NickelsLab/open-source-rover/electrical/pcb/README.md

# Control Board Assembly, v2.0.3

The overall Control Board consists of a Motor Board with a Brain Board mounted on top. These are the instructions to assemble these two separate pcbs and mount them together as the unified control board.

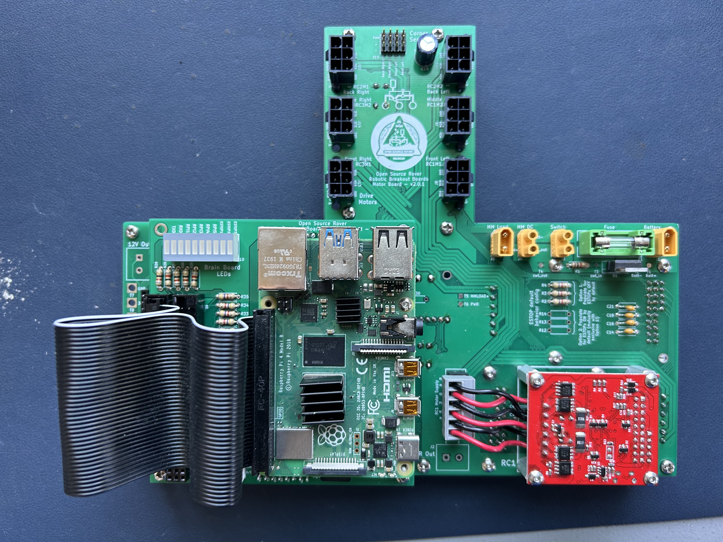
[picture p1: electrical/pcb/images/assembled/complete_pcb_top.jpg]


This document goes through the process of assembling and testing the custom
Printed Circuit Boards for the project. 

Note that the images in these instructions are taken from an assembly of the v2.0.1 board. There are minimal differences between v2.0.1 and v2.0.3 - such that it wasn't worth doing another photoshoot for v2.0.3. Make sure to follow the written instructions when in doubt.

## Table of Contents
1. [Part References](#1-part-references)
2. [Schematic and Layout Documentation](#2-schematic-and-layout-documentation)
3. [Motor Board Assembly](#3-motor-board-assembly)
4. [Brain Board Assembly](#4-brain-board-assembly)
5. [Motor Board and Brain Board Mating](#5-motor-board-and-brain-board-mating)
6. [Testing the PCB and wiring for the Drive Motors](#6-testing-the-pcb-and-wiring-for-the-drive-motors)

## 1. Part References 

Check out the [BOM documents](control_board/BOM)

All parts referenced in these instructions use the schematic "reference designator" from the silk screen on the pcbs. E.g. "C1", "J2", and "R28". You should look up the details of these parts within the [v2.0.3 BOM the board ref parts spreadsheet](control_board/BOM/bom_v2.0.3_board_ref_parts.csv) or the [v2.0.3 BOM other parts spreadsheet](control_board/BOM/bom_v2.0.3_other_parts.csv). This will tell you the unique ID of the part that we use for ordering from Digikey + elsewhere, and will also link to pictures of the part on the relevant website.

Generally these instructions have enough images to clearly show and identify the parts, but whenever in doubt the best thing to do is to look up the reference in the BOM spreadsheet.

## 2. Schematic and Layout Documentation

You can see the KiCAD files in the repo, or see documentation of both the schematics (how all the
electrical parts logically connect to one another) and the layout (how the parts are physically
placed on the boards) in the [control_board/documentation](control_board/documentation) directory.
The documentation directory contains:
- [control_board/documentation/3d_images](control_board/documentation/3d_images) - renderings of each of the two boards
- [control_board/documentation/layout](control_board/documentation/layout) - SVG files of each layer individually and of the entire board, for both boards.
- [control_board/documentation/schematics.pdf](control_board/documentation/schematics.pdf) - schematics as a PDF

For notes on *why* the schematic is drawn the way it is -- KiCad power-port and
PWR_FLAG conventions, the reference-designator policy when revving the board, and
per-component notes on the LM358, Roboclaw, RPi, regulators, INA260 and PCA9685 --
see [control_board/README_schematic.md](control_board/README_schematic.md).

## 3. Motor Board Assembly

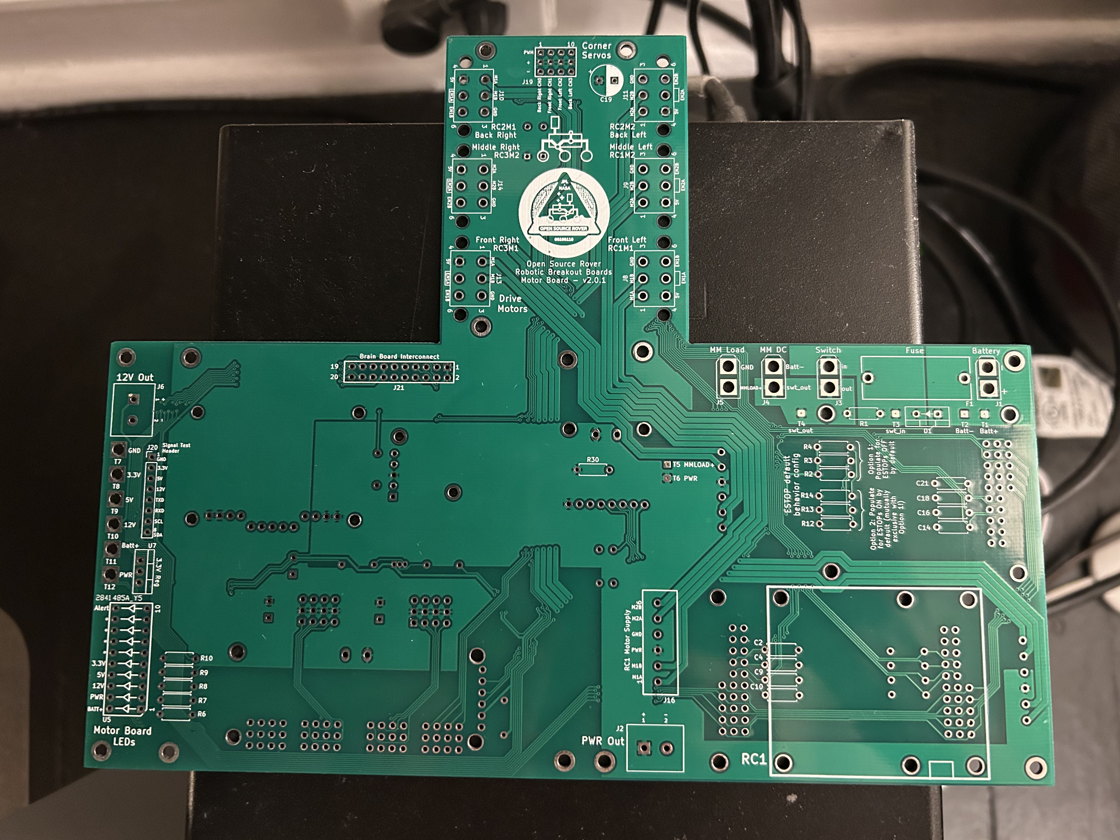
[picture p2: electrical/pcb/images/assembly/bare_board.jpg]
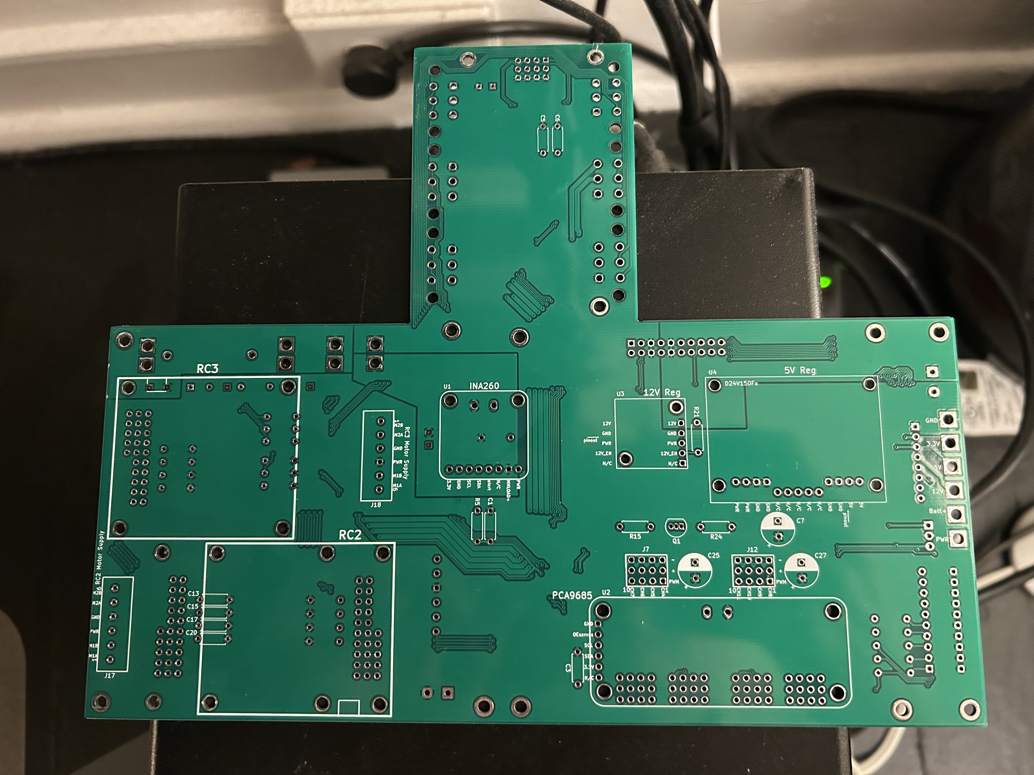
[picture p3: electrical/pcb/images/assembly/bare_board_bottom.jpg]
|    |
|:-:|
| Figure 3.0: front (left) and back (right) of motor board |

### 3.1 Attach standoffs

Attach M2.5 x 30mm standoffs to the bare board, for ease of future soldering work.

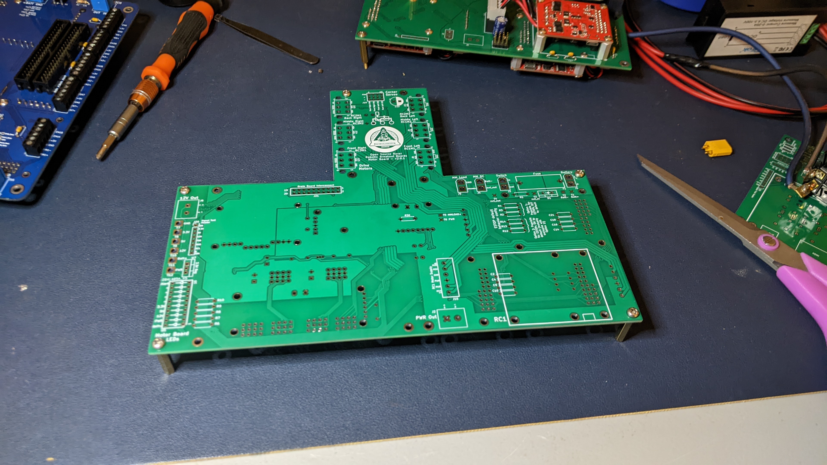
[picture p4: electrical/pcb/images/assembly/PXL_20230413_052035126.jpg]
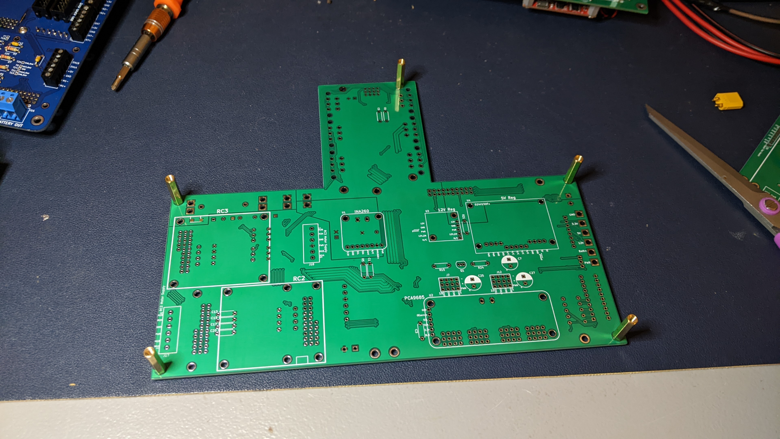
[picture p5: electrical/pcb/images/assembly/PXL_20230413_052039855.jpg]
|   |
|:-:|
| Figure 3.1: Standoffs attached |

### 3.2 Solder on power headers and fuse holder

Solder on the XT30 headers for footprints J1, J3, J4, and J5, as well as the fuse holder F1.

Make sure to choose the proper XT30 header for the corresponding J footprint:
- J1: male
- J3: female
- J4: female
- J5: male
See the images to clarify which one is which.

The pins on the XT30 will be slightly smaller than the holes on the board - this is fine, just make sure to use a lot of solder to connect them so there's a good mechanical connection. The soldering should be fairly straightforward once you start. 

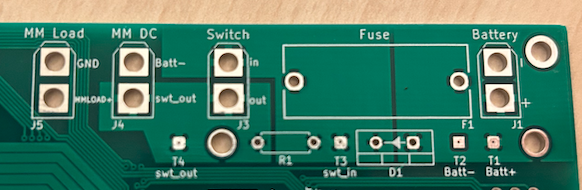
[picture p6: electrical/pcb/images/assembly/power_headers.png]
|  |
|:-:|
| Figure 3.2: Power headers + fuse holder footprints |

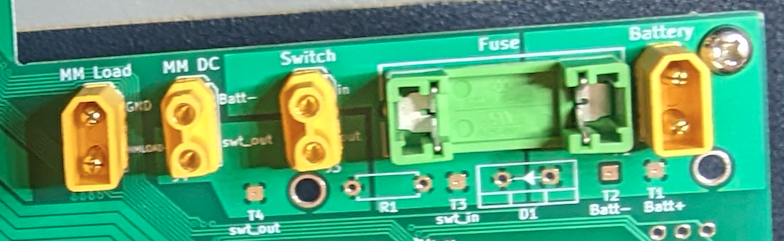
[picture p7: electrical/pcb/images/assembly/power_headers_attached.png]
|  |
|:-:|
| Figure 3.3: Power headers + fuse holder attached |

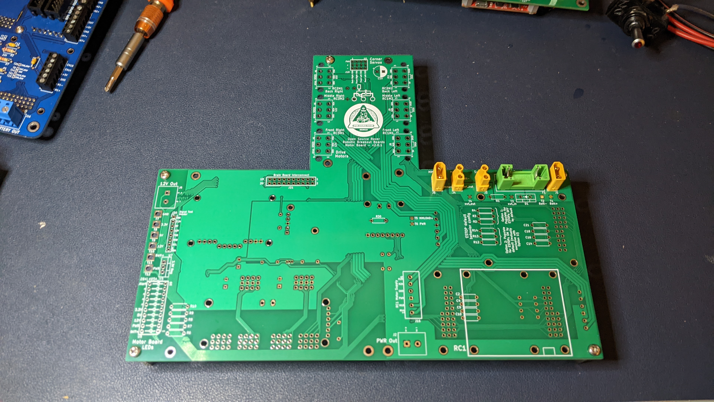
[picture p8: electrical/pcb/images/assembly/PXL_20230413_052422615.jpg]
|  |
|:-:|
| Figure 3.4: Power headers and fuse holder attached, zoomed out |

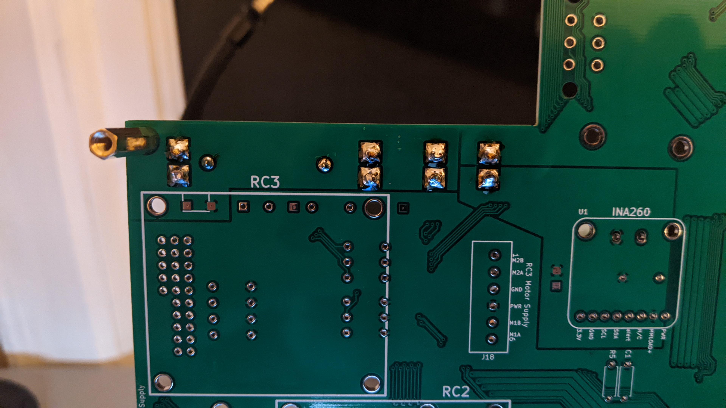
[picture p9: electrical/pcb/images/assembly/PXL_20230413_054441445.jpg]
|  |
|:-:|
| Figure 3.5: Close up view of soldered footprints for headers |

### 3.3 Solder resistor R1 and power diode D1

Make sure to attach D1 in the correct orientation!

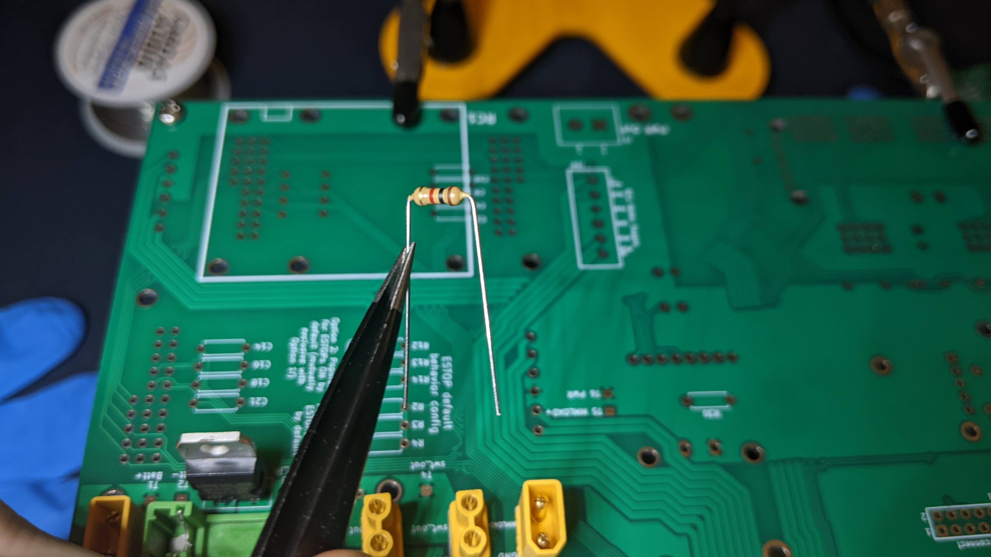
[picture p10: electrical/pcb/images/assembly/PXL_20230413_054943541.jpg]
|  |
|:-:|
| Figure 3.6: Resistor R1 |

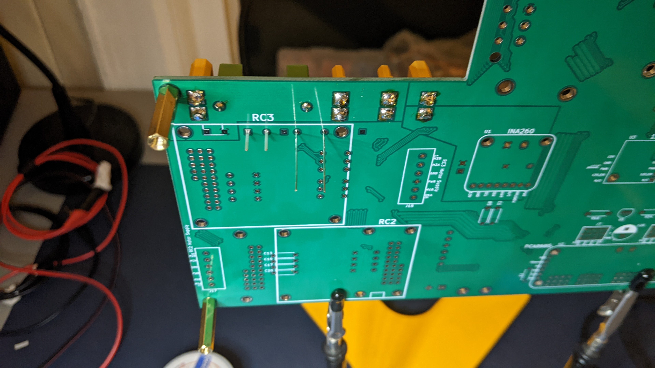
[picture p11: electrical/pcb/images/assembly/PXL_20230413_055134872.MP.jpg]
|  |
|:-:|
| Figure 3.7: Through hole leads for R1 and D1 |

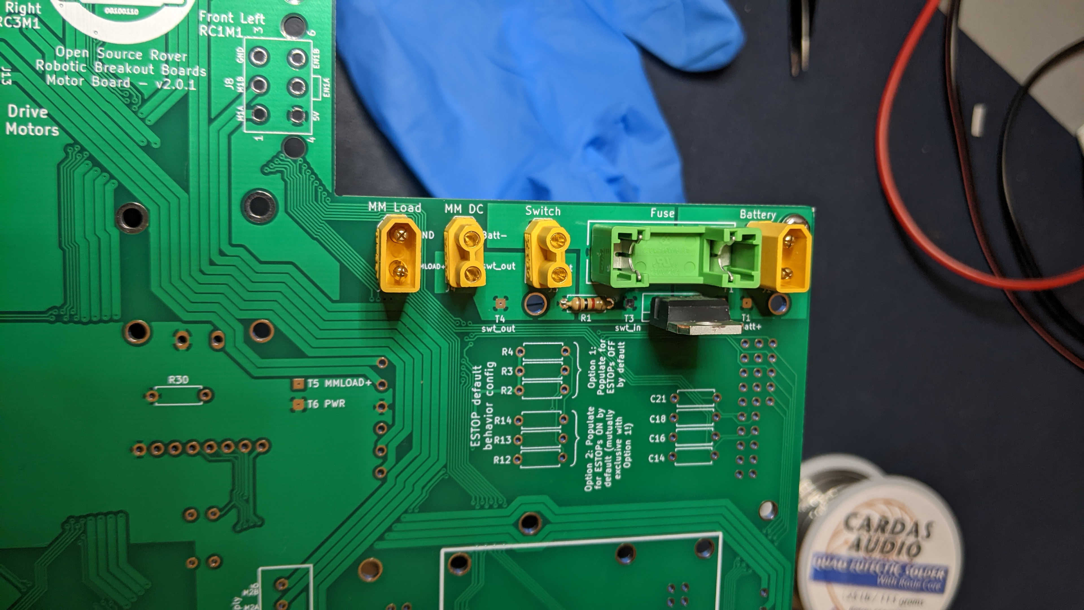
[picture p12: electrical/pcb/images/assembly/PXL_20230413_055558226.jpg]
|  |
|:-:|
| Figure 3.8: R1 and D1 attached |

### 3.4 Test the power connectors

Insert a fuse (part# B1) into the fuse holder (as shown in Figure 3.8 below)

Using the appropriate matching XT30 connectors, connect the power headers to a power supply (or your battery), the main external power switch (part# B9), and the multimeter (part# B10)

Use these diagrams to determine how to wire things together:

When testing with a power supply, provide 14.8V DC and current limit to 1.0A. Just to the left of the main fuse is a XT30 connector labeled "Switch" – this if for the main on/off toggle switch. The XT30 connectors labeled MM Load and MM DC connect to the multimeter box.

> [!Note]
> If you have already installed capacitors on the board, it is normal for power header J5 (MM Load) to briefly beep for less than a second when testing for continuity after soldering the power headers. This occurs because the capacitors momentarily charge. This behavior is expected and does not indicate a short circuit.

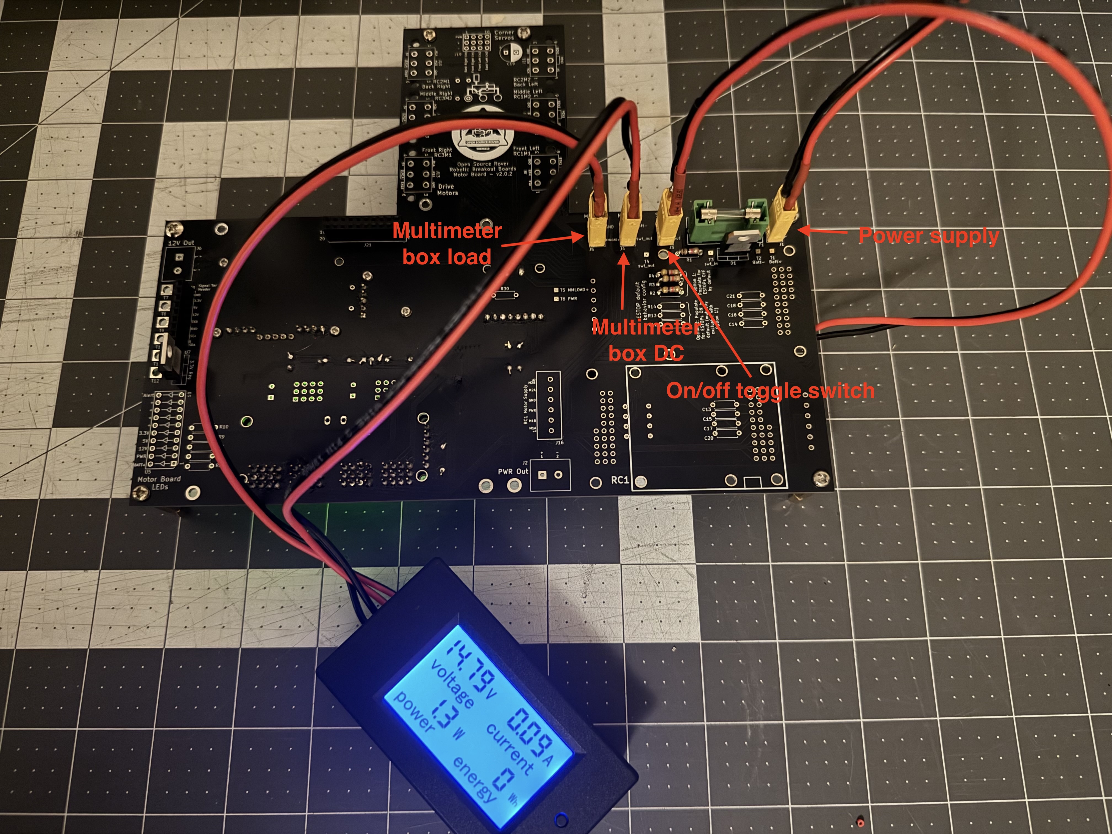
[picture p13: electrical/pcb/images/assembly/controlboard-power-headers.jpeg]
 |  |
|:-:|
| Figure 3.9: Power headers connected to the power supply, on/off toggle switch (out of view under the PCB) and multimeter box. |

After testing, make sure to disconnect the power supply.

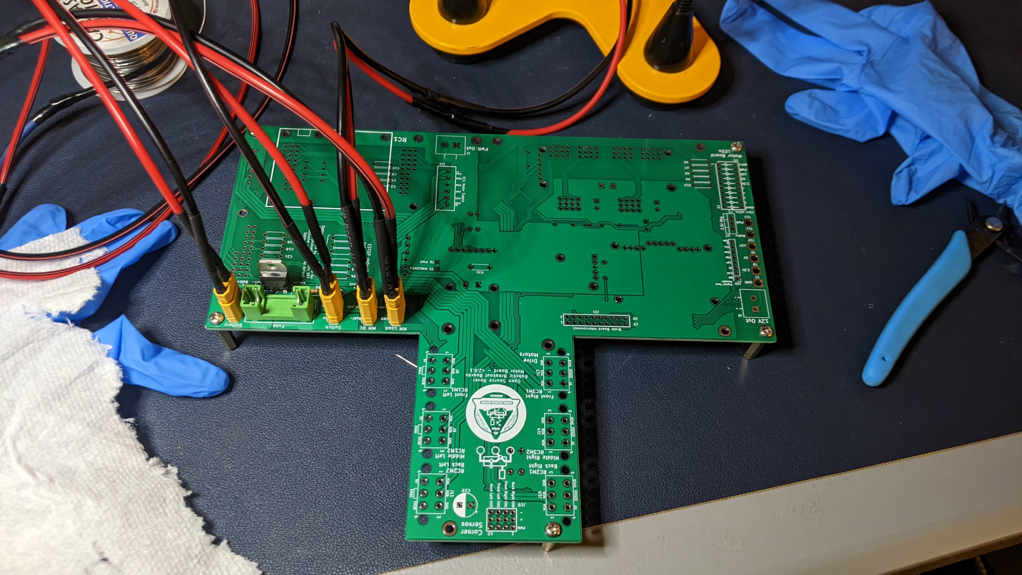
[picture p14: electrical/pcb/images/assembly/PXL_20230413_061454863.jpg]
|  |
|:-:|
| Figure 3.10: Wires connected to power headers |

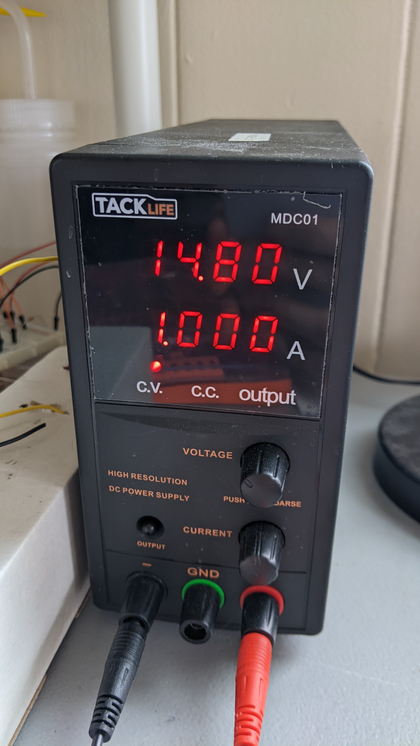
[picture p15: electrical/pcb/images/assembly/PXL_20230416_234516660.jpg]
|  |
|:-:|
| Figure 3.11: Power supply providing 14.8V DC and current limited to 1.0A |

Use a multimeter to test the voltage between test points T4 ("swt_out") and T2 ("Batt-"). This should read the same value as input from the power supply/battery (14.8V)

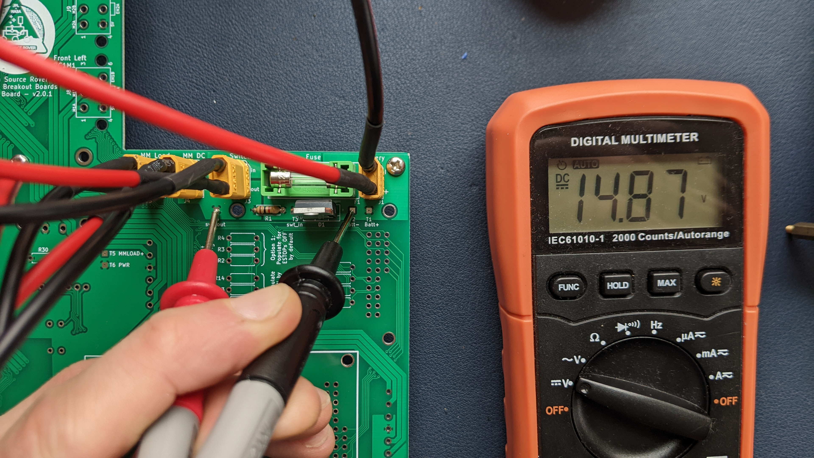
[picture p16: electrical/pcb/images/assembly/PXL_20230416_234547696.jpg]
|  |
|:-:|
| Figure 3.12: Testing the voltage between T4 and T2 |

Also check the voltage shown by the multimeter. This should show the same voltage as well.

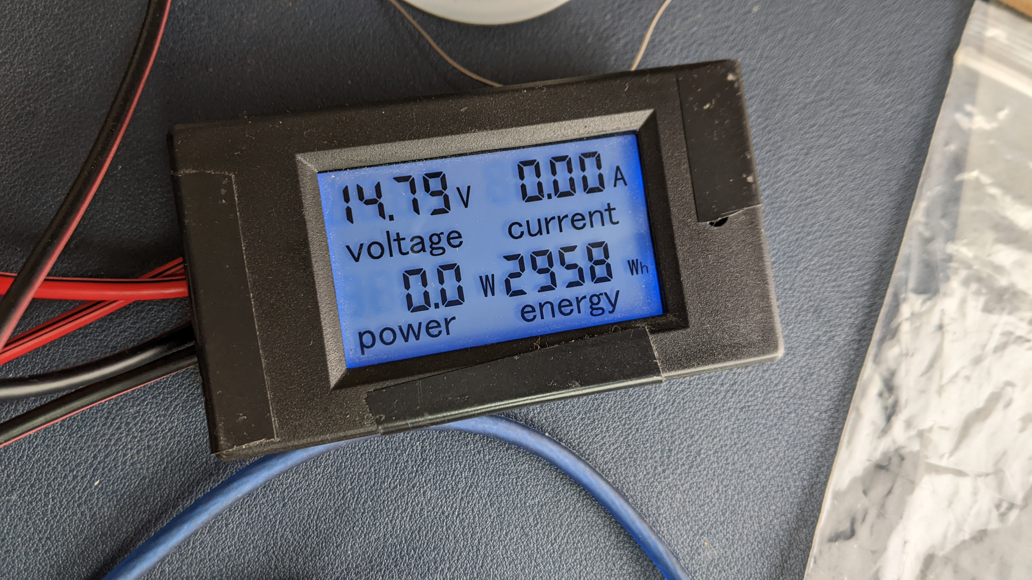
[picture p17: electrical/pcb/images/assembly/PXL_20230416_234553055.jpg]
|  |
|:-:|
| Figure 3.13: Testing the power input to the multimeter |

### 3.5 Install the INA 260

:exclamation: Before continuing, make sure to disconnect the power supply from the previous step! You should not have the board powered on while installing components. :exclamation:

The INA260 daughter board is used for digital sensing of voltage and current, measurements that the raspberry pi can query over an I2C connection. Unfortunately, it can be hard to find these INA260 parts nowadays - if you can't find one you will need to bypass U1, because it is in the path of the battery positive side supply.

**Option 1: If you have an INA260 daughter board, you should install that in footprint U1 on the bottom side of the motor board.**

See [control_board/README_schematic.md](control_board/README_schematic.md) for part numbers for inter-board pins and sockets.

1. Attach 8x1 female header sockets to the eight pads on the bottom side of the INA260 / U1 footprint, as seen in Figure 3.14.  This is sensing the current on the high side of the power, so PWR on the the Motor Board is connected to Vin+ on the INA260, and Vin- on the INA260 is connected to MMLOAD+, which connects to the main power bus of the rover.
2. Attach 3x1 female header socket (cut from a longer Nx1 header) to the two pads on the bottom side of the INA260 / U1 footprint, as seen in Figure 3.14. You'll need to manually remove the center pin, as there is no hole/pad on the brain board.

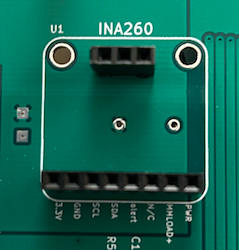
[picture p18: electrical/pcb/images/assembly/ina260_headers.png]
|  |
|:-:|
| Figure 3.14: Sockets on U1 footprint installed |

3. Attach 8x1 male header pins to the underside of the INA260, as seen in Figure 3.15
4. Remove the center pin from a 3x1 male header pins, and solder to the INA260.

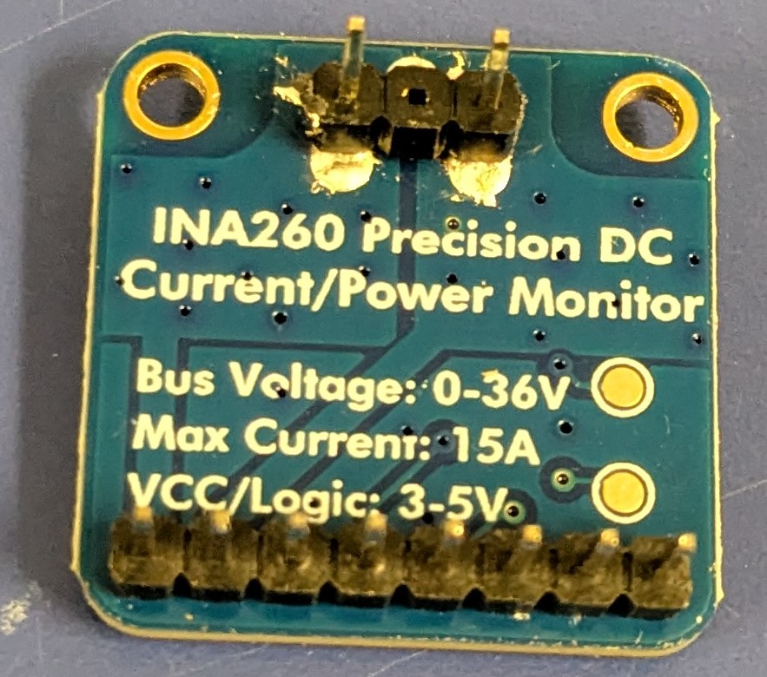
[picture p19: electrical/pcb/images/assembly/INA260_Bottom.jpg]
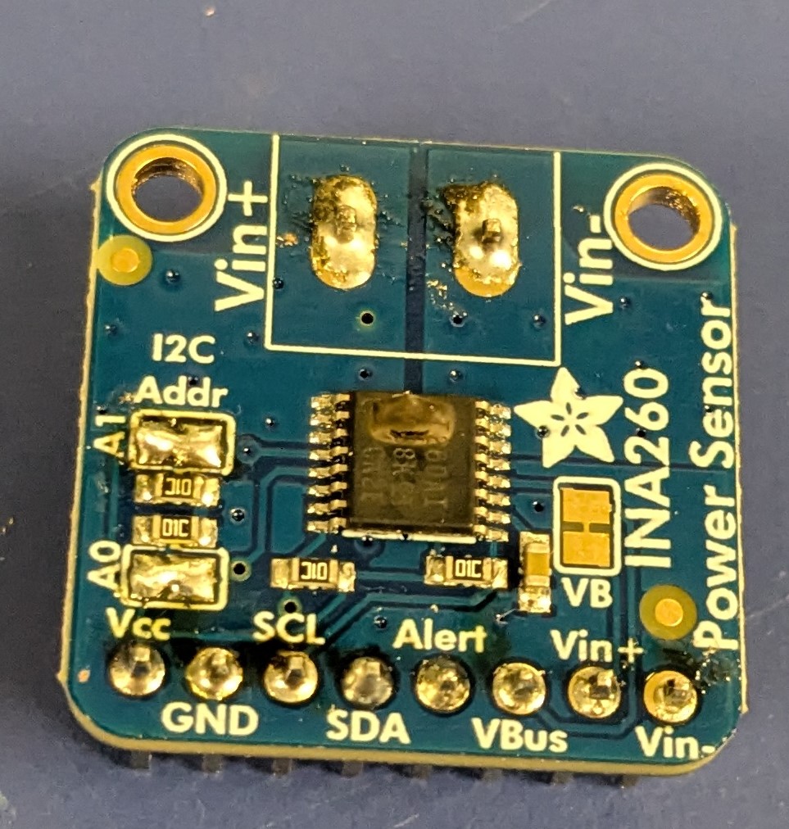
[picture p20: electrical/pcb/images/assembly/INA260_Top.jpg]
|   |
|:-:|
| Figure 3.15: INA260 Pins installed |

5. Solder across pads A0 and A1 on the INA260 (to set it to use I2C Address 0x45)
6. Insert the INA260 male pins into the U1 female sockets, as shown in Figure 3.16
6. Optionally, install M2.5 x 12mm + 6mm standoffs between the motor board and the INA260.

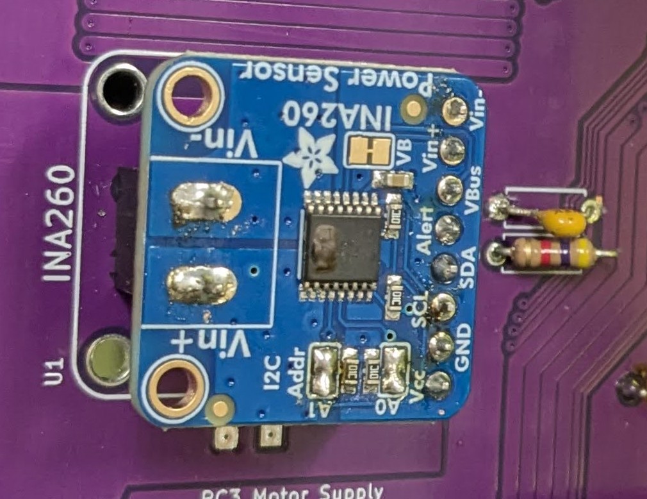
[picture p21: electrical/pcb/images/assembly/INA260_Installed.jpg]
|  |
|:-:|
| Figure 3.16: Headers on INA260 installed |

**Option 2: If you don't have one, you will need to bypass U1**

If you don't have an INA260, simply install a 0 ohm resistor (or a wire) in footprint R30, on the top side of the board, as shown in Figure 3.17.

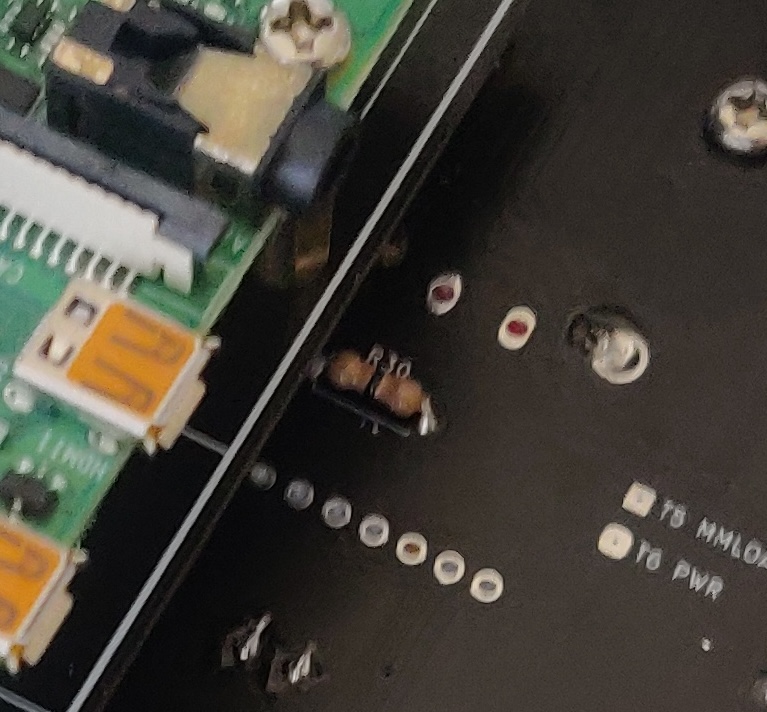
[picture p22: electrical/pcb/images/assembly/ina260_bypass.jpg]
|  |
|:-:|
| Figure 3.17: INA260 bypassed |

### 3.6 Install 5V bus regulator

This is the power regulator for the 5V line, which powers all the motors.

Install 3 female headers for the daughter board, into U4. You will need a two 4x1's, and a 5x1.

|  |
|:-:|
| Figure 3.18: 5V regulator headers installed |

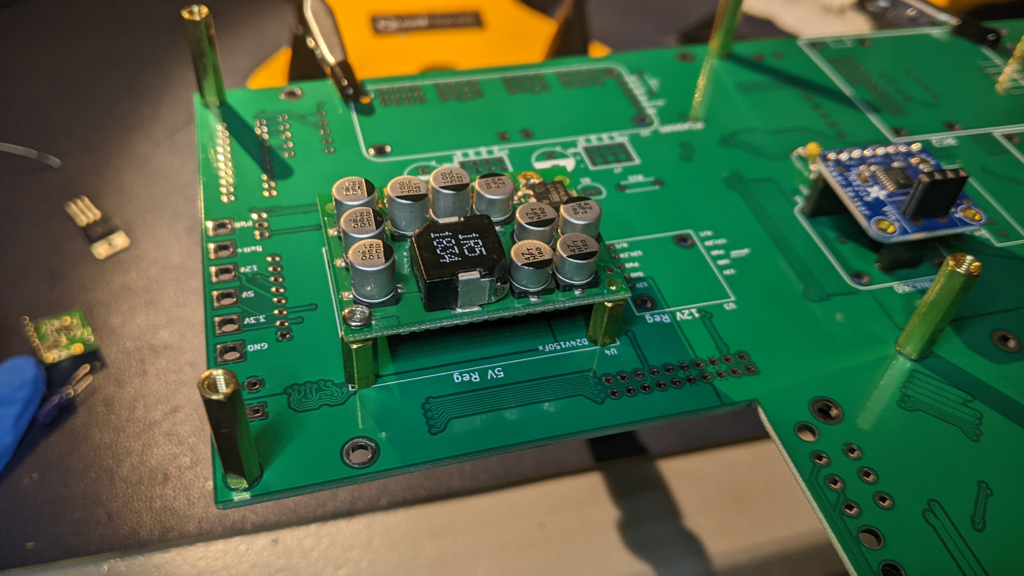
[picture p23: electrical/pcb/images/assembly/PXL_20230418_044810169.jpg]
|  |
|:-:|
| Figure 3.19: 5V regulator installed |

### 3.7 Install 12V bus regulator U3

Solder a 5x1 female header to the U3 footprint, and attach M2.5 x 10mm standoffs between the regulator and motor board

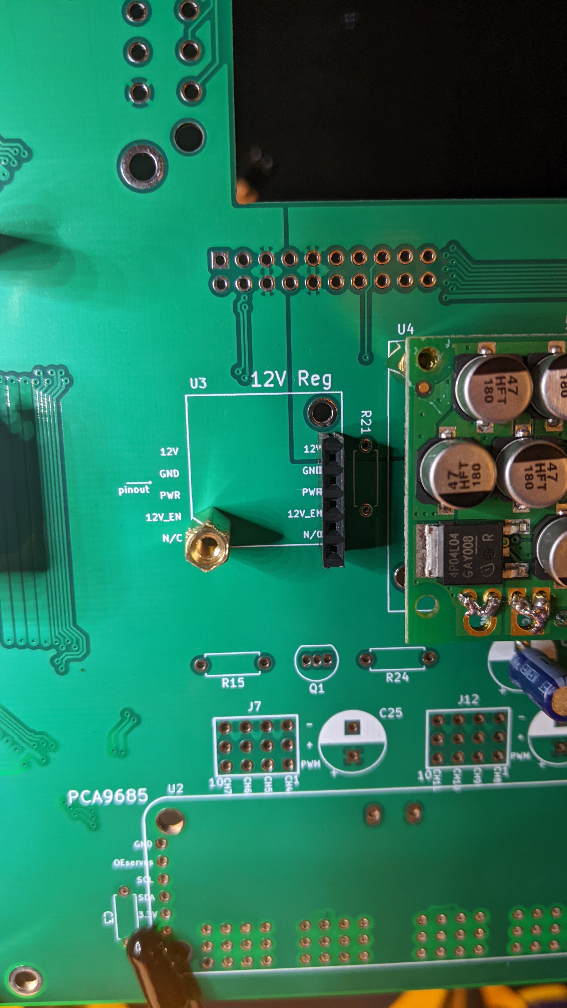
[picture p24: electrical/pcb/images/assembly/PXL_20230418_050503408.jpg]
|  |
|:-:|
| Figure 3.20: U3 footprint |

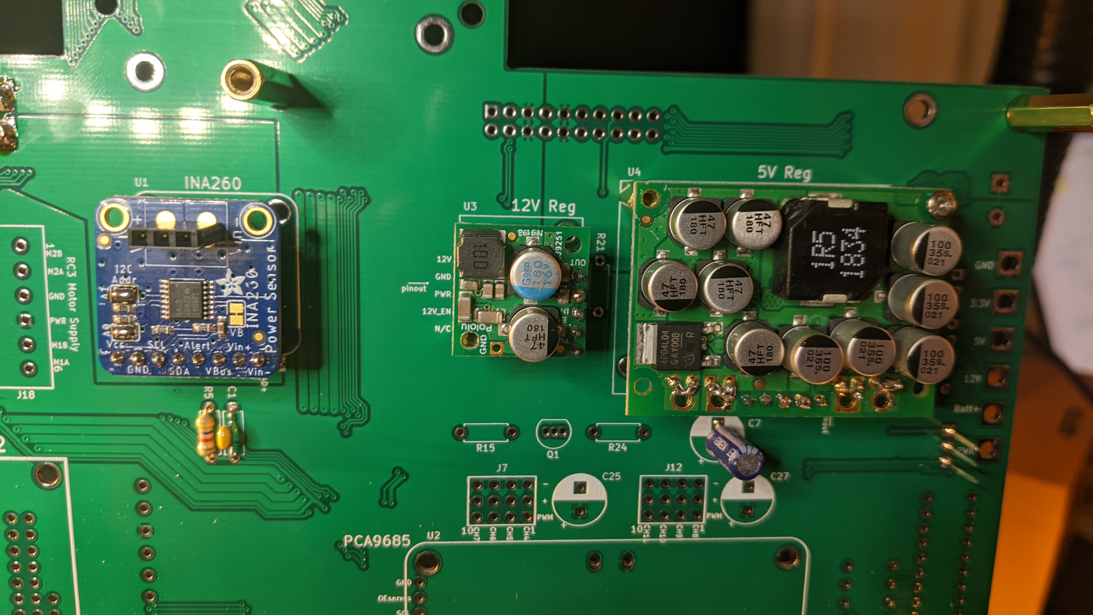
[picture p25: electrical/pcb/images/assembly/PXL_20230418_051040927.jpg]
|  |
|:-:|
| Figure 3.21: 12v regulator installed |

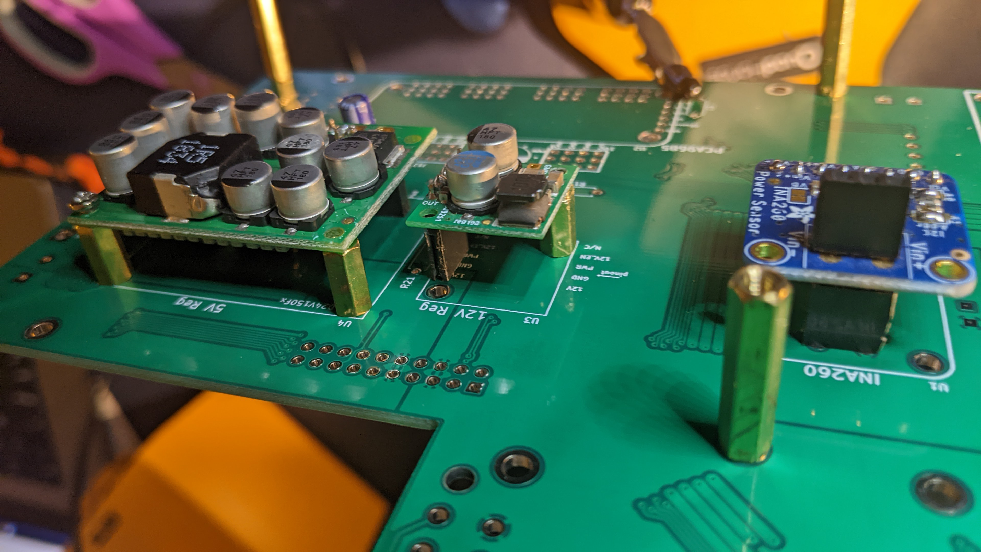
[picture p26: electrical/pcb/images/assembly/PXL_20230418_051046001.MP.jpg]
|  |
|:-:|
| Figure 3.22: 12v regulator installed (2) |

### 3.8 Install 3.3V bus regulator U7 and decoupling capacitor C7

The 3.3V bus regulator is a linear voltage regulator and is physically much smaller - it comes in the same packaging as diode D1. Make sure to install the regulator in the correct direction as shown in Figure 3.24.

Capacitor C7 is the decoupling capacitor for the 3.3v bus. Make sure to install C7 in the proper direction, as shown in Figure 3.25. One side of the capacitor has negative polarity indicators on it, that should be installed opposite the "+" sign on the footprint.

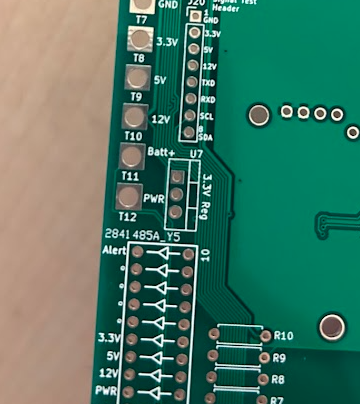
[picture p27: electrical/pcb/images/assembly/u7_bare.png]
|  |
|:-:|
| Figure 3.23: U7 footprint |

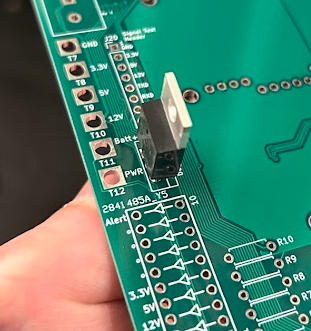
[picture p28: electrical/pcb/images/assembly/u7_installed.png]
|  |
|:-:|
| Figure 3.24: 3.3v regulator installed in U7 |

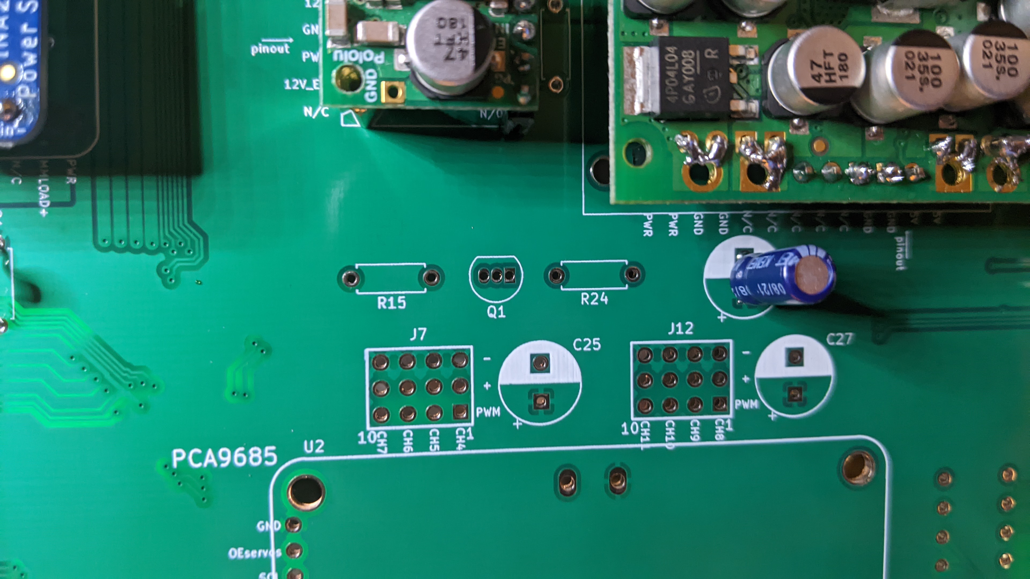
[picture p29: electrical/pcb/images/assembly/PXL_20230418_051556901.MP.jpg]
|  |
|:-:|
| Figure 3.25: Capacitor C7 installed |

### 3.9 Install resistors R15, R24, and BJT transistor Q1

These form the circuit for the alert signal LED logic.

|  |
|:-:|
| Figure 3.26: R15, R24, and Q1 footprints |

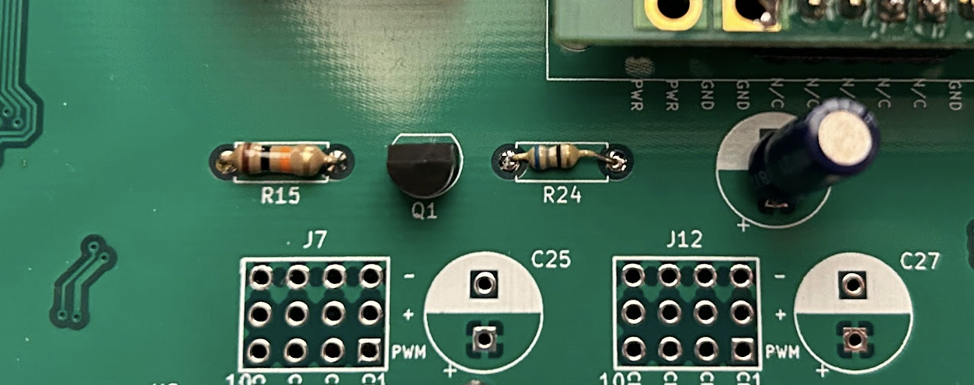
[picture p30: electrical/pcb/images/assembly/alert_led_components.png]
|  |
|:-:|
| Figure 3.27: R15, R24, and Q1 installed |

### 3.10 Test all voltage lines

Test all the power buses/voltage lines using the test points on the far left side of the top side of the board (T7 through T12).

The silk screen right of each hole indicates what voltage each test point should be at.

- First, connect the power supply to your board and provide 14.8v (see step 3.4)
- then, use the multimeter to test the voltage at each test point

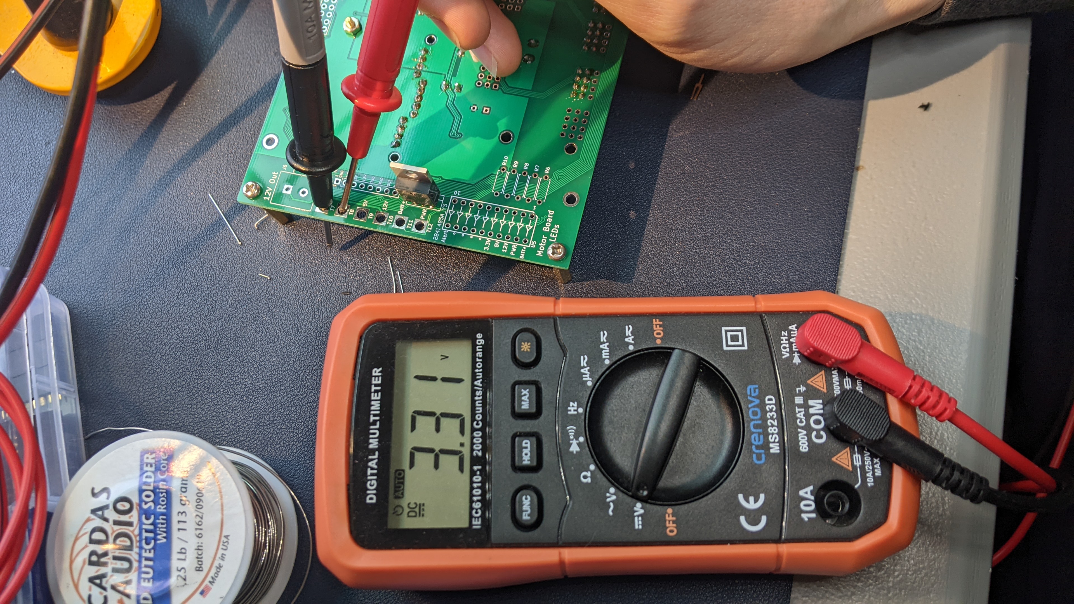
[picture p31: electrical/pcb/images/assembly/PXL_20230424_003614642.jpg]
|  |
|:-:|
| Figure 3.28: testing the 3.3v bus|

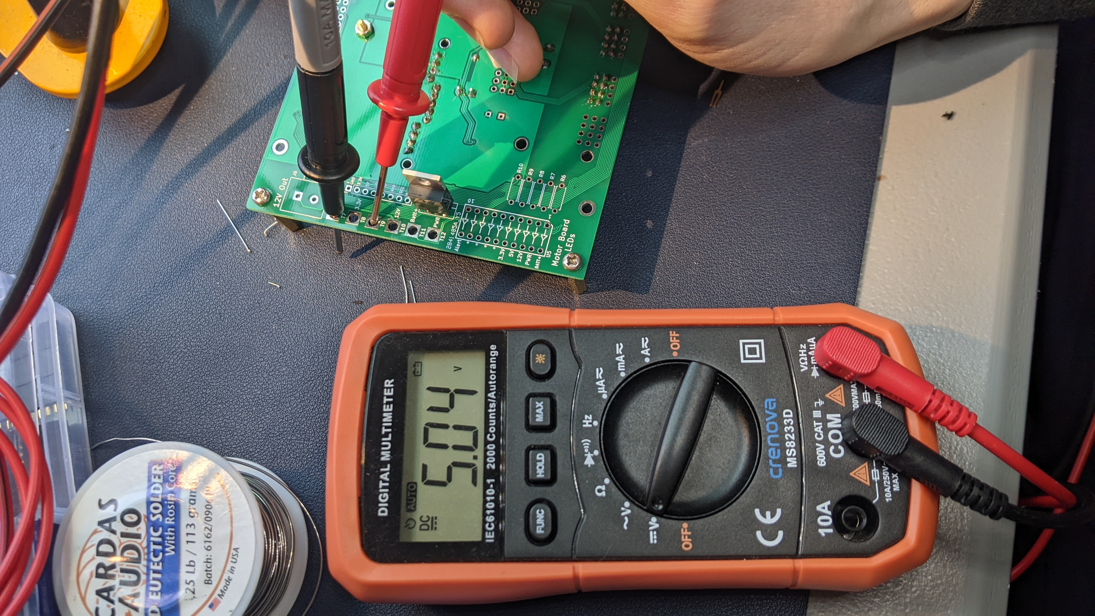
[picture p32: electrical/pcb/images/assembly/PXL_20230424_003617280.jpg]
|  |
|:-:|
| Figure 3.29: testing the 5v bus |

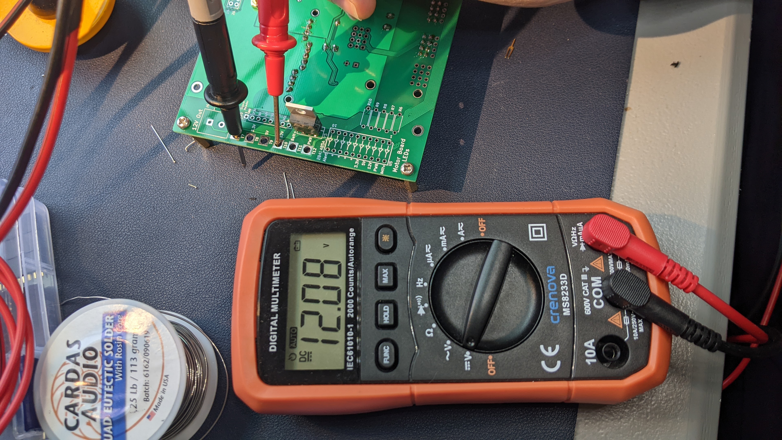
[picture p33: electrical/pcb/images/assembly/PXL_20230424_003620439.jpg]
|  |
|:-:|
| Figure 3.30: testing the 12v bus |

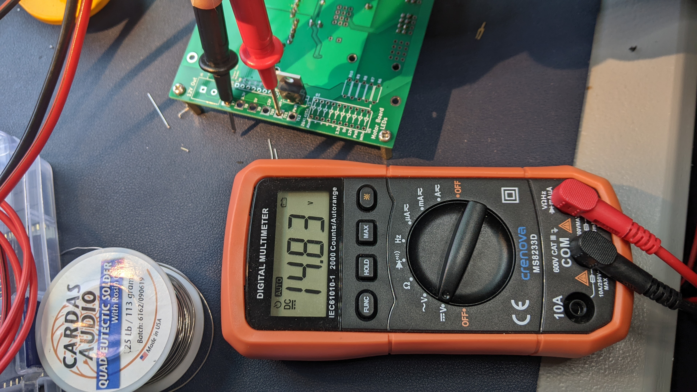
[picture p34: electrical/pcb/images/assembly/PXL_20230424_003626769.jpg]
|  |
|:-:|
| Figure 3.31: testing the Batt+ bus (positive lead from the battery) |

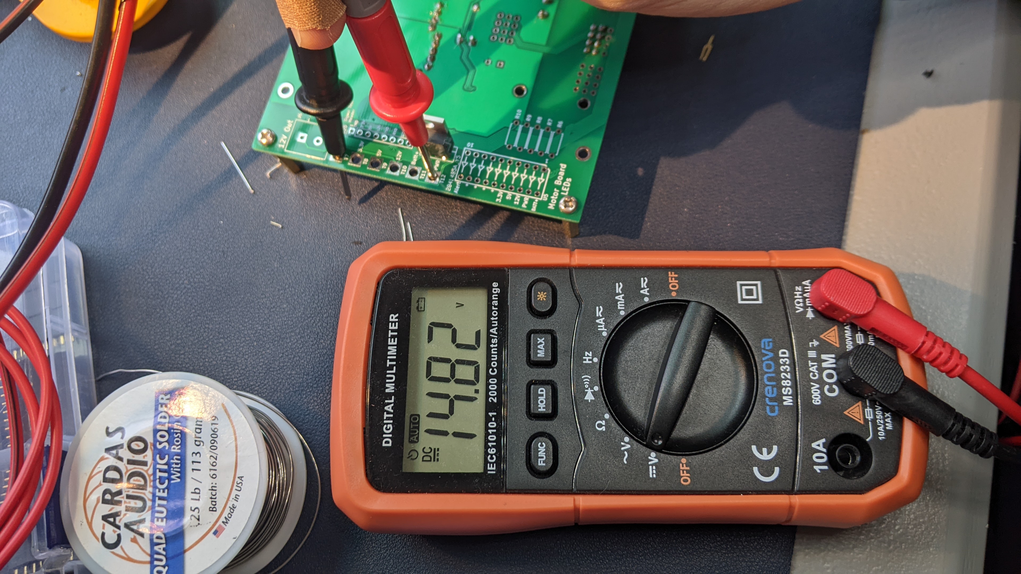
[picture p35: electrical/pcb/images/assembly/PXL_20230424_003630014.jpg]
|  |
|:-:|
| Figure 3.32: testing the PWR bus (main board power plane, after battery protection circuitry ) |

### 3.11 Install PCA9685 daughter board in U2 footprint and capacitor C3

:exclamation: Before continuing, make sure to disconnect the power supply from the previous step! You should not have the board powered on while installing components. :exclamation:

The PCA9685 is a PWM signal source, which we use as our corner motor controller.

First you will need to install female headers on the motor board, for the PCA9685 daughter board to mate with. You'll need: 
- 6x1 female header
- 3x 2x4 female headers

You **may** use larger headers to fill all the holes in the U2 footprint, but it's not really necessary for the normal working configuration of the motor board. Attach these headers to the appropriate spots in the U2 footprint, as shown in Figure 3.33.

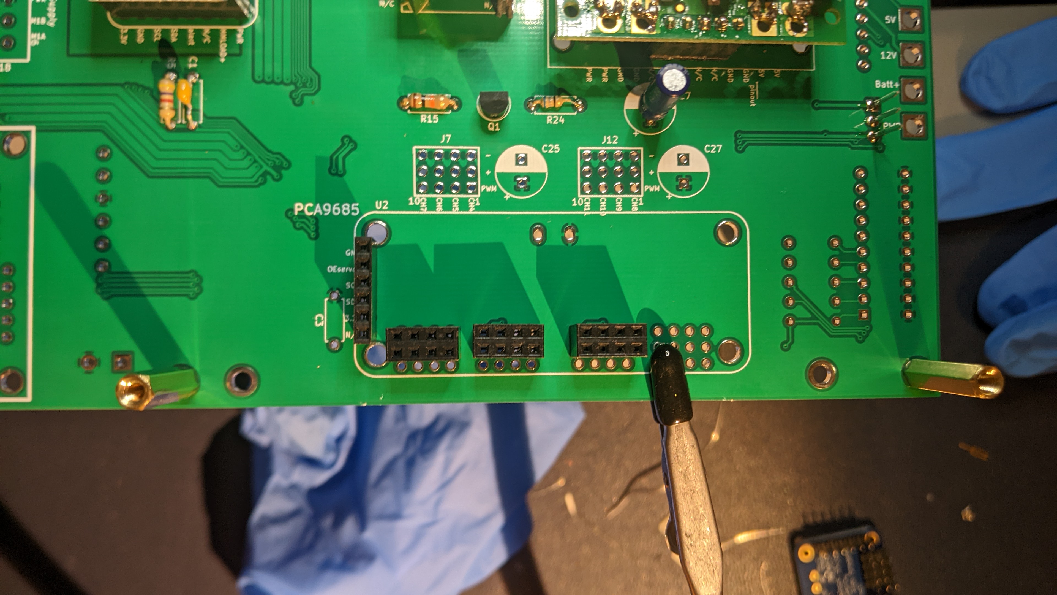
[picture p36: electrical/pcb/images/assembly/PXL_20230418_053133239.jpg]
|  |
|:-:|
| Figure 3.33: U2 with female headers installed |

You will need to attach male headers to the PCA9685 daughter board, as shown in Figure 3.34. 

Also, 5v power is provided to the PCA9685 through the two holes at the top of the U2 header. You have a couple options for this.

**Option 1 - Wires**
To connect these, I soldered 2 small wire leads on the PCA9685 daughter board, and then soldered them on to the motor board once I installed the PCA9685.

**Option 2 - 1x1 Pins/Headers**
The V+ and GND on the PCA9685 don't exactly line up with the GND_motor and +5V_motor pins on the Motor board, but are close enough you can make them connect with two 1x1 pins on the PCA9685 and two 1x1 headers on the Motor board, as shown in Figure 3.35.

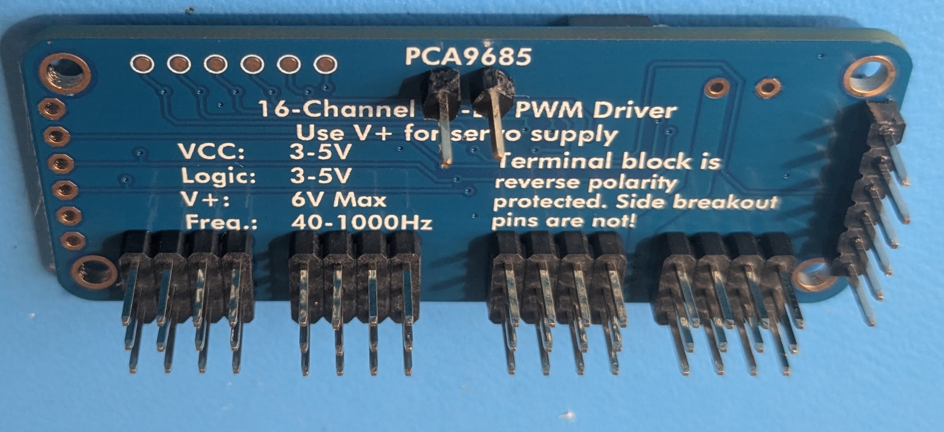
[picture p37: electrical/pcb/images/assembly/pca9685_headers.jpg]
|  |
|:-:|
| Figure 3.34: Male headers soldered onto PCA9685 daughter board |

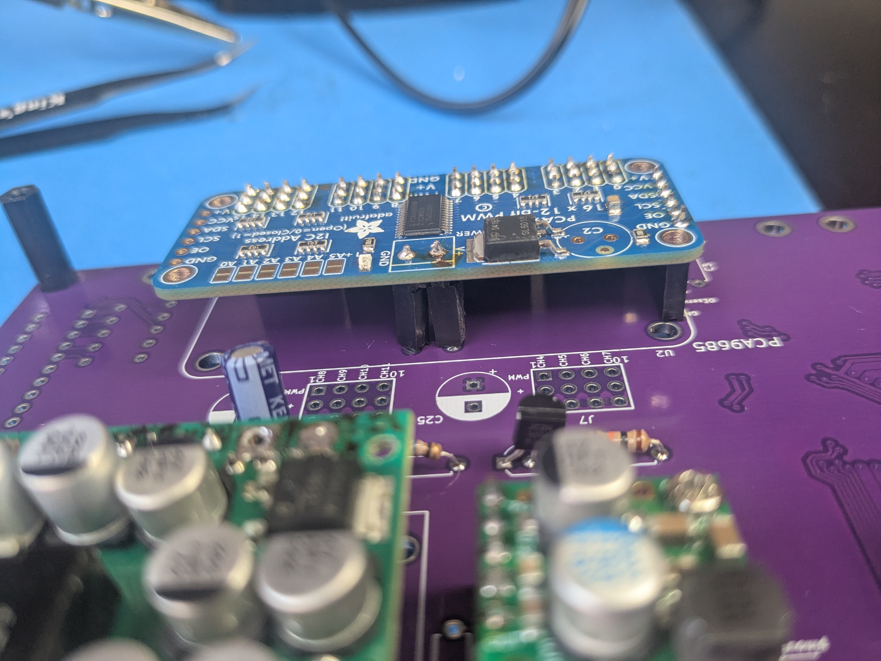
[picture p38: electrical/pcb/images/assembly/pca9685_installed.jpg]
|  |
|:-:|
| Figure 3.35: PCA9685 installed in motor board |

Finally install capicator C3 as shown in Figure 3.36.

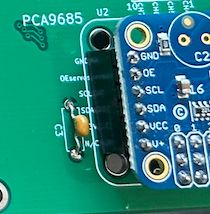
[picture p39: electrical/pcb/images/assembly/c3_installed.png]
|  |
|:-:|
| Figure 3.36: C3 installed |

### 3.12 Install resistor R5 and capacitor C1

These are aids for the INA260, and can be left out if the IN260 is not used

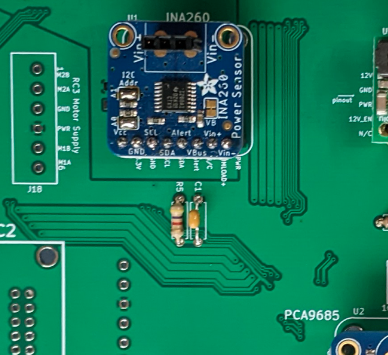
[picture p40: electrical/pcb/images/assembly/r5_c1.png]
|  |
|:-:|
| Figure 3.37: PCA9685 installed in motor board |

### 3.13 Install J21, J20, and resistors R6,R7,R8,R9,R10

J21 is the interconnect header for the brain board, and J20 is a signal test header for the motor board

Use an 8x1 female header for J20.

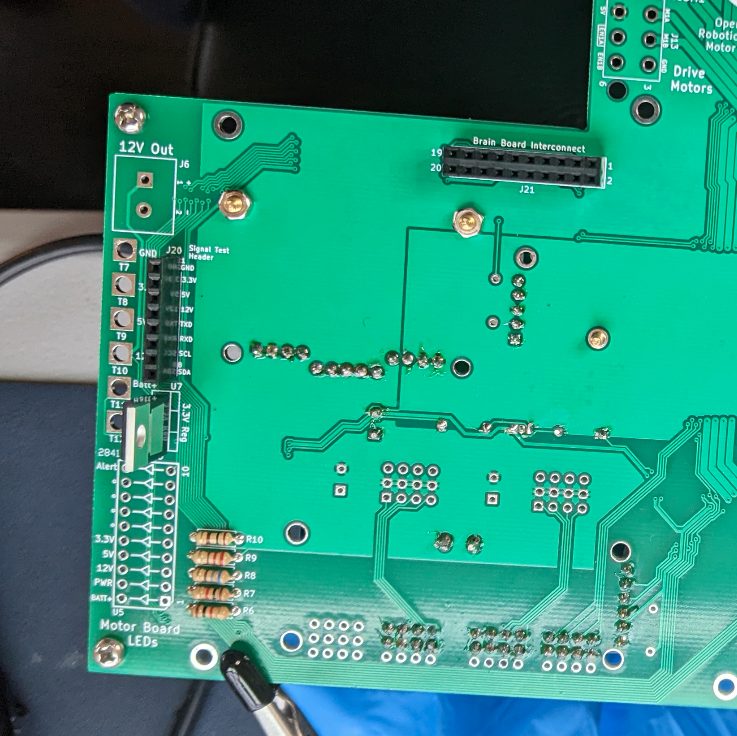
[picture p41: electrical/pcb/images/assembly/j20_j21_r6_r10.png]
|  |
|:-:|
| Figure 3.38: Components installed, as viewed from top of board |

### 3.14 Test INA260 installation

To test the INA260, you will follow https://learn.adafruit.com/adafruit-ina260-current-voltage-power-sensor-breakout/arduino, and connect an Arduino to GND, SCL, and SDA on J20.  You'll change the initalization step to
```
 if (!ina260.begin(0x45)) {
```
to account for the I2C bus address.  When you turn your power on, you should see something like this in the Arduino serial terminal:
```
Found INA260 chip
Current: 85.00 mA
Bus Voltage: 14456.25 mV
Power: 1230.00 mW
```

### 3.15 Install resistors R2,R3,R4

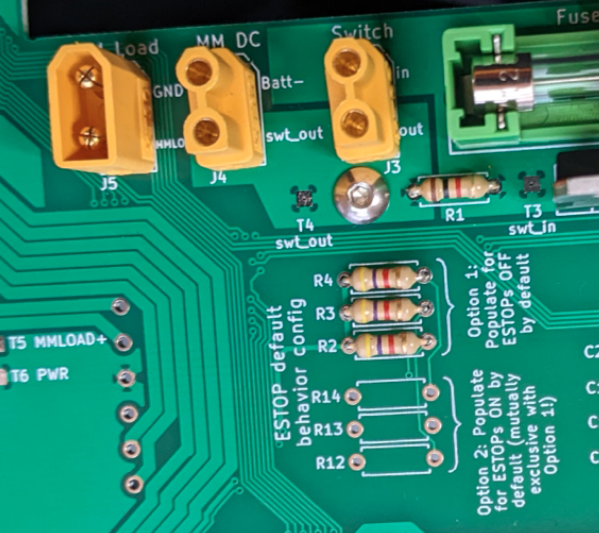
[picture p42: electrical/pcb/images/assembly/r2_r3_r4.png]
|  |
|:-:|
| Figure 3.39: Components installed, as viewed from top of board |

### 3.16 Install Roboclaw standoffs, headers, and capacitors

Now we'll add the parts for roboclaw footprints RC1, RC2, and RC3.

First, install M2.5 x 15mm standoffs for the 3 RC footprints, as shown in Figure 3.40 and 3.41.  

Next, solder in the two female headers for each RC footprint. You'll need a 2x10 and a 5x1 for each RC. These should be soldered into the holes on the side of each RC footprint.

Finally, install the following capacitors for each RC footprint:
- RC1: capacitors C13,C15,C17,C20 (Figure 3.41). Install on the top side of the board.
- RC2: capacitors C2,C4,C9,C10 (Figure 3.40). Install on the underside of the board.
- RC3: capacitors C14,C16,C18,C21 (Figure 3.41). Install on the top side of the board.

Technically, you can install the capacitors on either side of the board, but it makes for a cleaner presentation if you install them where their respective "C" labels are on the board.

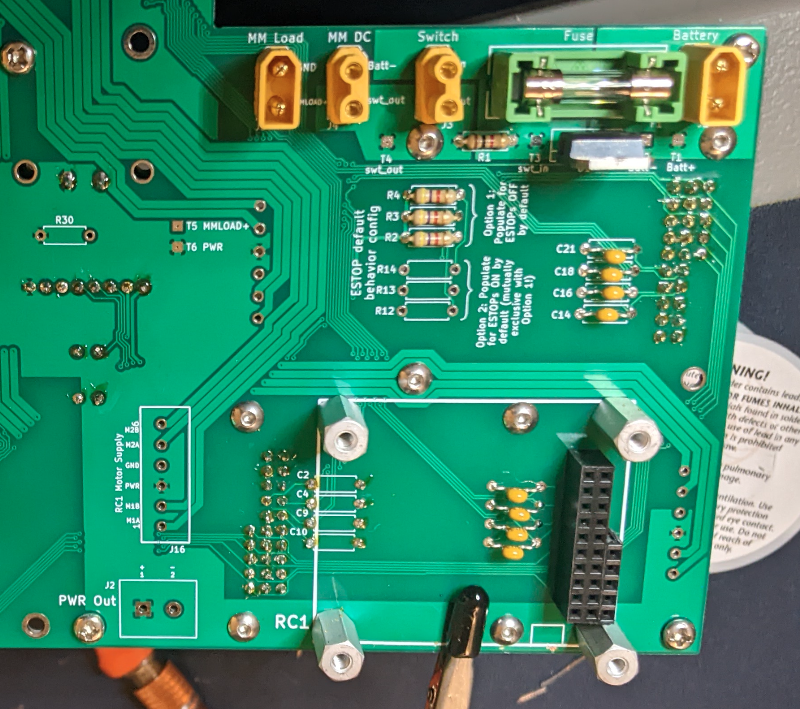
[picture p43: electrical/pcb/images/assembly/rc1_pop.png]
|  |
|:-:|
| Figure 3.40: C2,C4,C9,C10 installed|

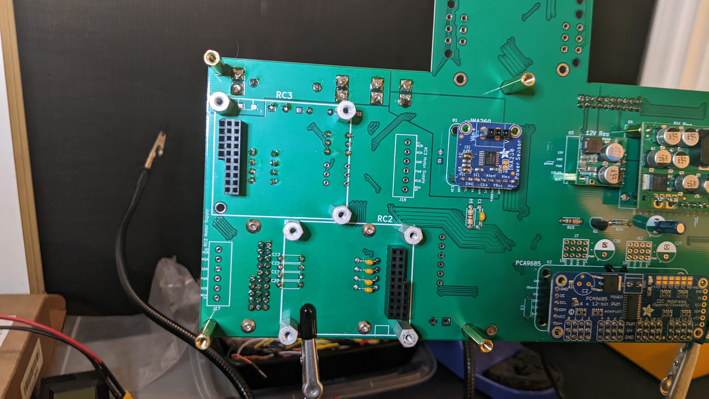
[picture p44: electrical/pcb/images/assembly/PXL_20230425_054908018.jpg]
|  |
|:-:|
| Figure 3.41: C13,C15,C17,C20 and C14,C16,C18,C21 installed|

### 3.17 Install motor supply headers J16,J17,J18

Figure 3.42 shows how these should be installed. J16 on the top of the board is installed in the same way.

Make sure to orient the connector in the proper direction, as indicated in the images. 

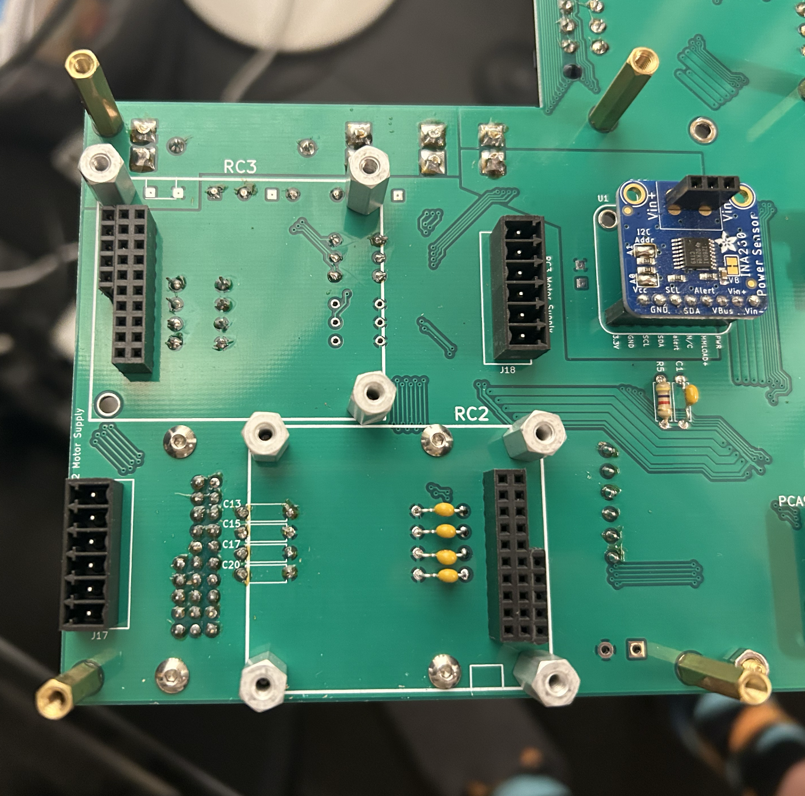
[picture p45: electrical/pcb/images/assembly/motor_supply_headers.png]
|  |
|:-:|
| Figure 3.42: J17 and J18 installed, on bottom of board|

### 3.18 Install 3x Roboclaw boards in footprints RC1, RC2, RC3

First, wire the 6pos terminal block headers to the roboclaw boards, as indicated in Figure 3.43.  Cut the wires to about 5cm and tin the ends.

Unless you have an older version of the PCB (v2.0.2 or earlier), wire the pins in the J16,J17,J18 headers directly to the pins on the corresponding side of the roboclaw - it is a direct 1-to-1 mapping all the way down, with no wires crossed. Use 16AWG wire (18AWG would also be fine)

Do this for all three roboclaws. 

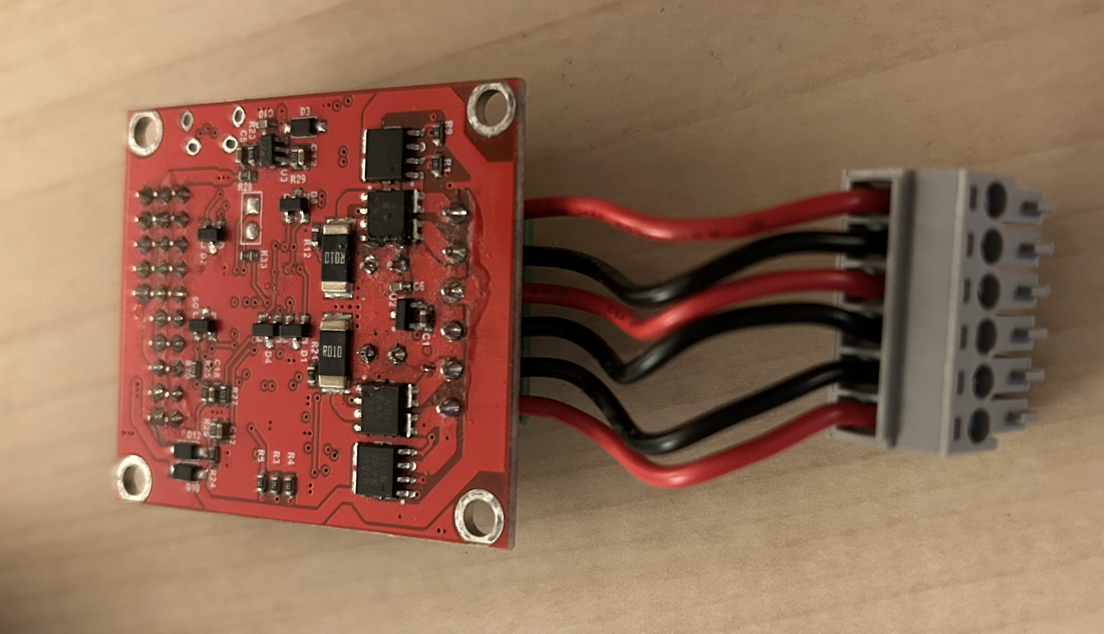
[picture p46: electrical/pcb/images/assembly/roboclaw_wired_1.png]
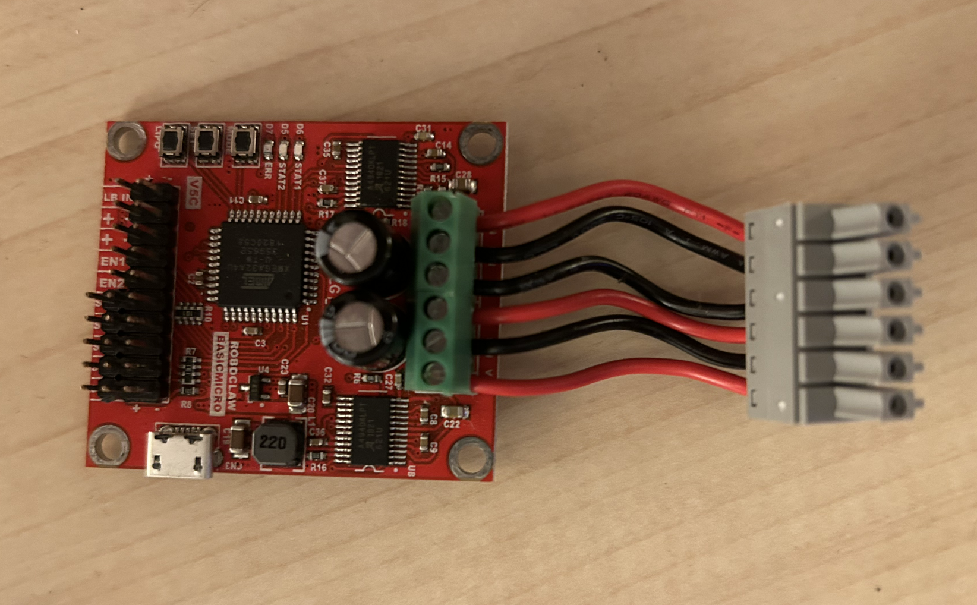
[picture p47: electrical/pcb/images/assembly/roboclaw_wired_2.png]
|    |
|:-:|
| Figure 3.43: Wiring up the roboclaws |

Then install the 3 roboclaws in the RC1, RC2, and RC3 footprints. It doesn't matter which roboclaw goes in which footprint - we will later set unique addresses in software for each of them to communicate over the serial bus.

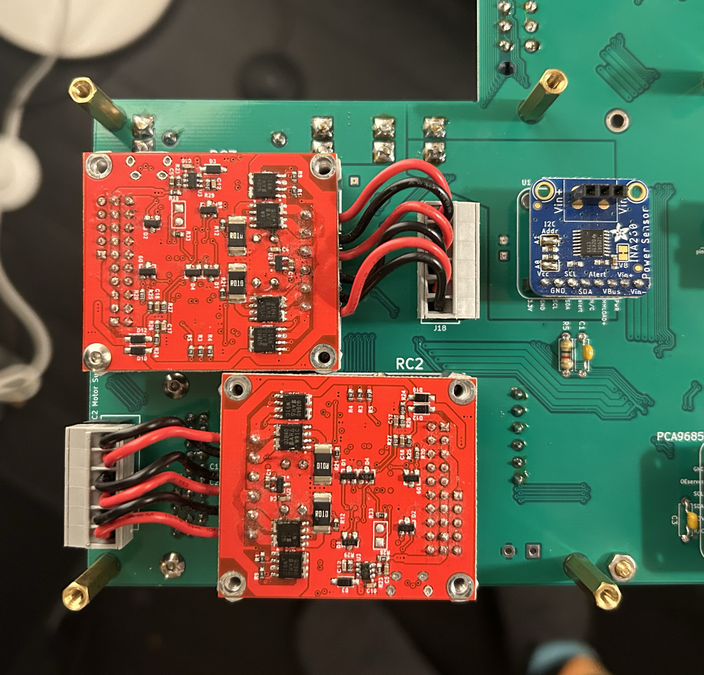
[picture p48: electrical/pcb/images/assembly/roboclaws_installed.png]
|  |
|:-:|
| Figure 3.44: Installing the roboclaw boards |

### 3.19 Install capacitors C5,C6

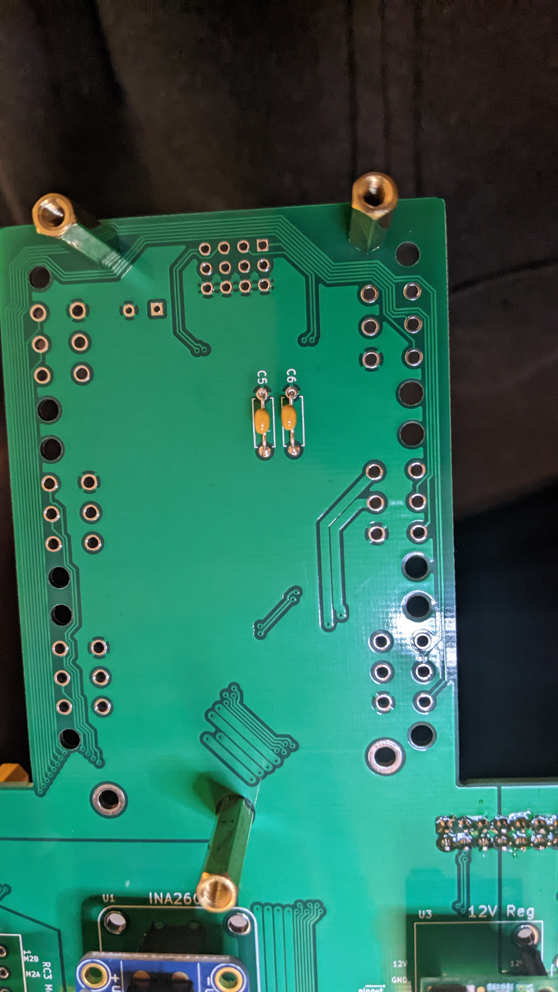
[picture p49: electrical/pcb/images/assembly/PXL_20230426_055549256.MP.jpg]
|  |
|:-:|
| Figure 3.45: Installing capacitors C5, C6|

### 3.20 Install corner servo header J19, and capacitor C19

Make sure to install C19 in the proper direction, as shown in Figure 3.46. One side of the capacitor has negative polarity indicators on it, that should be installed opposite the "+" sign on the footprint.

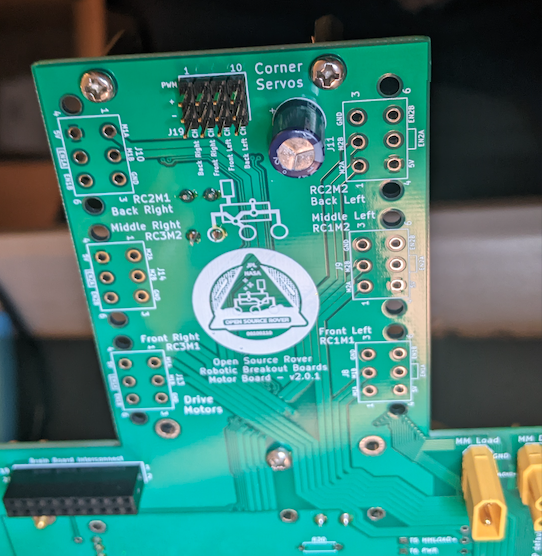
[picture p50: electrical/pcb/images/assembly/j19_c19.png]
|  |
|:-:|
| Figure 3.46: J19 and C19 installed (top of photo) |

### 3.21 Install LED array U5

Make sure to align the slightly "chipped"/beveled corner of the LED array with the beveled corner of the U5 footprint, to have proper LED polarity

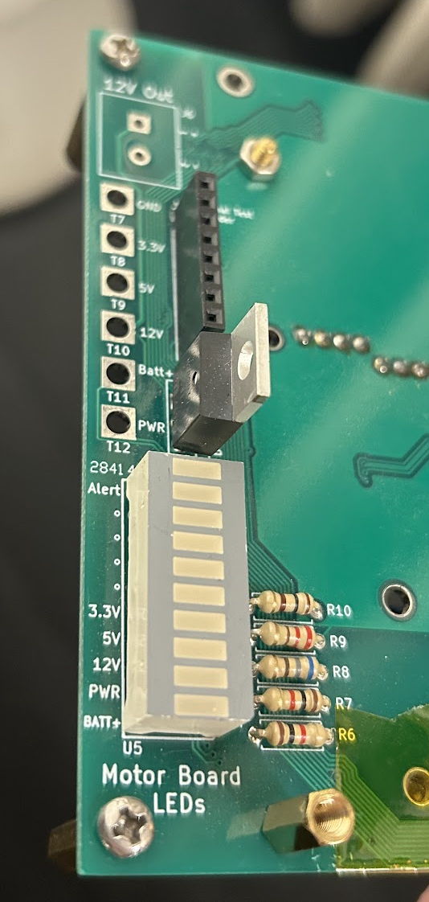
[picture p51: electrical/pcb/images/assembly/u5_installed.png]
|  |
|:-:|
| Figure 3.47: LED array U5 installed |

### 3.22 Install drive motor headers J8,J9,J10,J11,J13,J14

|  |
|:-:|
| Figure 3.48: Drive motor headers installed |

## 4. Brain Board Assembly

|    |
|:-:|
| Figure 4.0: front (left) and back (right) of brain board |

### 4.1 Install resistors

Install 3 sets of resistors:
- R11
- R25,R26,R27,R28,R29 
- R31,R32,R33,R34,R35

|  |
|:-:|
| Figure 4.1: Resistors installed |

### 4.2 Install switch SW1

Make sure to install the switch in the correct direction to match the footprint.

|  |
|:-:|
| Figure 4.2: Switch SW1 installed |

 ### 4.3 Install LED array U6 and various headers on top of board

Install these components:
- U6 LED array
- J22,J23 raspberry pi ribbon cable headers
- J25 3x4 male headers - "i2c breakout"
- J24 1x6 shrouded male header (white color) - "arduino comm"
- J30 8x1 male header - "signal test header"

Make sure to align the slightly "chipped"/beveled corner of the LED array with the beveled corner of the U6 footprint, to have proper LED polarity

Make sure to match the gaps on the sides of the J22 and J23 headers with the gaps indicated in the silk screen for these footprints.

Make sure to install J24 with the gap facing to the right of the top side of the board (as shown in Figure 4.3)

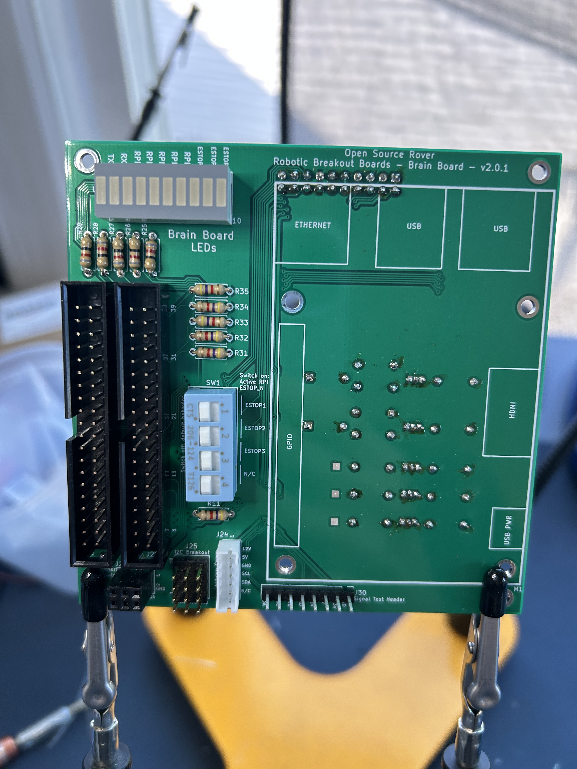
[picture p57: electrical/pcb/images/assembly/IMG_0842.jpeg]
|  |
|:-:|
| Figure 4.3: U6 and other headers installed  |

### 4.4 Install J26 header and capacitor C32 on back of board

Make sure to match the gaps on the side of the J26 header with the gap indicated in the silk screen for the footprint 

Ignore the resistors and Figure 4.4 for the moment

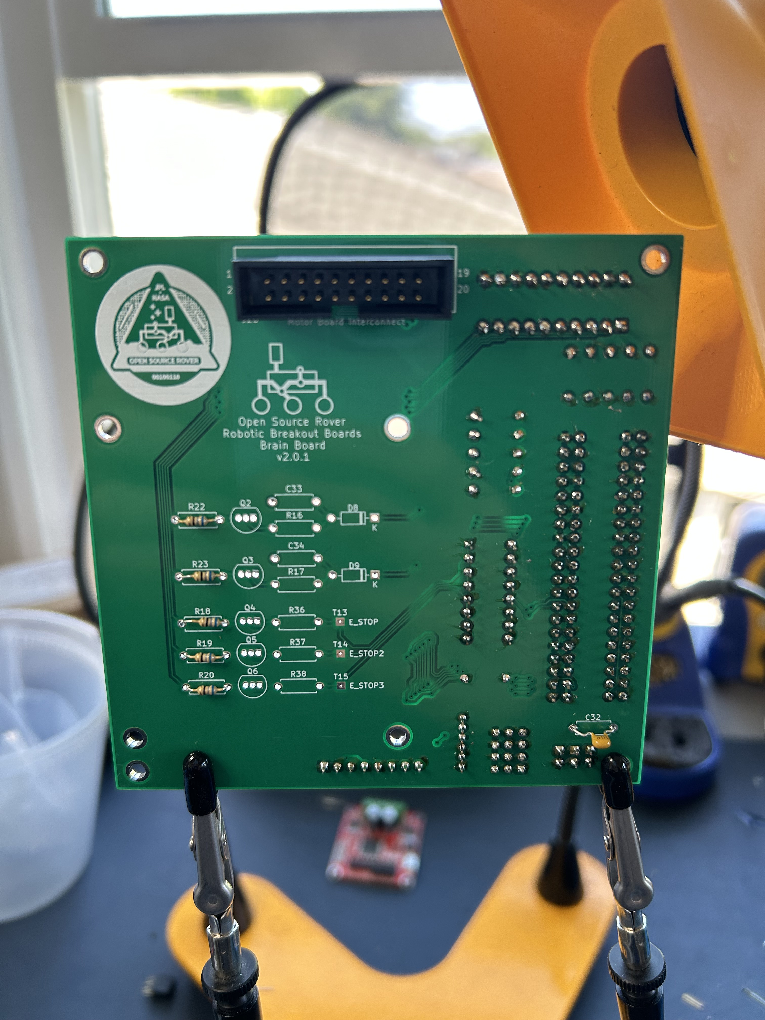
[picture p58: electrical/pcb/images/assembly/IMG_0839.jpeg]
|  |
|:-:|
| Figure 4.4: J26 (top) and C32 installed on back side of board |

Trim the leads of C32 before you continue.

### Install other breakouts on top of board

Finally, install J27,J28,J29 2x1 female headers in front of the leads of C32

### 4.5 Install ESTOP and Serial TXD/RXD LED logic circuit components

Here we install all the components used for the E_STOP, E_STOP2, E_STOP3 logic signals and LED indicators, and also the LED indicators for serial TXD/RXD activity.

Install all of these as indicated in Figure 4.5:
- Q2, Q3, Q4, Q5, Q6 (BJT transistors) (**Polarity Warning!**)
- R18, R19, R20, R22, R23 (68 Ohms ±5% resistors)
- R16, R17, R36, R37, R38 (10k Ohms ±5% resistors)
- C33, C34 (10k pF ±10% 50V Ceramic Capacitors)
- D8, D9 (75V 300mA Diodes) (**Polarity Warning!**)
- Note: T13, T14, T15 should be left empty for probing.

 Note that polarity/installation direction matters for both the BJTs and the diodes (D8,D9). Make sure to match these with the image correctly! (note the black band on one side of the diodes faces to the right in Figure 4.5)

|  |
|:-:|
| Figure 4.5: ESTOP and Serial TXD/RXD LED logic components installed  |

### 4.6 Mount the Raspberry Pi board

Using M2.5 x 20mm standoffs, attach the raspberry pi to the top of the brain board, as shown in figure 4.6.  Attach the ribbon cable from the GPIO on the Pi to J22.

|   |
|:-:|
| Figure 4.6: RPi mounted on the brain board  |

__Important Note if you are using a Raspberry Pi 5:__
The Raspberry Pi (RPi) 5 has different power requirements than previous RPi generations. The two 5v lines attached to the RPi via the ribbon cable are not to enough to adequately power the RPi 5, especially if attaching any peripherals, like a camera. Until further revisions are done to the PCB, it is recommeded to power the RPi 5 through a USB C connector. You can cut a USB C cable and identify the V+ and Ground lines using a digital multimeter, then solder those lines to the 5v and Gnd test connection points on the motorboard. You can then plug the USB C connector into the RPi 5 to power it.  You can also order USB-C cables with PWR/GND broken out already (see [Extra Parts List](../../parts_list/extra_parts.md))

## 5. Motor Board and Brain Board Mating

Using M2.5 x 10mm standoffs, attach the brain board to the top of the motor board, as shown in Figure 4.7

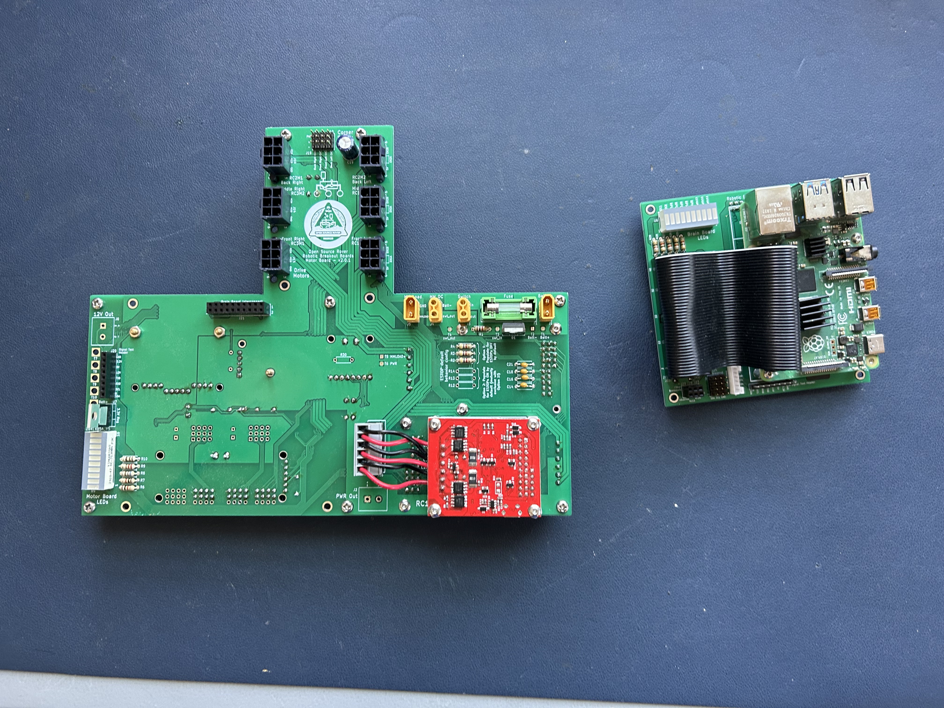
[picture p62: electrical/pcb/images/assembly/IMG_0847.jpeg]
|   |
|:-:|
| Figure 5.0: Mating the brain board to the motor board  |

And now you're done with the assembly! 

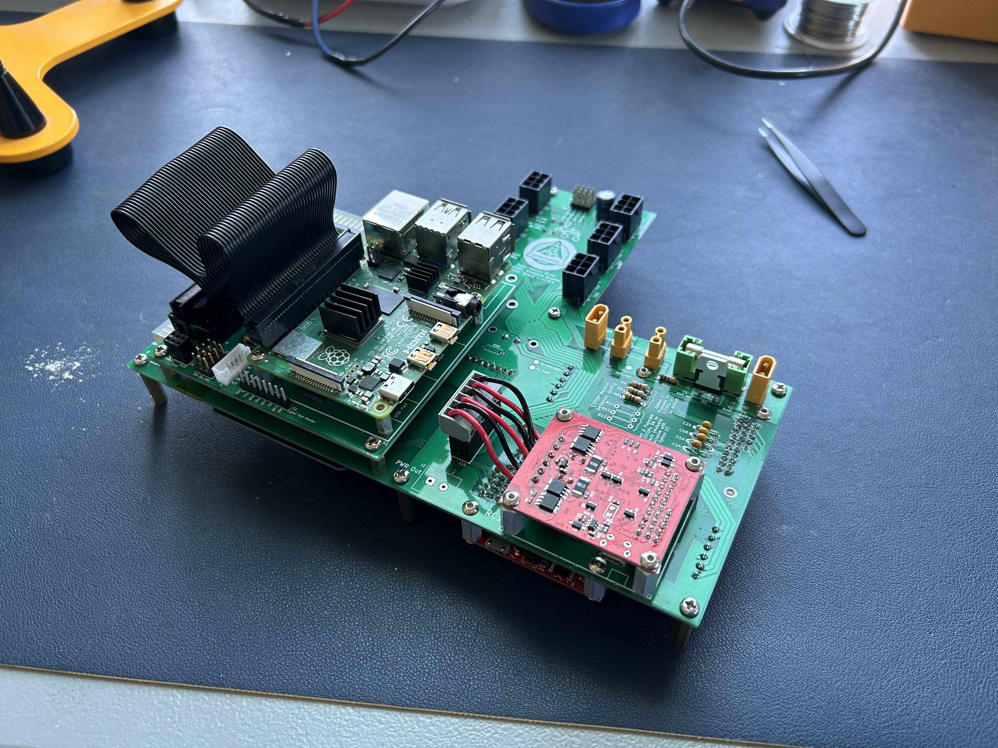
[picture p63: electrical/pcb/images/assembled/complete_pcb_top2.jpg]
|  |
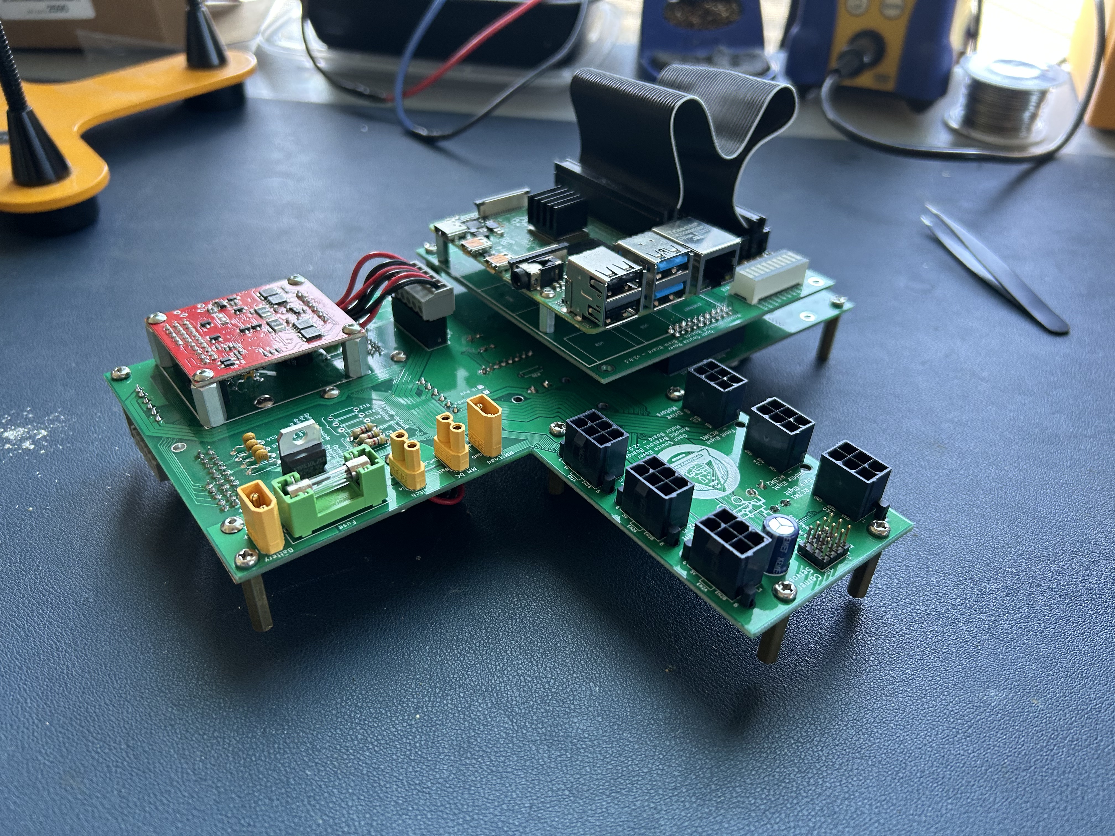
[picture p64: electrical/pcb/images/assembled/complete_pcb_top3.jpeg]
|  |
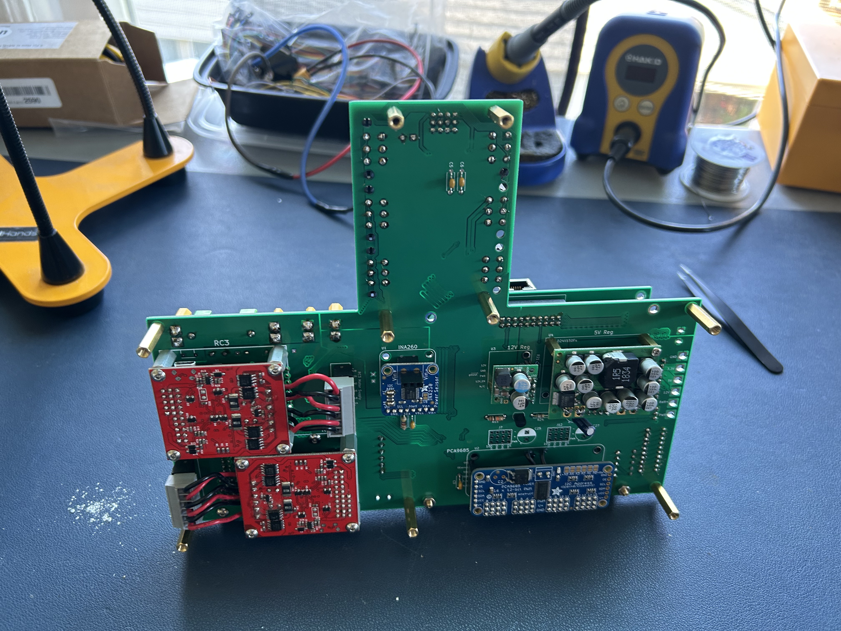
[picture p65: electrical/pcb/images/assembled/complete_pcb_bottom_with_ina260.jpeg]
| |
|:-:|
| Figure 4.8: Completed control board (with INA260) |

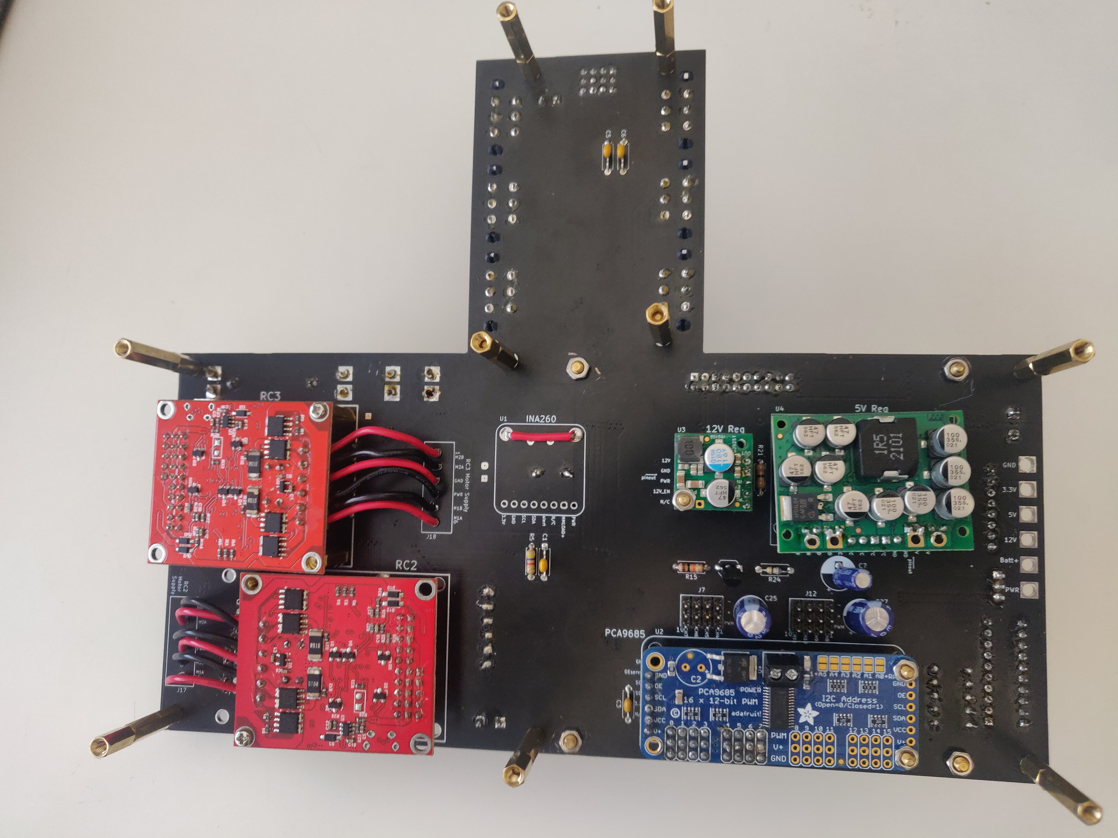
[picture p66: electrical/pcb/images/assembled/complete_pcb_bottom_no_ina260.jpg]
| |
|:-:|
| Figure 4.9: Completed control board (INA260 bypassed) |

Finally, we'll move on to testing and configuration.

## 6. Testing the PCB and wiring for the drive motors

Before we insert the wiring and PCBs into the mechanical assemblies, we'll test and configure the drive motors, wiring, and PCB. This allows us to fix these critical parts if something doesn't look right and allows us to move to running the software as soon as the rover is assembled.

For this you will need:

- wiring you made earlier in [wiring readme](../wiring/README.md)
- 6 drive motors
- completed PCBs
- a power source: a benchtop power supply or a charged battery
- wheel and [bore hub](https://www.gobilda.com/1310-series-hyper-hub-8mm-rex-bore/)

Secure the PCB assembly so it doesn't fall or move while it's on. You can attach it to the bottom body plate already. Avoid contact with any surfaces that can generate high-voltage sparks like carpets as that can destroy the electrical components.

Arrange the drive motors around the PCB and connect them using the wiring. Since we'll be calibrating them, make sure you connect the right motors to the right PCB receptacles. It helps to mark them using a sticky note or marker. The silk screen lettering should help here.

Connect a power source to your board as you did before. Verify that the roboclaws all receive power. A green light should be on on each roboclaw.

### 6.1 RoboClaw Testing and Verification

In this section you will be going one by one and and testing the operation of the RoboClaw Motor controllers. You will be doing this by using the GUI provided by the manufacturer of the motor controllers. The GUI can be found at [the BasicMicro website](https://www.basicmicro.com/downloads), under general downloads, then BasicMicro Motion Studio.

You'll also need the `USB RoboClaw Windows Driver` from the RoboClaw General Downloads section of the page. This should be installed before you run the Motion Studio.

To use the GUI, insert a USB to Micro USB cable from your computer to the motor controller you are going to be testing. In the Basic Motion GUI you should see an available device appear. It might require an update to proceed. Install the latest firmware update and then connect to the device.

Verify that all status lights are green and that the following values are shown at the top:

Temperature1: ~30
M1/M2 Amps: 0.00
M1/M2 Encoder: 0
M1/M2 Speed: 0
Main Battery: Between 11.5-16.7V
Logic Battery: 5V
Model: 2x7a

#### 6.2 Configuring general settings

The addresses for each Roboclaw unit by default are `128` which we want to change such that the Raspberry Pi can distinguish between Roboclaws and thus motors. We'll leave Roboclaw 1 at 128 and set Roboclaw 2 and 3 to 129 and 130 respectively.

In the `General Settings` tab:

- under `Setup`, set `Control Mode` to `Packet Serial`
- Enable the `Multi-Unit` mode flag
- Under `Serial`, set the `Packet Serial Address` to either 128, 129, or 130 depending on which roboclaw is plugged in
- set the `Baudrate` to `115200`
- Under `I/O`, make sure `Encoder 1 Mode` and `Encoder 2 Mode` are both set to `Quadrature`
- Under `Battery`, set `Max Main Battery` to `18.5V` and `Min Main Battery` to `11.5V`

Next, we'll check the correct direction and calibrate velocity before we repeat the process for the other roboclaws and motors.

#### 6.3 Prepare PWM signal

Click on the PWM tab. We will now send a PWM signal to the motor and test that connections are all made correctly to the motor and encoder. Start by selecting the `Enable Space Bar Stop All` button in the bottom left which allows you to set velocity to zero when you hit the space bar.

#### 6.4 Vary PWM signal

Slowly move the slider bar for the corresponding motor output channel. Verify that the right motor is spinning and that the encoder value is also changing.

- If there is no movement, the motors aren't getting current through the MA and MB wires. Check your wiring and look for red status lights within the Motion Studio GUI to troubleshoot.
- If the motor spins but the encoder value for that same motor/channel (M1 or M2) isn't changing, there likely is an issue with your encoder cabling. Use a multi-meter to verify connectivity.
- If all your connections are correct, you may have to test your solder contact between the components on the board itself.

> **Note**: When troubleshooting electrical connections, always remove power to the PCB to prevent shorting and injury.
Switch direction of the slide bar and verify that it spins the other direction and the encoder value does the opposite of previous as well.

Once you've verified this, we'll focus on the direction. We want the motor to spin as in the diagram below when we send a positive PWM:

motor direction diagram

For both motors check that the direction matches the diagram. If it doesn't, for that motor in the `General Settings` tab, select `M1 Reverse`. Check again to verify it matches. Now verify that the encoder value increases when you send a positive PWM for each motor. If it doesn't, select the `invert` checkbox in `General Settings` and verify again.

#### 6.5 Calibrate Velocity Settings

Click on the Velocity Settings tab. Here we will tune the velocity settings of the motor; these can only be done after setting the PWM direction in the previous step so ensure that those are done first. Furthermore, to get a precise calibration the wheels should be attached to the motors as they add some inertia to the system. Reference the [wheel assembly](../../mechanical/wheel_assembly/) instructions to see how to attach the wheels to the motor.

While the individual parameters can be tuned to precise values, for an initial/minimum setup we can use the Autotune feature. To do this first make sure your motor and wheel can freely spin (i.e. elevated off the ground and not in contact with anything). Then, select `Tune M1` under `Autotune`. The motor will rock back and forth several times slowly and quickly. Once the motor stops, the tuning is complete. Do the same for the second motor by selecting `Tune M2`. The velocity calibration is now complete.

The individual PID values can also be tuned manually after autotuning to tweak the motor performance. Roboclaw has an overview of all of the [velocity settings here](https://resources.basicmicro.com/velocity-settings-in-motion-studio/).

> **Important**: Make sure to save these settings to each Roboclaw's non-volatile memory by clicking on the `Device` menu > `Write Settings`.
Repeat starting from Section [6.1](#61-roboclaw-testing-and-verification) for the other two roboclaws.
