NickelsLab/open-source-rover/electrical/pcb/control_board/documentation/3d_images/brain_bottom_iso.png

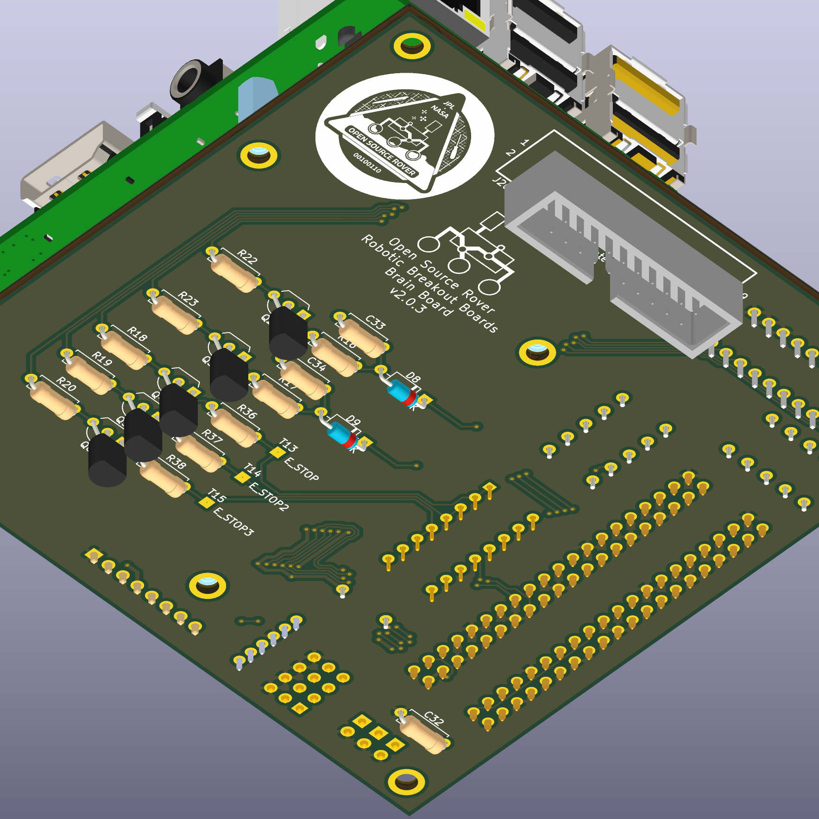
electrical/pcb/control_board/documentation/3d_images/brain_bottom_iso.png
