NickelsLab/open-source-rover/electrical/pcb/control_board/documentation/3d_images/brain_top.png

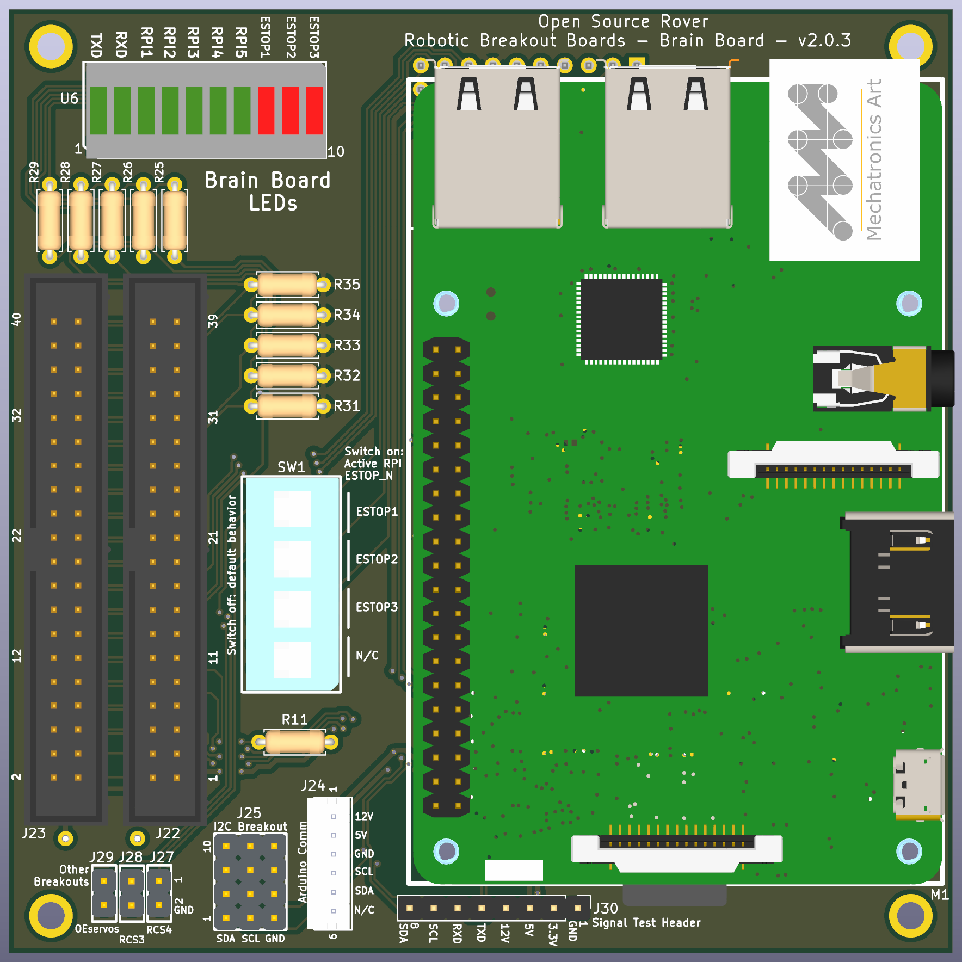
electrical/pcb/control_board/documentation/3d_images/brain_top.png
