NickelsLab/open-source-rover/electrical/pcb/control_board/documentation/3d_images/brain_top_iso.png

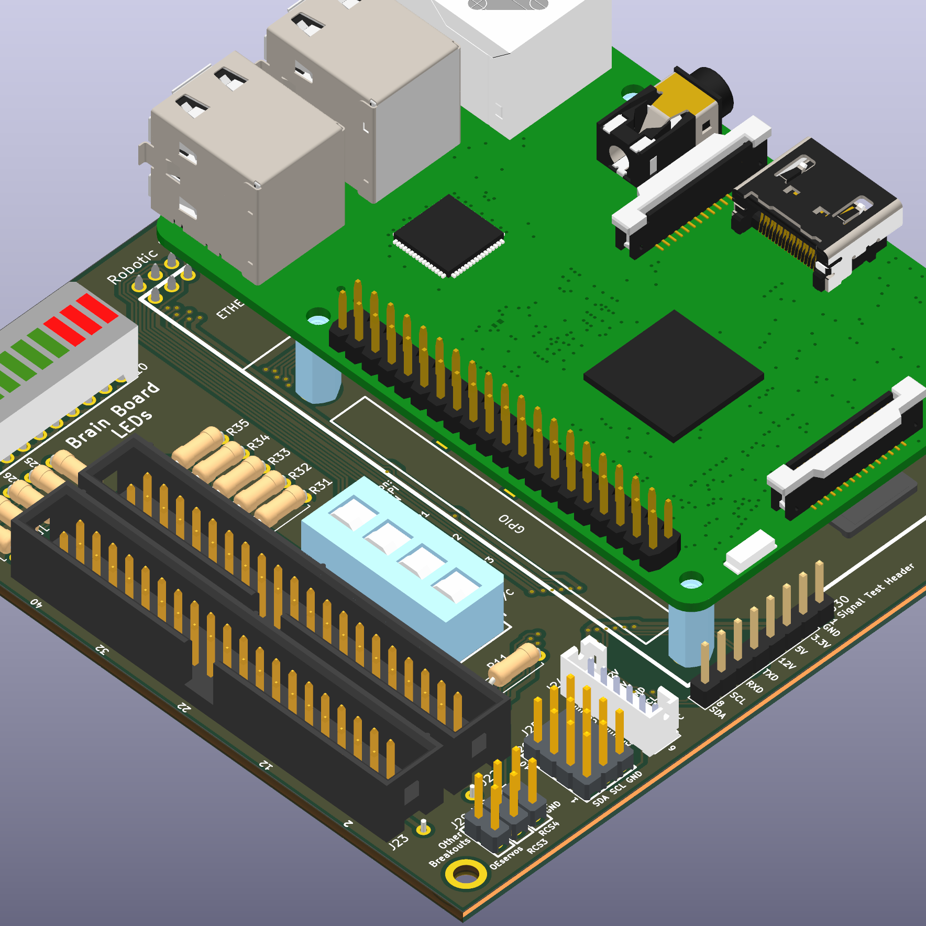
electrical/pcb/control_board/documentation/3d_images/brain_top_iso.png
