NickelsLab/open-source-rover/electrical/pcb/control_board/documentation/3d_images/motor_bottom.png

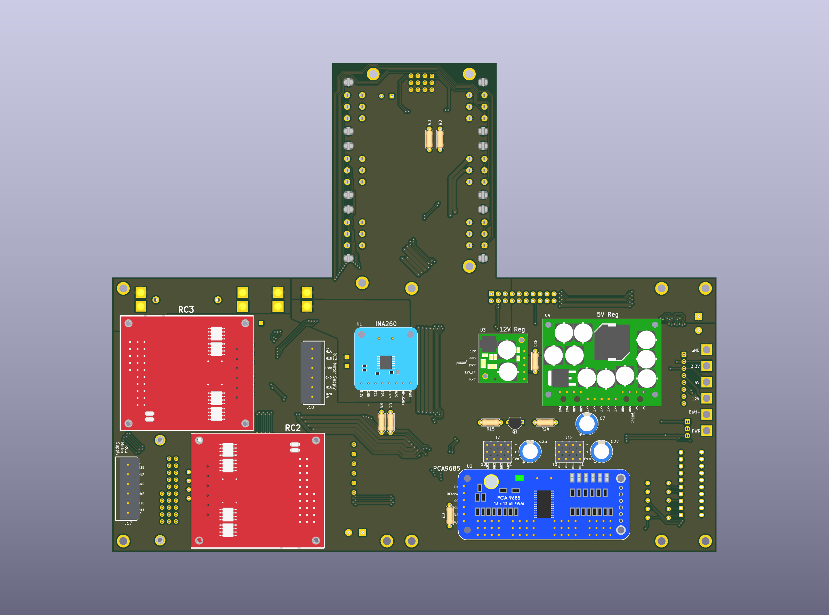
electrical/pcb/control_board/documentation/3d_images/motor_bottom.png
