NickelsLab/open-source-rover/electrical/pcb/control_board/BOM/bom_v2.0.3_other_parts.csv

UID | Name | Quantity | Number to Order | Value | Digi-Key Part | URL | Availability | Notes
B1 | Fuse | 1 | 2 | Medium Blow Fuse | F3631-ND | https://www.digikey.com/en/products/detail/littelfuse-inc/0233010-MXP/2024797
B2 | roboclaw terminal block connector | 3 | 3 | WM13033-ND | WM13033-ND | https://www.digikey.com/en/products/detail/molex/0395005006/2735121 |  | Alternates: - https://www.arrow.com/en/products/5434586/phoenix-contact?q=5434586 - https://www.digikey.com/en/products/detail/phoenix-contact/5434586/4389762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
B3 | power connectors | 4 | 1 pack (same as J1,J5,J3,J4) | xt30 connectors |  | https://www.amazon.com/gp/product/B0875MBLNH/ref=ppx_yo_dt_b_search_asin_title?ie=UTF8&psc=1
B4 | drive motor connectors | 6 | 1 pack | Molex 6 pin connector with cables prepopulated | WM16239-ND | https://www.amazon.com/Amangny-Extension-Power-Express-Adapter/dp/B09NBRQ9CC |  | just cut the wires and use the 6 pin connector side
B5 | rpi ribbon cable | 1 | 2 |  |  | https://www.adafruit.com/product/1988
B6 | solder seal wire connectors kit | 1 | 1 |  |  | https://www.amazon.com/Connectors-Connector-Waterproof-Insulated-Electrical/dp/B0BP812YSK
B7 | rpi 4B | 1 | 1 |  |  | https://www.raspberrypi.com/products/raspberry-pi-4-model-b/
B8 | assorted header kit | 1 | 1 |  |  | https://www.amazon.com/Glarks-1191Pcs-Housing-Connector-Compatible/dp/B07TB8QXMC |  | For 5V&12v regs, roboclaws, ina260
B9 | external switch | 1 | 1 |  | 708-3060-ND | https://www.digikey.com/en/products/detail/bulgin/C3920BAAAA/9598416 |  | Old version: https://www.digikey.com/product-detail/en/bulgin/C3900BA/1091-1026-ND/2747857
B10 | DC Multimeter |  |  |  |  | https://www.amazon.com/gp/product/B017FSED9I/
B11 | pca9685 and ina260 power pins header | 1 | 1 | 5mm pitch terminal block header | ED1682-24-ND | https://www.digikey.com/en/products/detail/on-shore-technology-inc./EDSTL130%2F24/133461 |  | Will need to break this in pieces to use for pca9685 and ina260
B12 | board standoffs kit - metric | 1 | 1 |  |  | https://www.amazon.com/HELIFOUNER-Spacers-Standoffs-Assortment-Tweezers/dp/B0B25BKNKK
B13 | 20 AWG wire
B14 | 16 AWG wire
