NickelsLab/open-source-rover/electrical/pcb/control_board/BOM/digikey_upload_bom.png

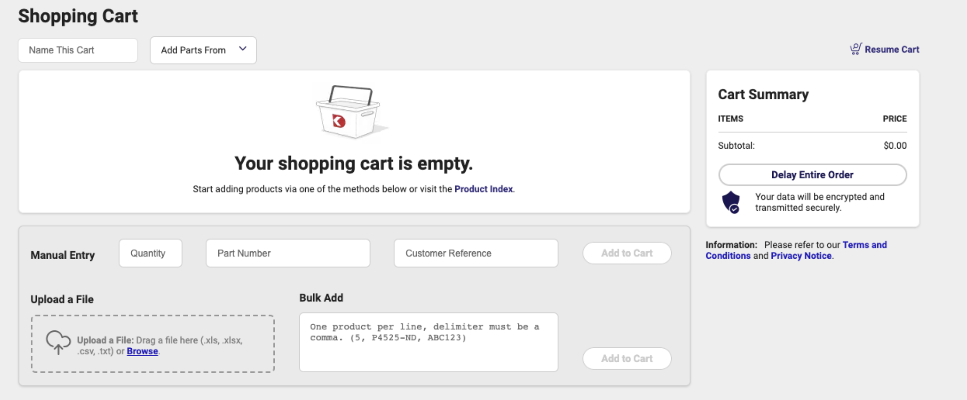
electrical/pcb/control_board/BOM/digikey_upload_bom.png
