NickelsLab/open-source-rover/electrical/pcb/control_board/3d_models/roboclaw_2x7a_headers_standoffs.step

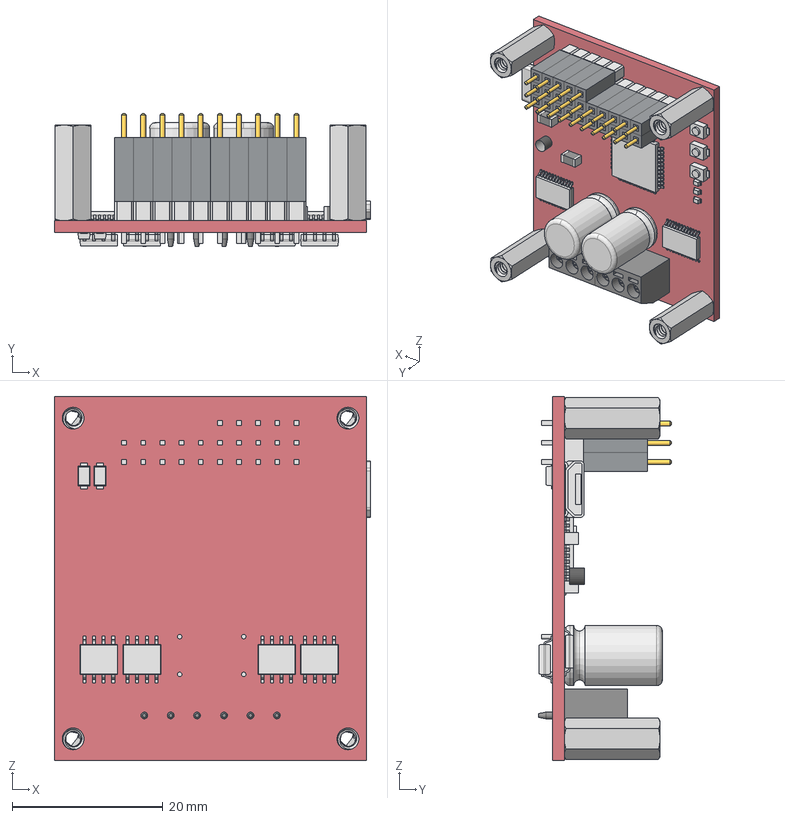
[picture p76: CAD file, 2026-08-26]
electrical/pcb/control_board/3d_models/roboclaw_2x7a_headers_standoffs.step
42.0 x 17.7 x 48.3 mm
MC5A-PCB
P15369TB-ND_1
620-1319-1-ND
587-3248-1-ND_1
91780A533_Female Threaded Hex Standoff x 4
DB2W40200LCT-ND_1
SW1020CT-ND
ATXMEGA32A4U-AU-ND
SRN5040-220MCT-ND
609-4618-1-ND
ED2636-ND_1
IRF7351TRPBFCT-ND
IRF7351TRPBFCT-ND_3
404-1004-1-ND_2
587-3248-1-ND
PBC05SAAN
IRF7351TRPBFCT-ND_1
PBC10DAAN
DB2W40200LCT-ND
404-1004-1-ND
620-1319-1-ND_1
404-1004-1-ND_1
ED2636-ND
SW1020CT-ND_1
IRF7351TRPBFCT-ND_2
SW1020CT-ND_2
P15369TB-ND
