NickelsLab/open-source-rover/electrical/pcb/control_board/documentation/schematics.pdf

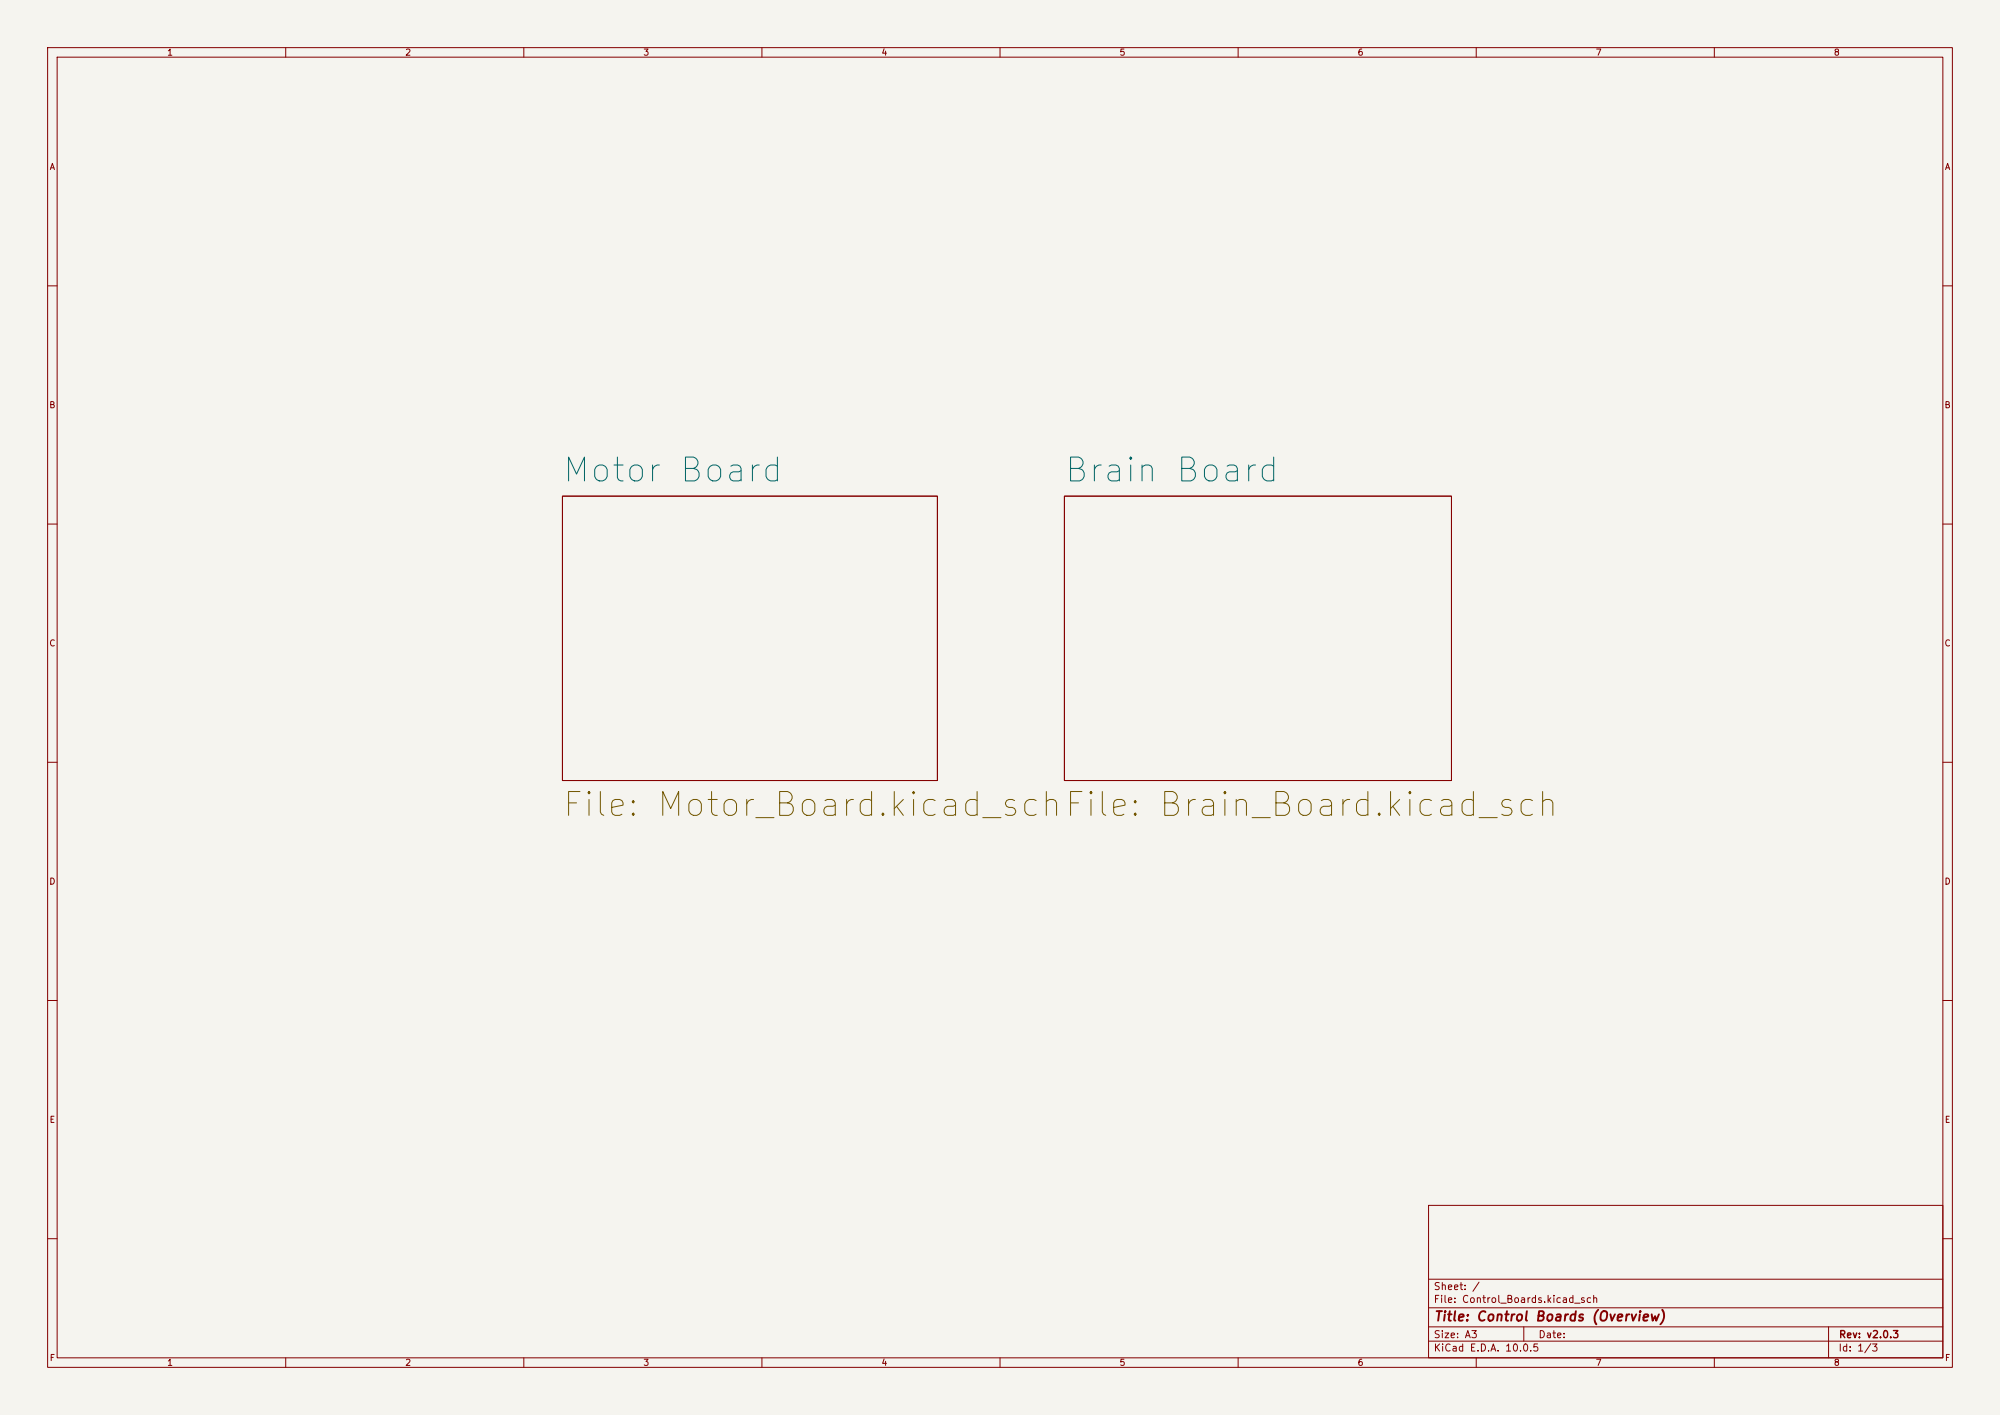
[picture p77: page 1]

Sheet: /
File: Control_Boards.kicad_sch
Title: Control Boards (Overview)

Size: A3 | Rev: v2.0.3 | F Date:
KiCad E.D.A. 10.0.5 | Id: 1/3

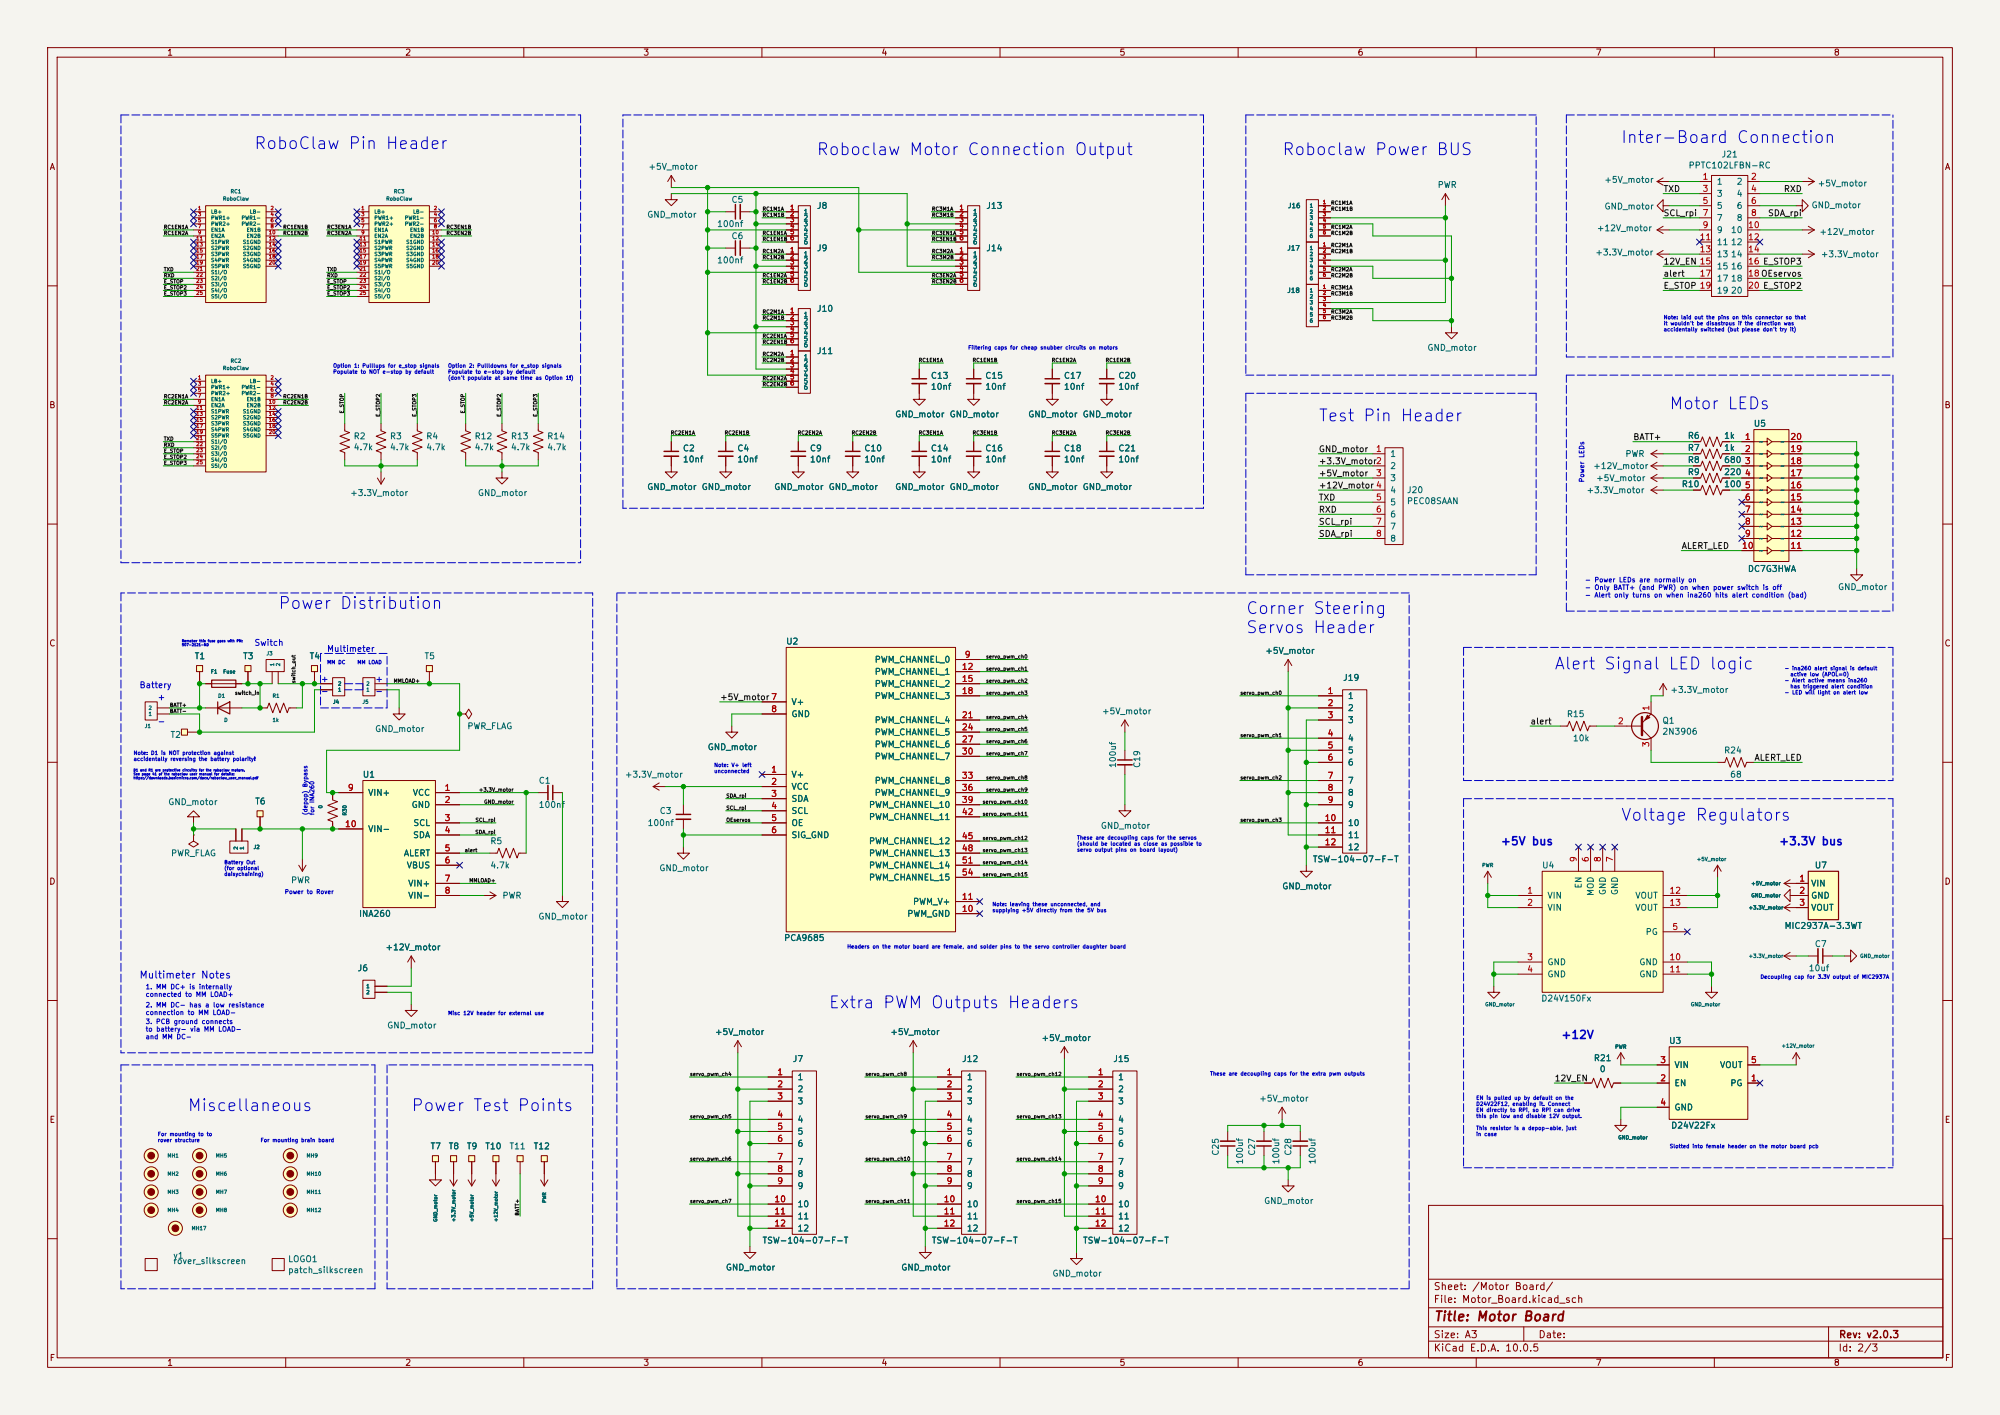
[picture p78: page 2]

Filtering caps for cheap snubber circuits on motors Roboclaw Motor Connection Output
10nf GND_motor

Note: laid out the pins on this connector so that

it wouldn’t be disastrous if the direction was accidentally switched (but please don’t try it) Multimeter MM DC

- Power LEDs are normally on - Only BATT+ (and PWR) on when power switch is off - Alert only turns on when ina260 hits alert condition (bad)

Alert Signal LED logic

D1 and R1 are protective circuitry for the roboclaw motors. See page 41 of the roboclaw user manual for details: https://downloads.basicmicro.com/docs/roboclaw_user_manual.pdf Battery
BATT+
alert BATT-

- ina260 alert signal is default active low (APOL=0) - Alert active means ina260 has triggered alert condition - LED will light on alert low

TSW-104-07-F-T 1 5 5

These are decoupling caps for the servos

(should be located as close as possible to servo output pins on board layout) Miscellaneous

(for optional daisychaining) Multimeter Notes

2. MM DC- has a low resistance connection to MM LOAD-

Misc 12V header for external use Power Test Points

to battery- via MM LOAD-

These are decoupling caps for the extra pwm outputs

EN is pulled up by default on the D24V22F12, enabling it. Connect EN directly to RPi, so RPi can drive

this pin low and disable 12V output.

For mounting to to
rover structure

This resistor is a depop-able, just

For mounting brain board

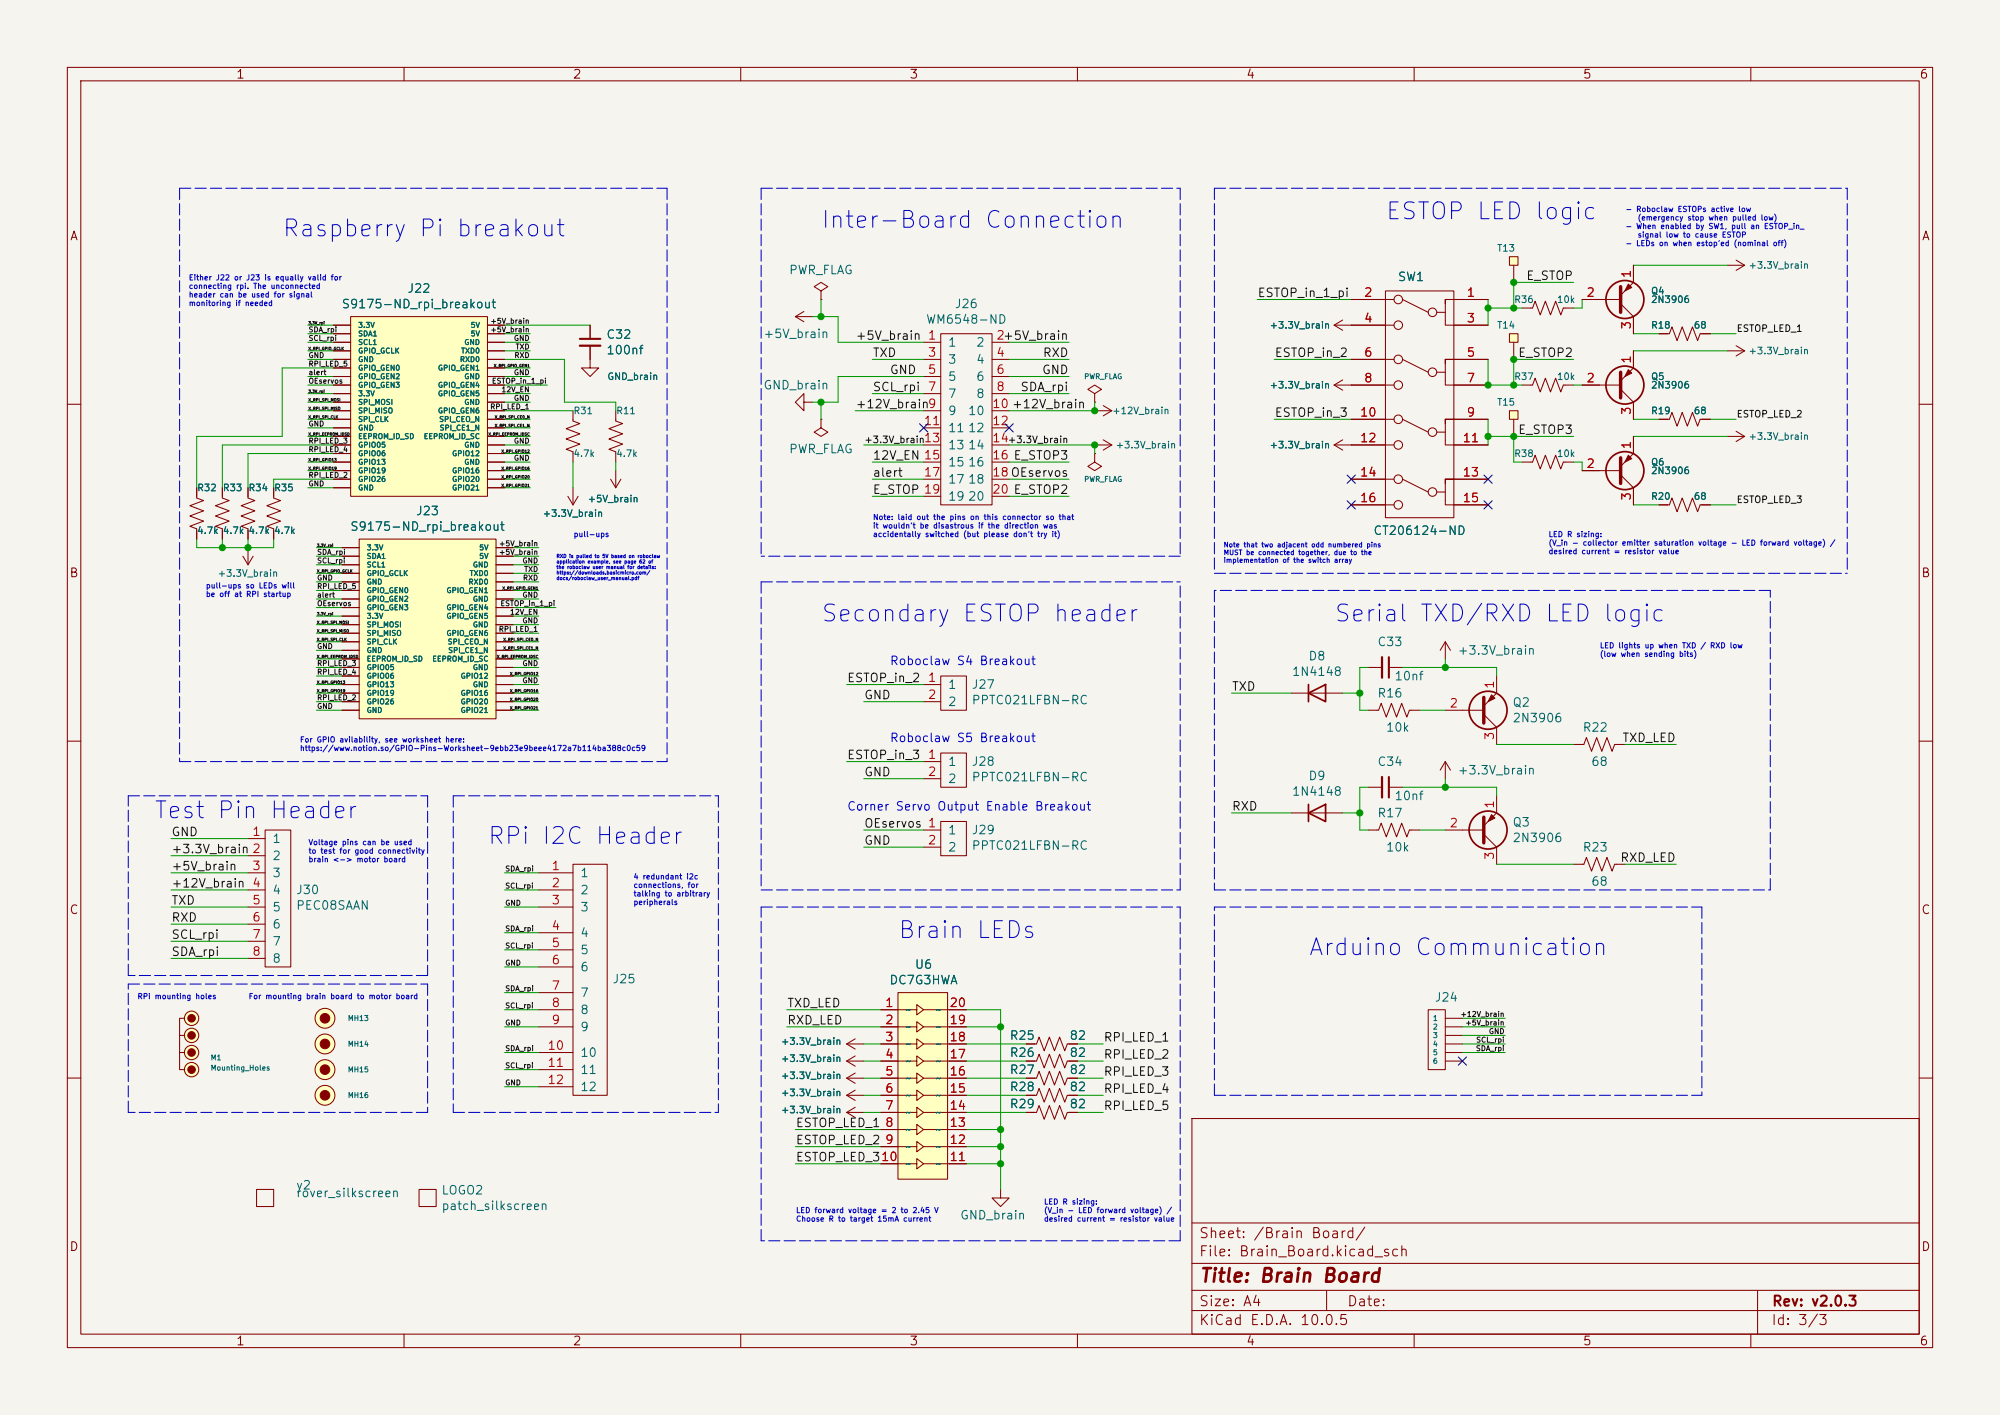
[picture p79: page 3]

(V_in - collector emitter saturation voltage - LED forward voltage) / desired current = resistor value - Roboclaw ESTOPs active low
(emergency stop when pulled low) - When enabled by SW1, pull an ESTOP_in_ signal low to cause ESTOP - LEDs on when estop’ed (nominal off) LED lights up when TXD / RXD low

Roboclaw S4 Breakout Roboclaw S5 Breakout Corner Servo Output Enable Breakout Note: laid out the pins on this connector so that

implementation of the switch array For mounting brain board to motor board Test Pin Header

RXD is pulled to 5V based on roboclaw application example, see page 62 of
the roboclaw user manual for details: https://downloads.basicmicro.com/

docs/roboclaw_user_manual.pdf RPi mounting holes

(low when sending bits) Serial TXD/RXD LED logic

For GPIO avilability, see worksheet here: https://www.notion.so/GPIO-Pins-Worksheet-9ebb23e9beee4172a7b114ba388c0c59

Voltage pins can be used
to test for good connectivity brain <-> motor board
J30 PEC08SAAN

(V_in - LED forward voltage) / desired current = resistor value 4 redundant i2c connections, for

talking to arbitrary peripherals
