NickelsLab/open-source-rover/electrical/pcb/control_board/Control_Boards.kicad_pcb

## KiCad design electrical/pcb/control_board/Control_Boards.kicad_pcb (2026-08-27)

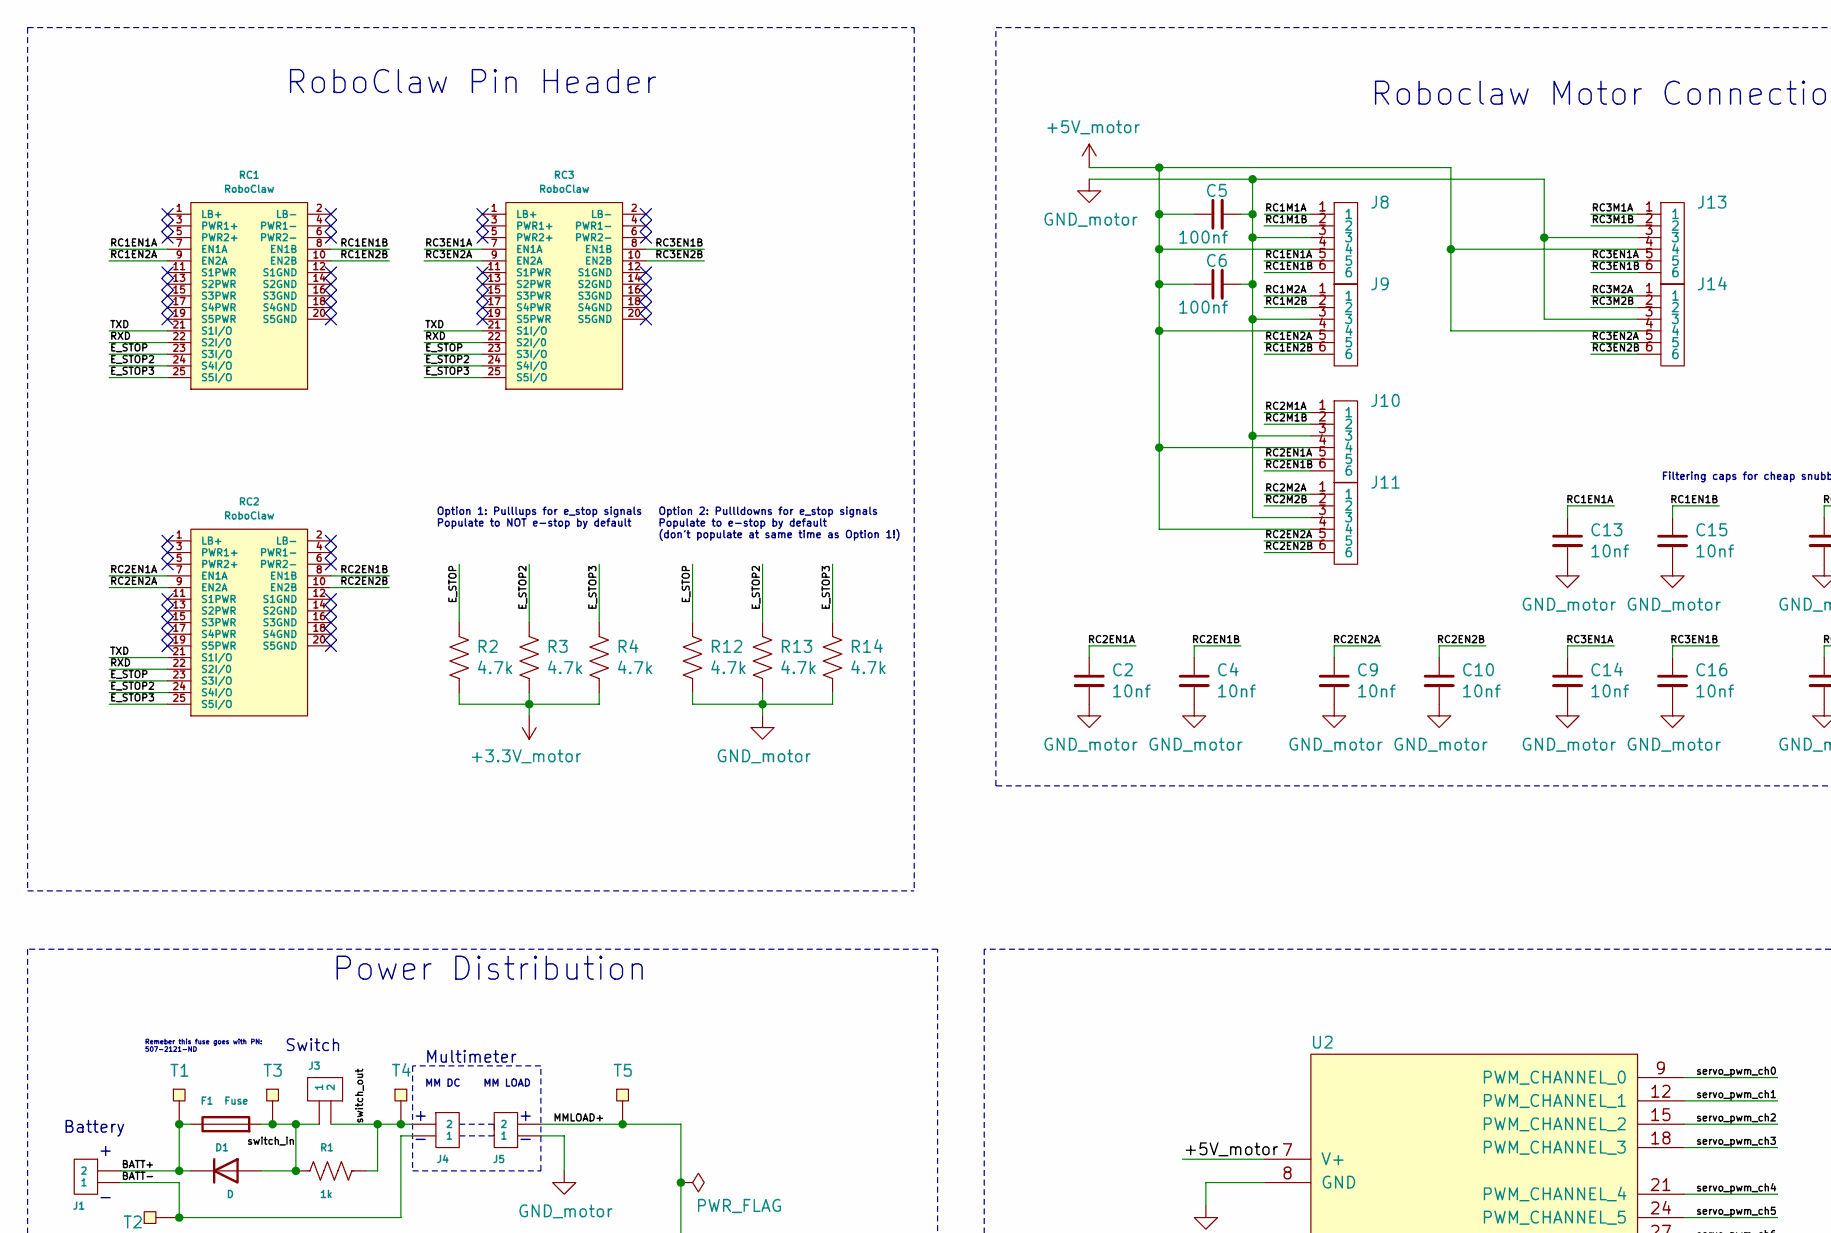
[picture p80: schematic Motor_Board.kicad_sch, Motor Board, part in row 1, column 1]

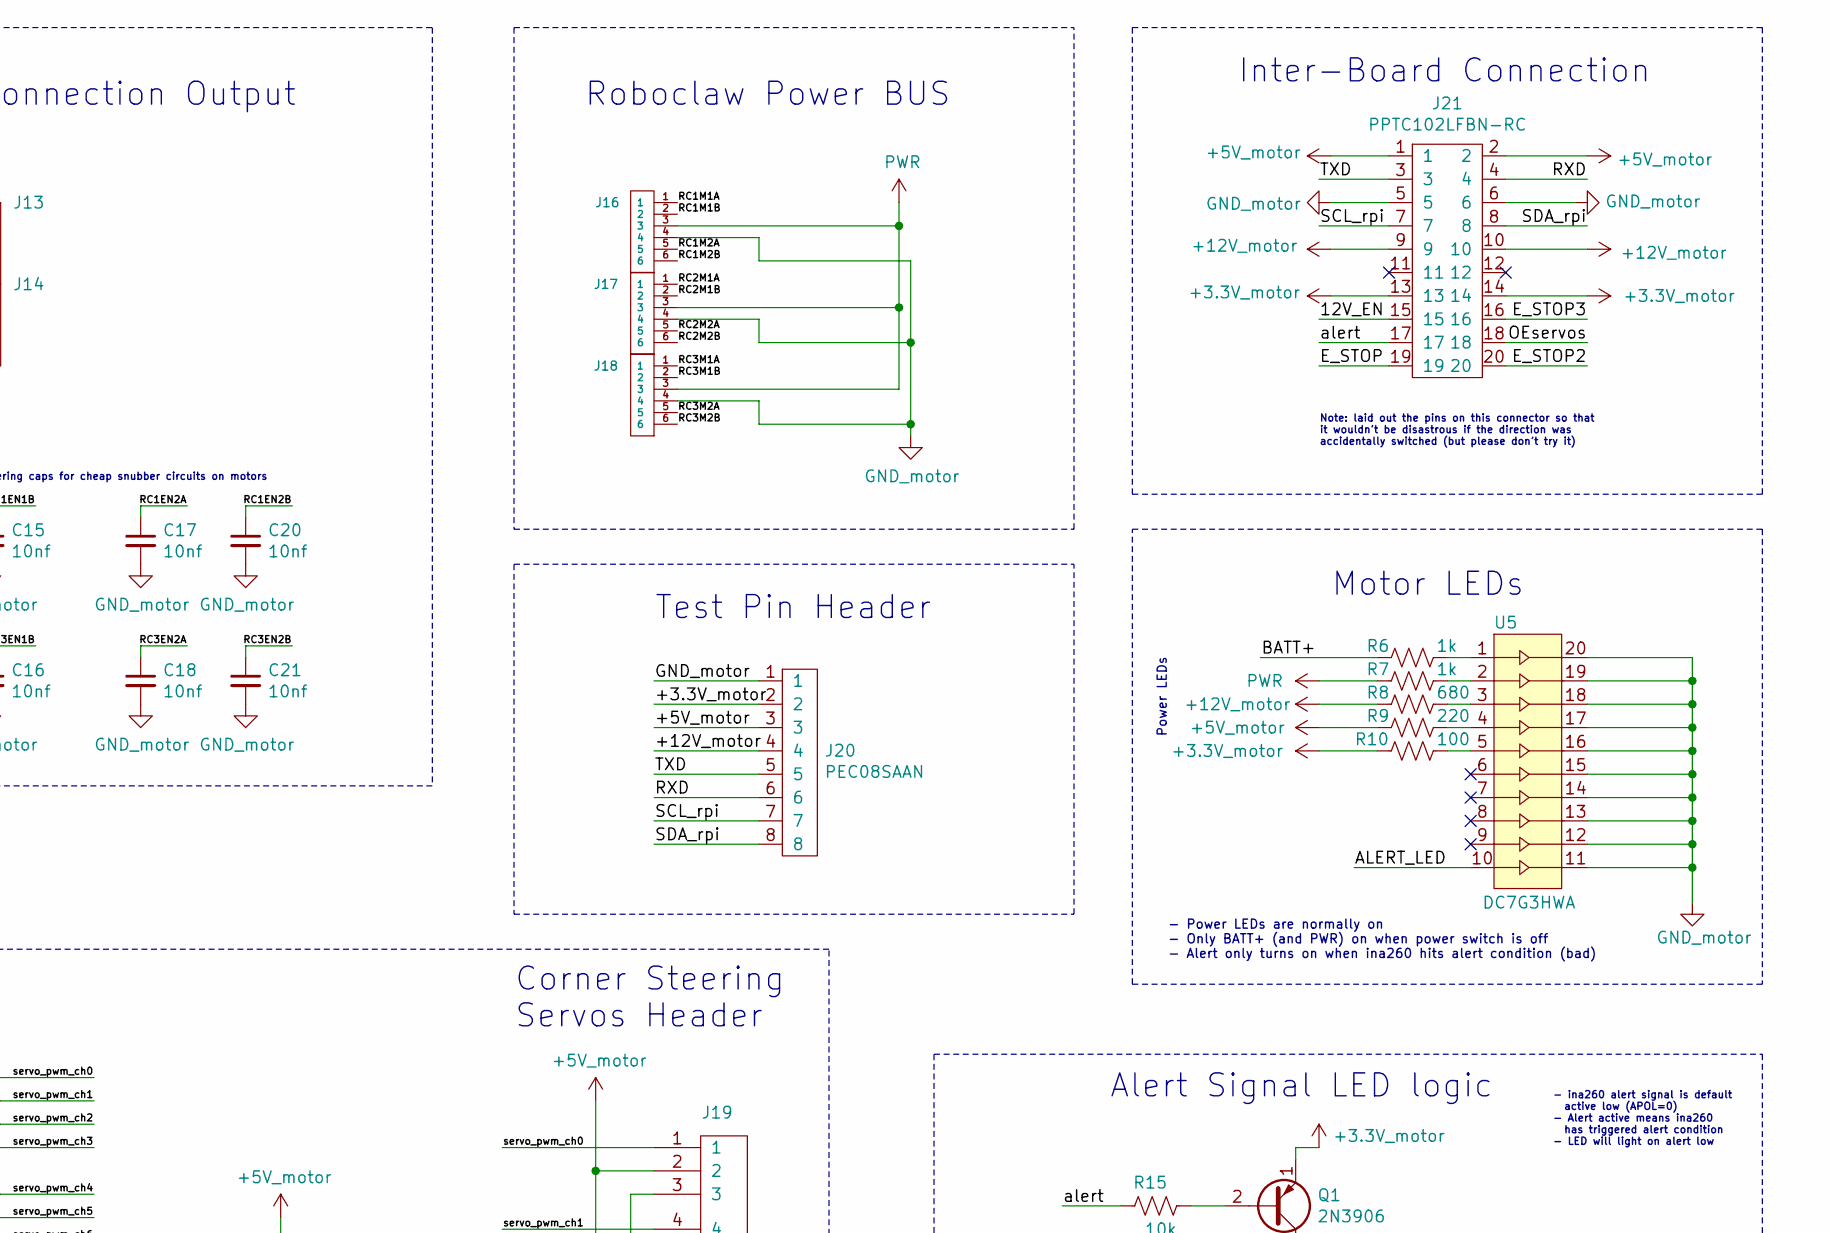
[picture p81: schematic Motor_Board.kicad_sch, Motor Board, part in row 1, column 2]

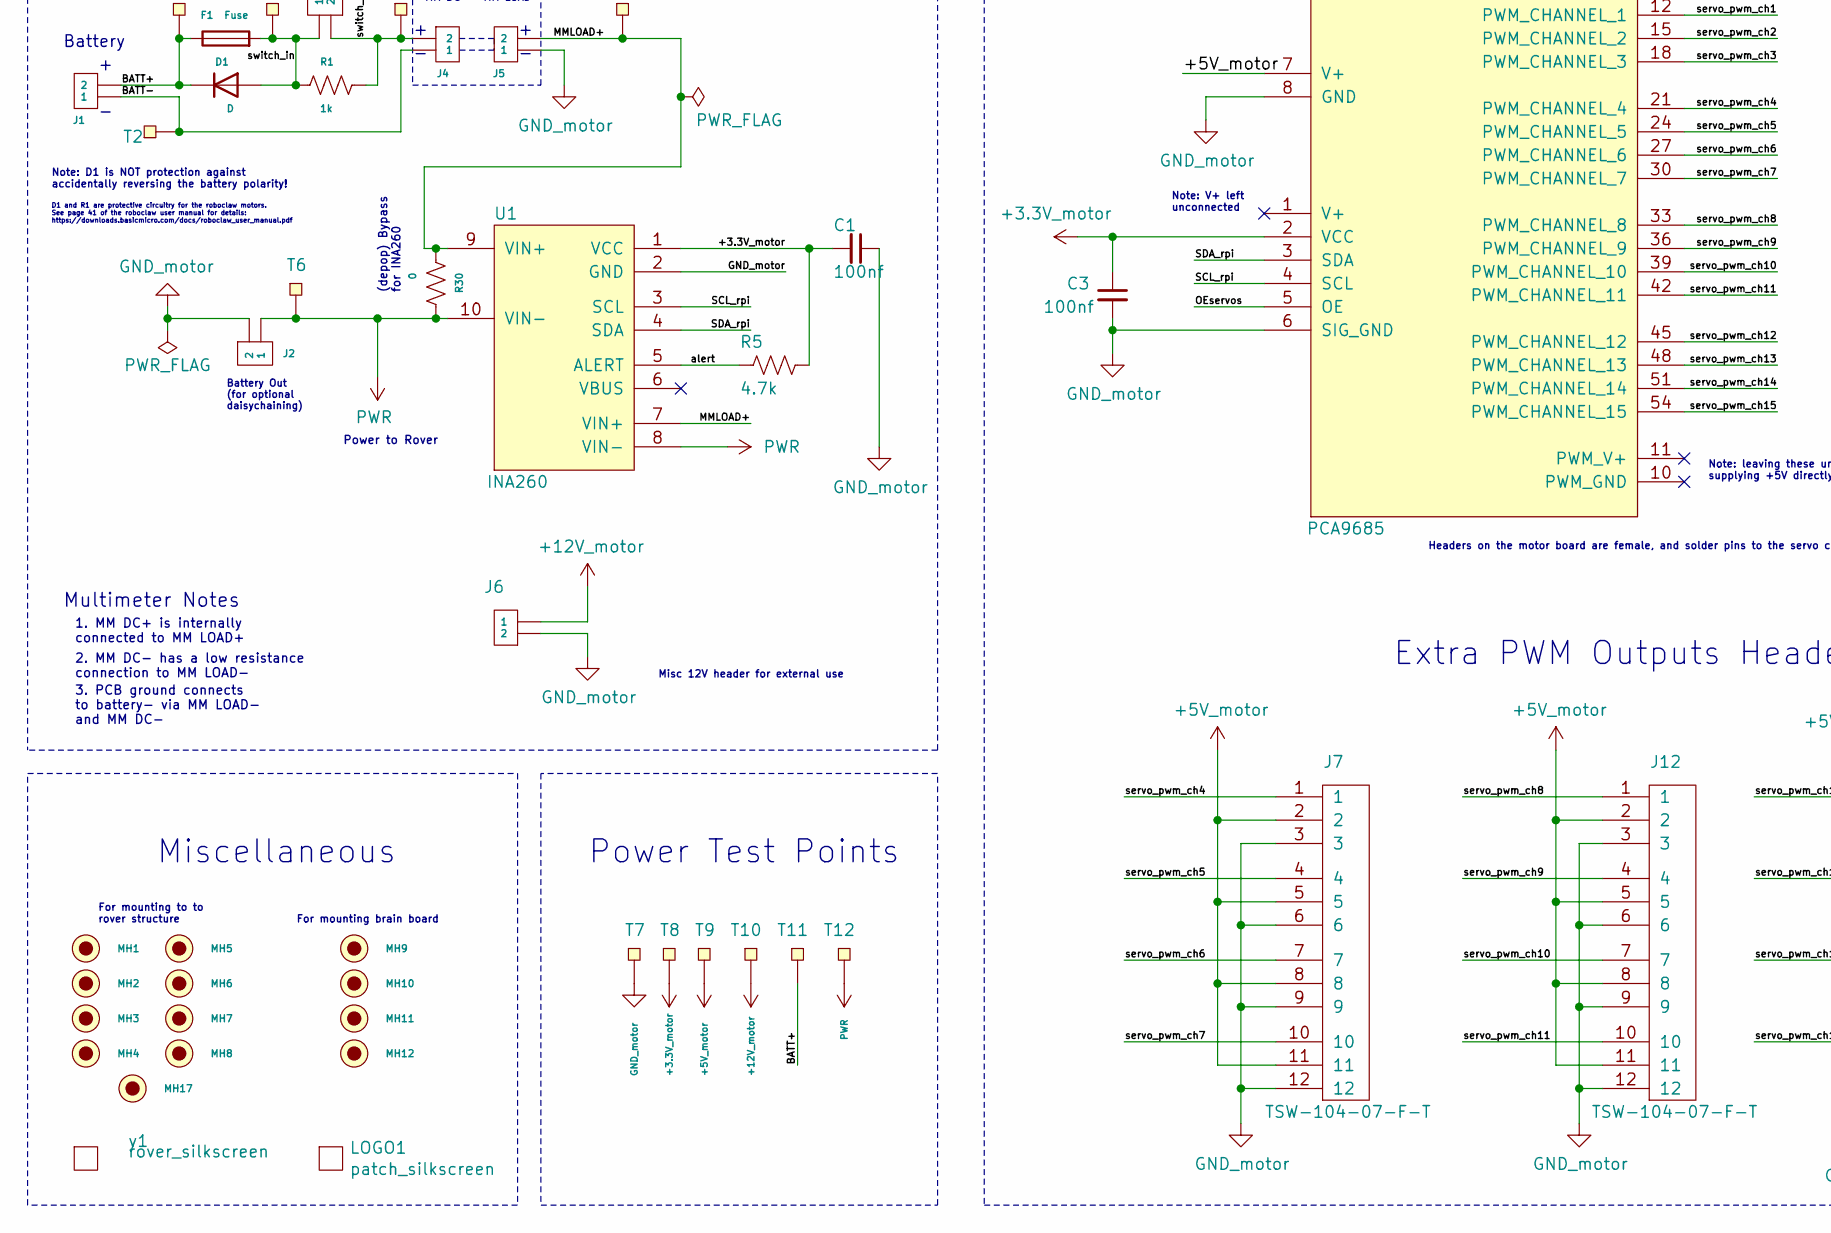
[picture p82: schematic Motor_Board.kicad_sch, Motor Board, part in row 2, column 1]

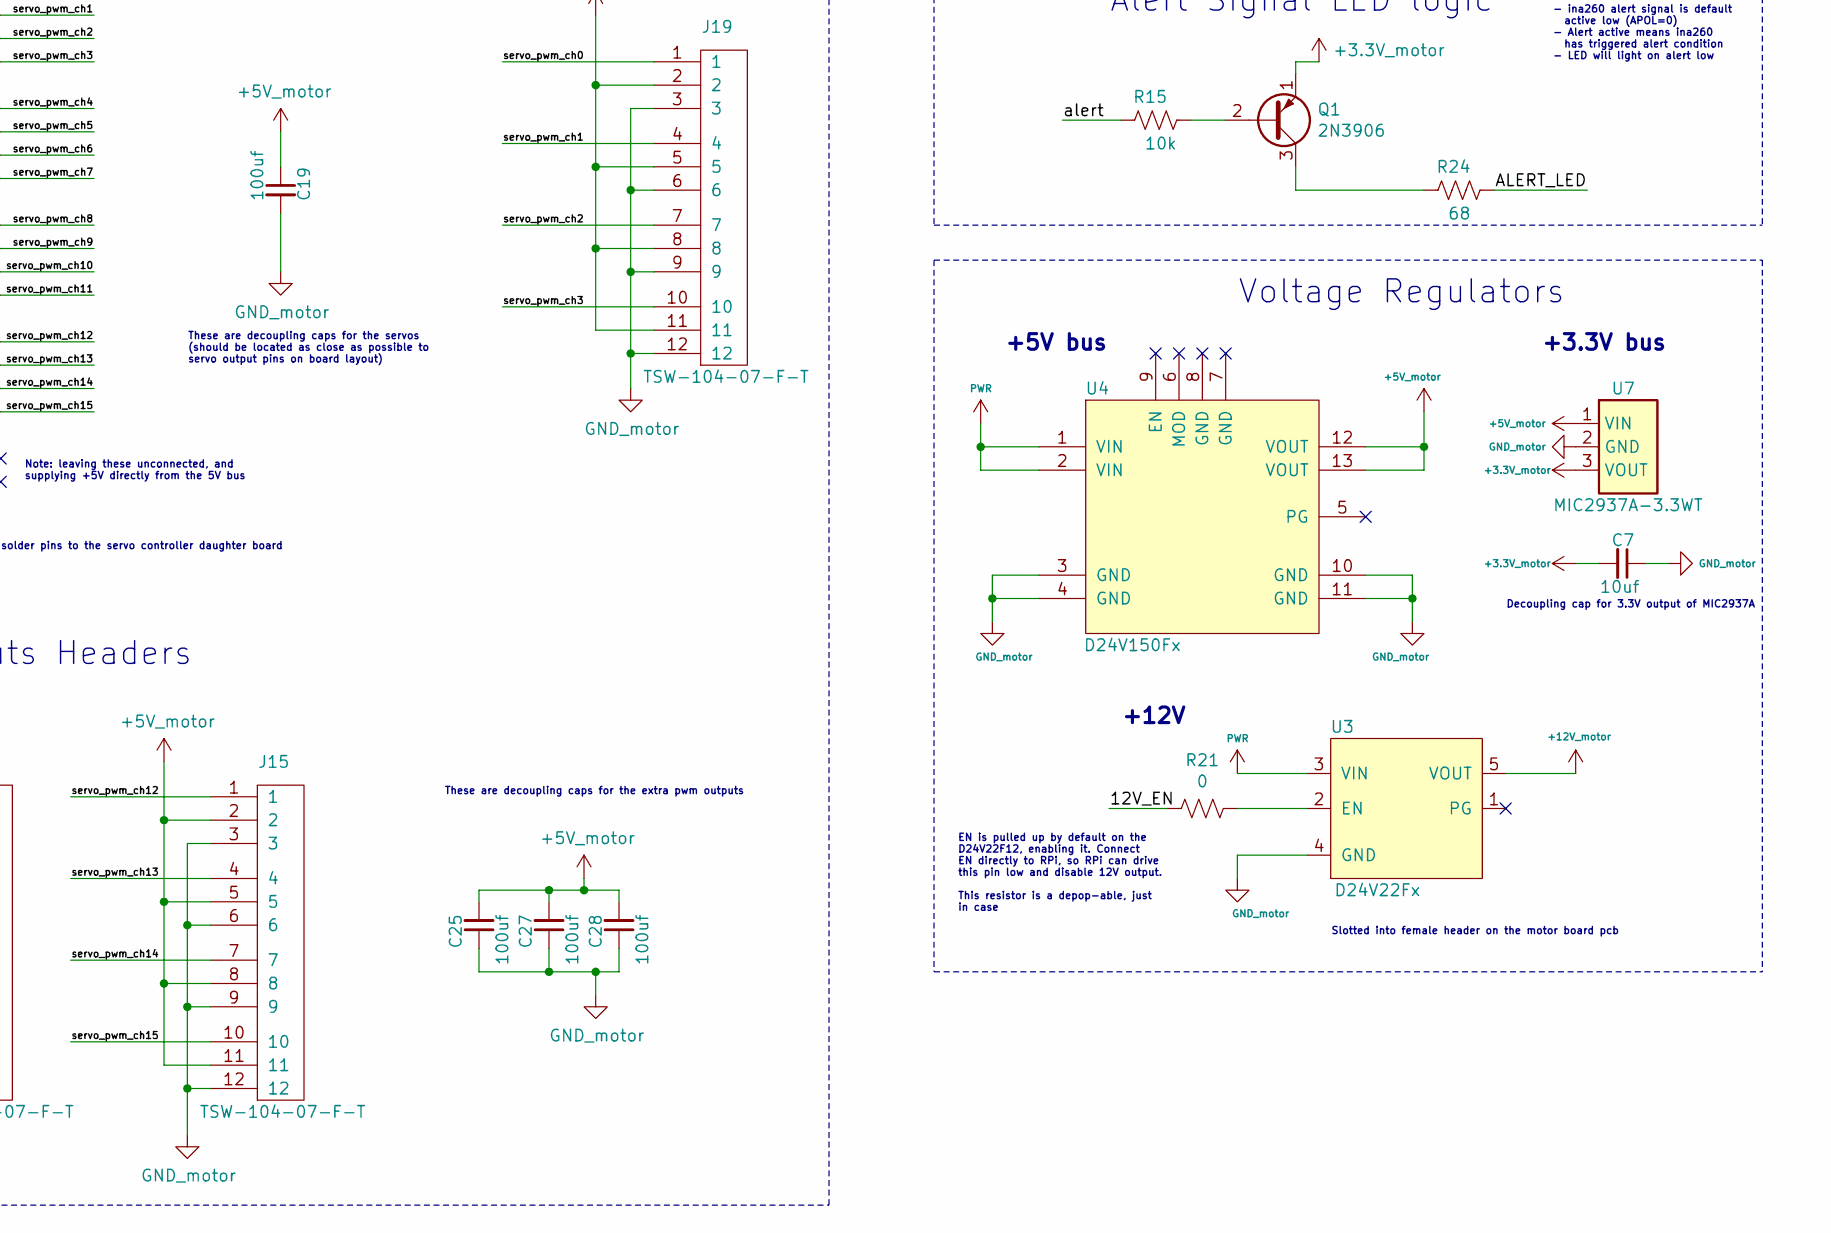
[picture p83: schematic Motor_Board.kicad_sch, Motor Board, part in row 2, column 2]

Parts:
C1, C3, C5, C6: 100nf; R_Axial_DIN0207_L6.3mm_D2.5mm_P7.62mm_Horizontal
C2, C4, C9, C10, C13, C14, C15, C16, C17, C18, C20, C21: 10nf; R_Axial_DIN0207_L6.3mm_D2.5mm_P7.62mm_Horizontal
C7: 10uf; CP_Radial_D8.0mm_P3.80mm
C19, C25, C27, C28: 100uf; CP_Radial_D8.0mm_P3.80mm
D1: D; 497-2738-5-ND
F1: Fuse; 696108003002_5x20_fuseholder
J1, J5: XT30-M; AMASS_XT30U-M_1x02_P5.0mm_Vertical
J2, J6: ED2580-ND
J3, J4: XT30-F; AMASS_XT30U-F_1x02_P5.0mm_Vertical
J7, J12, J15, J19: TSW-104-07-F-T; SSW-104-01-F-T
J8, J9, J10, J11, J13, J14: Molex_172675-0613
J16, J17, J18: 277-11404-ND
J20: PEC08SAAN; PinHeader_1x08_P2.54mm_Vertical
J21: PPTC102LFBN-RC
LOGO1: patch_silkscreen; patch_logo_scaled
MH1, MH2, MH3, MH4, MH5, MH6, MH7, MH8, MH17: #4THRU-HOLE
MH9, MH10, MH11, MH12: brain_board_mounting_hole
Q1: 2N3906; TO-92_Inline_Wide
R1, R6, R7: 1k; R_Axial_DIN0207_L6.3mm_D2.5mm_P7.62mm_Horizontal
R2, R3, R4, R5, R12, R13, R14: 4.7k; R_Axial_DIN0207_L6.3mm_D2.5mm_P7.62mm_Horizontal
R8: 680; R_Axial_DIN0207_L6.3mm_D2.5mm_P7.62mm_Horizontal
R9: 220; R_Axial_DIN0207_L6.3mm_D2.5mm_P7.62mm_Horizontal
R10: 100; R_Axial_DIN0207_L6.3mm_D2.5mm_P7.62mm_Horizontal
R15: 10k; R_Axial_DIN0207_L6.3mm_D2.5mm_P7.62mm_Horizontal
R21, R30: 0; R_Axial_DIN0207_L6.3mm_D2.5mm_P7.62mm_Horizontal
R24: 68; R_Axial_DIN0207_L6.3mm_D2.5mm_P7.62mm_Horizontal
RC1, RC2, RC3: RoboClaw; roboclaw_mount
T1, T2, T3, T4, T5, T6: test_point
T7, T8, T9, T10, T11, T12: test_point; test_point_hole
U1: INA260
U2: PCA9685; PCA9685_servo_controller
U3: D24V22Fx; D24V22Fx_regulator
U4: D24V150Fx
U5: DC7G3HWA; DC7G3HWA_led_array
U7: MIC2937A-3.3WT; TO-220-3_Vertical
y1: rover_silkscreen; rover_image

Connections:
+3.3V_motor: C1.2, C3.1, C7.2, J20.2, J21.13, J21.14, Q1.1 (E), R2.2, R3.2, R4.2, R5.1, R10.2, T8.1, U1.1 (VCC), U2.2 (VCC), U7.3 (VOUT)
+5V_motor: C5.1, C6.1, C19.1, C25.2, C27.2, C28.2, J7.2, J7.5, J7.8, J7.11, J8.4, J9.4, J10.4, J11.4, J12.2, J12.5, J12.8, J12.11, J13.4, J14.4, J15.2, J15.5, J15.8, J15.11, J19.2, J19.5, J19.8, J19.11, J20.3, J21.1, J21.2, R9.2, T9.1, U2.7 (V+), U4.12 (VOUT), U4.13 (VOUT), U7.1 (VIN)
+12V_motor: J6.1, J20.4, J21.9, J21.10, R8.2, T10.1, U3.5 (VOUT)
/Motor Board/12V_EN: J21.15, R21.2
/Motor Board/ALERT_LED: R24.1, U5.10
/Motor Board/BATT+: D1.1 (K), F1.1, J1.2, R6.2, T1.1, T11.1
/Motor Board/BATT-: J1.1, J4.1, T2.1
/Motor Board/E_STOP: J21.19, R2.1, R12.1, RC1.23 (S3I/O), RC2.23 (S3I/O), RC3.23 (S3I/O)
/Motor Board/E_STOP2: J21.20, R3.1, R13.1, RC1.24 (S4I/O), RC2.24 (S4I/O), RC3.24 (S4I/O)
/Motor Board/E_STOP3: J21.16, R4.1, R14.1, RC1.25 (S5I/O), RC2.25 (S5I/O), RC3.25 (S5I/O)
/Motor Board/MMLOAD+: J5.2, R30.2, T5.1, U1.7 (VIN+), U1.9 (VIN+)
/Motor Board/OEservos: J21.18, U2.5 (OE)
/Motor Board/RC1EN1A: C13.1, J8.5, RC1.7 (EN1A)
/Motor Board/RC1EN1B: C15.1, J8.6, RC1.8 (EN1B)
/Motor Board/RC1EN2A: C17.1, J9.5, RC1.9 (EN2A)
/Motor Board/RC1EN2B: C20.1, J9.6, RC1.10 (EN2B)
/Motor Board/RC1M1A: J8.1, J16.1
/Motor Board/RC1M1B: J8.2, J16.2
/Motor Board/RC1M2A: J9.1, J16.5
/Motor Board/RC1M2B: J9.2, J16.6
/Motor Board/RC2EN1A: C2.1, J10.5, RC2.7 (EN1A)
/Motor Board/RC2EN1B: C4.1, J10.6, RC2.8 (EN1B)
/Motor Board/RC2EN2A: C9.1, J11.5, RC2.9 (EN2A)
/Motor Board/RC2EN2B: C10.1, J11.6, RC2.10 (EN2B)
/Motor Board/RC2M1A: J10.1, J17.1
/Motor Board/RC2M1B: J10.2, J17.2
/Motor Board/RC2M2A: J11.1, J17.5
/Motor Board/RC2M2B: J11.2, J17.6
/Motor Board/RC3EN1A: C14.1, J13.5, RC3.7 (EN1A)
/Motor Board/RC3EN1B: C16.1, J13.6, RC3.8 (EN1B)
/Motor Board/RC3EN2A: C18.1, J14.5, RC3.9 (EN2A)
/Motor Board/RC3EN2B: C21.1, J14.6, RC3.10 (EN2B)
/Motor Board/RC3M1A: J13.1, J18.1
/Motor Board/RC3M1B: J13.2, J18.2
/Motor Board/RC3M2A: J14.1, J18.5
/Motor Board/RC3M2B: J14.2, J18.6
/Motor Board/RXD: J20.6, J21.4, RC1.22 (S2I/0), RC2.22 (S2I/0), RC3.22 (S2I/0)
/Motor Board/SCL_rpi: J20.7, J21.7, U1.3 (SCL), U2.4 (SCL)
/Motor Board/SDA_rpi: J20.8, J21.8, U1.4 (SDA), U2.3 (SDA)
/Motor Board/TXD: J20.5, J21.3, RC1.21 (S1I/O), RC2.21 (S1I/O), RC3.21 (S1I/O)
/Motor Board/alert: J21.17, R5.2, R15.2, U1.5 (ALERT)
/Motor Board/servo_pwm_ch0: J19.1, U2.9 (PWM_CHANNEL_0)
/Motor Board/servo_pwm_ch1: J19.4, U2.12 (PWM_CHANNEL_1)
/Motor Board/servo_pwm_ch2: J19.7, U2.15 (PWM_CHANNEL_2)
/Motor Board/servo_pwm_ch3: J19.10, U2.18 (PWM_CHANNEL_3)
/Motor Board/servo_pwm_ch4: J7.1, U2.21 (PWM_CHANNEL_4)
/Motor Board/servo_pwm_ch5: J7.4, U2.24 (PWM_CHANNEL_5)
/Motor Board/servo_pwm_ch6: J7.7, U2.27 (PWM_CHANNEL_6)
/Motor Board/servo_pwm_ch7: J7.10, U2.30 (PWM_CHANNEL_7)
/Motor Board/servo_pwm_ch8: J12.1, U2.33 (PWM_CHANNEL_8)
/Motor Board/servo_pwm_ch9: J12.4, U2.36 (PWM_CHANNEL_9)
/Motor Board/servo_pwm_ch10: J12.7, U2.39 (PWM_CHANNEL_10)
/Motor Board/servo_pwm_ch11: J12.10, U2.42 (PWM_CHANNEL_11)
/Motor Board/servo_pwm_ch12: J15.1, U2.45 (PWM_CHANNEL_12)
/Motor Board/servo_pwm_ch13: J15.4, U2.48 (PWM_CHANNEL_13)
/Motor Board/servo_pwm_ch14: J15.7, U2.51 (PWM_CHANNEL_14)
/Motor Board/servo_pwm_ch15: J15.10, U2.54 (PWM_CHANNEL_15)
/Motor Board/switch_in: D1.2 (A), F1.2, J3.1, R1.2, T3.1
/Motor Board/switch_out: J3.2, J4.2, R1.1, T4.1
GND_motor: C1.1, C2.2, C3.2, C4.2, C5.2, C6.2, C7.1, C9.2, C10.2, C13.2, C14.2, C15.2, C16.2, C17.2, C18.2, C19.2, C20.2, C21.2, C25.1, C27.1, C28.1, J2.2, J5.1, J6.2, J7.3, J7.6, J7.9, J7.12, J8.3, J9.3, J10.3, J11.3, J12.3, J12.6, J12.9, J12.12, J13.3, J14.3, J15.3, J15.6, J15.9, J15.12, J16.4, J17.4, J18.4, J19.3, J19.6, J19.9, J19.12, J20.1, J21.5, J21.6, R12.2, R13.2, R14.2, T7.1, U1.2 (GND), U2.6 (SIG_GND), U2.8 (GND), U3.4 (GND), U4.3 (GND), U4.4 (GND), U4.10 (GND), U4.11 (GND), U5.11, U5.12, U5.13, U5.14, U5.15, U5.16, U5.17, U5.18, U5.19, U5.20, U7.2 (GND)
unnamed: Q1.2 (B), R15.1
unnamed: Q1.3 (C), R24.2
unnamed: R6.1, U5.1
unnamed: R7.1, U5.2
unnamed: R8.1, U5.3
unnamed: R9.1, U5.4
unnamed: R10.1, U5.5
unnamed: R21.1, U3.2 (EN)
PWR: J2.1, J16.3, J17.3, J18.3, R7.2, R30.1, T6.1, T12.1, U1.8 (VIN-), U1.10 (VIN-), U3.3 (VIN), U4.1 (VIN), U4.2 (VIN)

Notes on the sheet:
(depop) Bypass for INA260
For mounting to to rover structure
These are decoupling caps for the extra pwm outputs
1. MM DC+ is internally connected to MM LOAD+
Test Pin Header
Power LEDs
+3.3V bus
Motor LEDs
Decoupling cap for 3.3V output of MIC2937A
Note: laid out the pins on this connector so that it wouldn’t be disastrous if the direction was accidentally switched (but please don’t try it)
RoboClaw Pin Header
Multimeter Notes
Option 2: Pullldowns for e_stop signals Populate to e-stop by default (don’t populate at same time as Option 1!)
2. MM DC- has a low resistance connection to MM LOAD-
Voltage Regulators
Switch
Battery Out (for optional daisychaining)
Misc 12V header for external use
Miscellaneous
MM LOAD
Note: leaving these unconnected, and supplying +5V directly from the 5V bus
Battery
Roboclaw Motor Connection Output
For mounting brain board
Power to Rover
Filtering caps for cheap snubber circuits on motors
Power Test Points
Remeber this fuse goes with PN: 507-2121-ND
Multimeter
3. PCB ground connects to battery- via MM LOAD- and MM DC-
Inter-Board Connection
D1 and R1 are protective circuitry for the roboclaw motors. See page 41 of the roboclaw user manual for details: https://downloads.basicmicro.com/docs/roboclaw_user_manual.pdf
Slotted into female header on the motor board pcb
Option 1: Pulllups for e_stop signals Populate to NOT e-stop by default
Headers on the motor board are female, and solder pins to the servo controller daughter board
Note: V+ left unconnected
+12V
MM DC
+5V bus
EN is pulled up by default on the D24V22F12, enabling it. Connect EN directly to RPi, so RPi can drive this pin low and disable 12V output. This resistor is a depop-able, just in case
Corner Steering Servos Header
These are decoupling caps for the servos (should be located as close as possible to servo output pins on board layout)
Extra PWM Outputs Headers
Roboclaw Power BUS
Alert Signal LED logic
- Power LEDs are normally on - Only BATT+ (and PWR) on when power switch is off - Alert only turns on when ina260 hits alert condition (bad)
Note: D1 is NOT protection against accidentally reversing the battery polarity!
Power Distribution
- ina260 alert signal is default active low (APOL=0) - Alert active means ina260 has triggered alert condition - LED will light on alert low

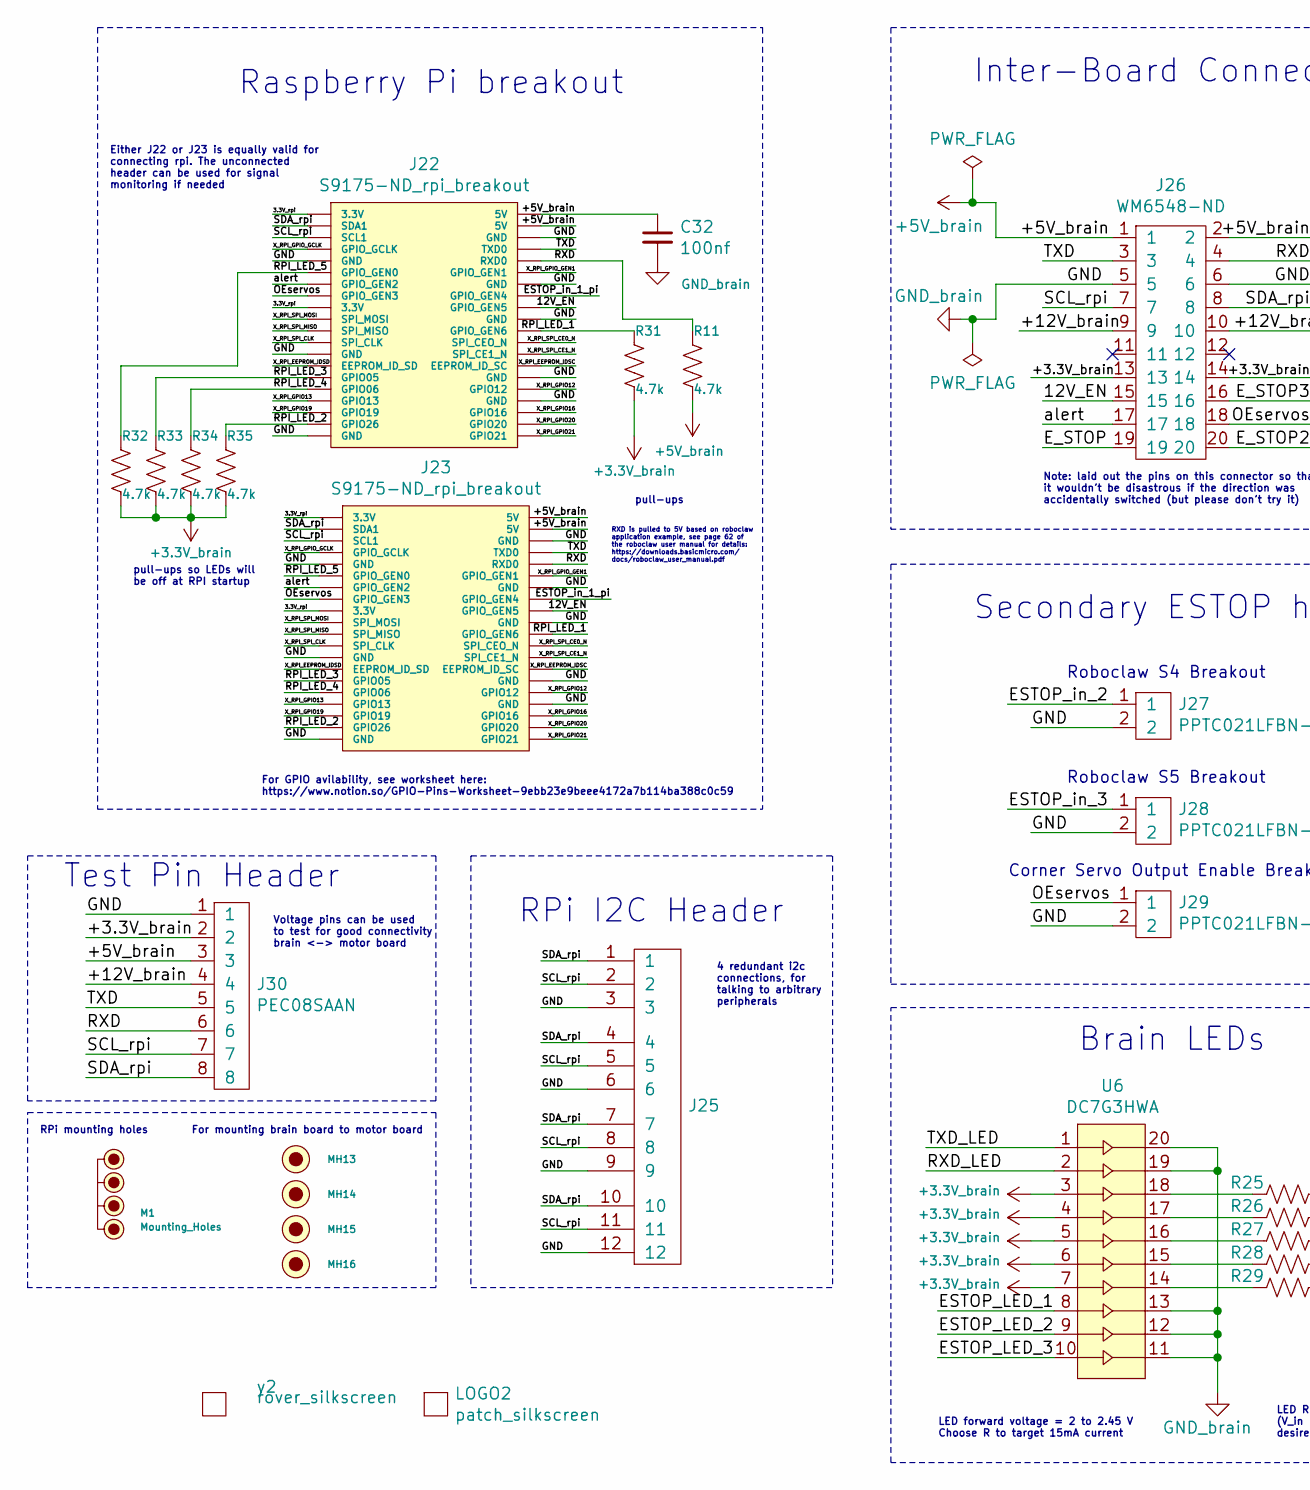
[picture p84: schematic Brain_Board.kicad_sch, Brain Board, part in row 1, column 1]

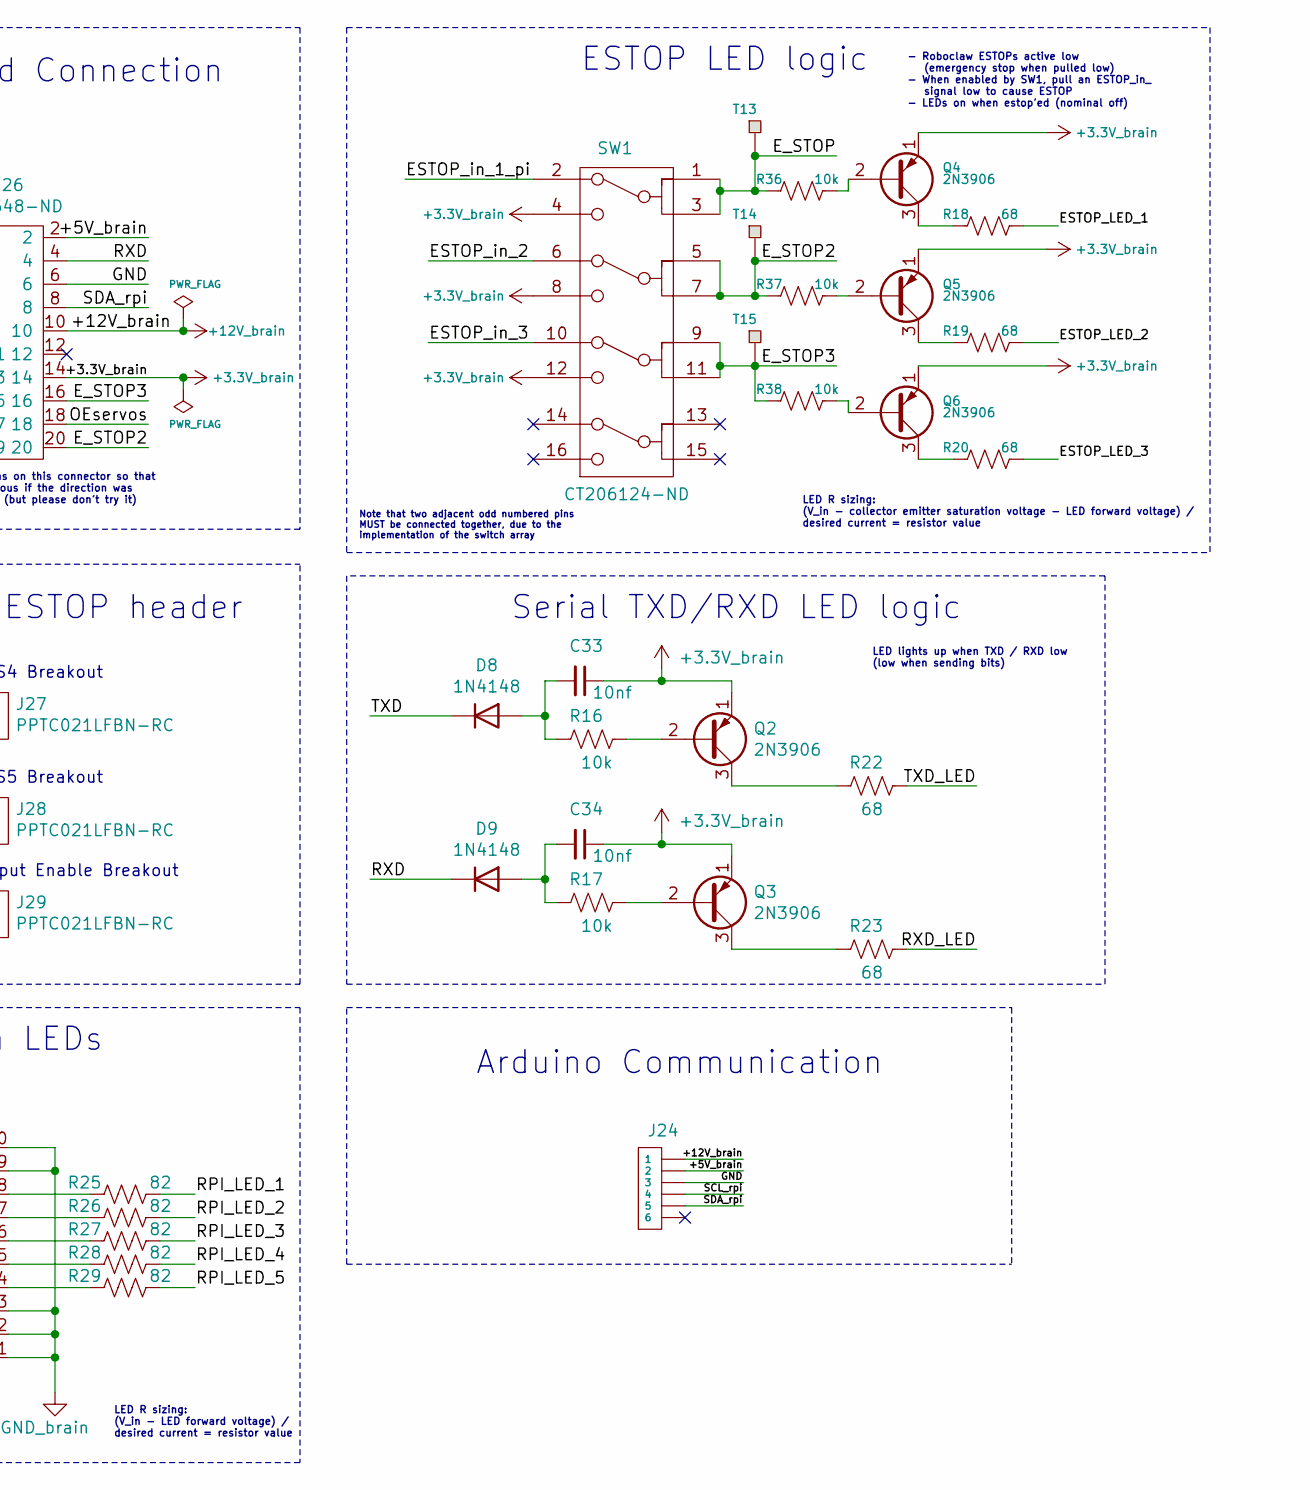
[picture p85: schematic Brain_Board.kicad_sch, Brain Board, part in row 1, column 2]

Parts:
C32: 100nf; R_Axial_DIN0207_L6.3mm_D2.5mm_P7.62mm_Horizontal
C33, C34: 10nf; R_Axial_DIN0207_L6.3mm_D2.5mm_P7.62mm_Horizontal
D8, D9: 1N4148; D_DO-35_SOD27_P7.62mm_Horizontal
J22, J23: S9175-ND_rpi_breakout; S9175-ND
J24: 6posheader; 455-1708-ND
J25: SSW-104-01-F-T
J26: WM6548-ND
J27, J28, J29: PPTC021LFBN-RC
J30: PEC08SAAN; PinHeader_1x08_P2.54mm_Vertical
LOGO2: patch_silkscreen; patch_logo_scaled
M1: Mounting_Holes; raspberry_pi_3b
MH13, MH14, MH15, MH16: brain_board_mounting_hole
Q2, Q3, Q4, Q5, Q6: 2N3906; TO-92_Inline_Wide
R11, R31, R32, R33, R34, R35: 4.7k; R_Axial_DIN0207_L6.3mm_D2.5mm_P7.62mm_Horizontal
R16, R17, R36, R37, R38: 10k; R_Axial_DIN0207_L6.3mm_D2.5mm_P7.62mm_Horizontal
R18, R19, R20, R22, R23: 68; R_Axial_DIN0207_L6.3mm_D2.5mm_P7.62mm_Horizontal
R25, R26, R27, R28, R29: 82; R_Axial_DIN0207_L6.3mm_D2.5mm_P7.62mm_Horizontal
SW1: CT206124-ND; CTS-206-124
T13, T14, T15: test_point
U6: DC7G3HWA; DC7G3HWA_led_array
y2: rover_silkscreen; rover_image

Connections:
+3.3V_brain: C33.1, C34.1, J26.13, J26.14, J30.2, Q2.1 (E), Q3.1 (E), Q4.1 (E), Q5.1 (E), Q6.1 (E), R31.2, R32.2, R33.2, R34.2, R35.2, SW1.4 (out1_2), SW1.8 (out2_2), SW1.12 (out3_2), U6.3, U6.4, U6.5, U6.6, U6.7
+5V_brain: C32.1, J22.2 (5V), J22.4 (5V), J23.2 (5V), J23.4 (5V), J24.2, J26.1, J26.2, J30.3, R11.2
+12V_brain: J24.1, J26.9, J26.10, J30.4
/Brain Board/3.3V_rpi: J22.1 (3.3V), J22.17 (3.3V), J23.1 (3.3V), J23.17 (3.3V)
/Brain Board/12V_EN: J22.18 (GPIO_GEN5), J23.18 (GPIO_GEN5), J26.15
/Brain Board/ESTOP_LED_1: R18.1, U6.8
/Brain Board/ESTOP_LED_2: R19.1, U6.9
/Brain Board/ESTOP_LED_3: R20.1, U6.10
/Brain Board/ESTOP_in_1_pi: J22.16 (GPIO_GEN4), J23.16 (GPIO_GEN4), SW1.2 (out1_1)
/Brain Board/ESTOP_in_2: J27.1, SW1.6 (out2_1)
/Brain Board/ESTOP_in_3: J28.1, SW1.10 (out3_1)
/Brain Board/E_STOP: J26.19, R36.2, SW1.1 (in1_1), SW1.3 (in1_2), T13.1
/Brain Board/E_STOP2: J26.20, R37.2, SW1.5 (in2_1), SW1.7 (in2_2), T14.1
/Brain Board/E_STOP3: J26.16, R38.2, SW1.9 (in3_1), SW1.11 (in3_2), T15.1
/Brain Board/OEservos: J22.15 (GPIO_GEN3), J23.15 (GPIO_GEN3), J26.18, J29.1
/Brain Board/RPI_LED_1: J22.22 (GPIO_GEN6), J23.22 (GPIO_GEN6), R25.1, R31.1
/Brain Board/RPI_LED_2: J22.37 (GPIO26), J23.37 (GPIO26), R26.1, R35.1
/Brain Board/RPI_LED_3: J22.29 (GPIO05), J23.29 (GPIO05), R27.1, R33.1
/Brain Board/RPI_LED_4: J22.31 (GPIO06), J23.31 (GPIO06), R28.1, R34.1
/Brain Board/RPI_LED_5: J22.11 (GPIO_GEN0), J23.11 (GPIO_GEN0), R29.1, R32.1
/Brain Board/RXD: D9.1 (K), J22.10 (RXD0), J23.10 (RXD0), J26.4, J30.6, R11.1
/Brain Board/RXD_LED: R23.1, U6.2
/Brain Board/SCL_rpi: J22.5 (SCL1), J23.5 (SCL1), J24.4, J25.2, J25.5, J25.8, J25.11, J26.7, J30.7
/Brain Board/SDA_rpi: J22.3 (SDA1), J23.3 (SDA1), J24.5, J25.1, J25.4, J25.7, J25.10, J26.8, J30.8
/Brain Board/TXD: D8.1 (K), J22.8 (TXD0), J23.8 (TXD0), J26.3, J30.5
/Brain Board/TXD_LED: R22.1, U6.1
/Brain Board/X_RPI_EEPROM_IDSC: J22.28 (EEPROM_ID_SC), J23.28 (EEPROM_ID_SC)
/Brain Board/X_RPI_EEPROM_IDSD: J22.27 (EEPROM_ID_SD), J23.27 (EEPROM_ID_SD)
/Brain Board/X_RPI_GPIO12: J22.32 (GPIO12), J23.32 (GPIO12)
/Brain Board/X_RPI_GPIO13: J22.33 (GPIO13), J23.33 (GPIO13)
/Brain Board/X_RPI_GPIO16: J22.36 (GPIO16), J23.36 (GPIO16)
/Brain Board/X_RPI_GPIO19: J22.35 (GPIO19), J23.35 (GPIO19)
/Brain Board/X_RPI_GPIO20: J22.38 (GPIO20), J23.38 (GPIO20)
/Brain Board/X_RPI_GPIO21: J22.40 (GPIO21), J23.40 (GPIO21)
/Brain Board/X_RPI_GPIO_GCLK: J22.7 (GPIO_GCLK), J23.7 (GPIO_GCLK)
/Brain Board/X_RPI_GPIO_GEN1: J22.12 (GPIO_GEN1), J23.12 (GPIO_GEN1)
/Brain Board/X_RPI_SPI_CE0_N: J22.24 (SPI_CEO_N), J23.24 (SPI_CEO_N)
/Brain Board/X_RPI_SPI_CE1_N: J22.26 (SPI_CE1_N), J23.26 (SPI_CE1_N)
/Brain Board/X_RPI_SPI_CLK: J22.23 (SPI_CLK), J23.23 (SPI_CLK)
/Brain Board/X_RPI_SPI_MISO: J22.21 (SPI_MISO), J23.21 (SPI_MISO)
/Brain Board/X_RPI_SPI_MOSI: J22.19 (SPI_MOSI), J23.19 (SPI_MOSI)
/Brain Board/alert: J22.13 (GPIO_GEN2), J23.13 (GPIO_GEN2), J26.17
GND_brain: C32.2, J22.6 (GND), J22.9 (GND), J22.14 (GND), J22.20 (GND), J22.25 (GND), J22.30 (GND), J22.34 (GND), J22.39 (GND), J23.6 (GND), J23.9 (GND), J23.14 (GND), J23.20 (GND), J23.25 (GND), J23.30 (GND), J23.34 (GND), J23.39 (GND), J24.3, J25.3, J25.6, J25.9, J25.12, J26.5, J26.6, J27.2, J28.2, J29.2, J30.1, U6.11, U6.12, U6.13, U6.19, U6.20
unnamed: C33.2, D8.2 (A), R16.2
unnamed: C34.2, D9.2 (A), R17.2
unnamed: Q2.2 (B), R16.1
unnamed: Q2.3 (C), R22.2
unnamed: Q3.2 (B), R17.1
unnamed: Q3.3 (C), R23.2
unnamed: Q4.2 (B), R36.1
unnamed: Q4.3 (C), R18.2
unnamed: Q5.2 (B), R37.1
unnamed: Q5.3 (C), R19.2
unnamed: Q6.2 (B), R38.1
unnamed: Q6.3 (C), R20.2
unnamed: R25.2, U6.18
unnamed: R26.2, U6.17
unnamed: R27.2, U6.16
unnamed: R28.2, U6.15
unnamed: R29.2, U6.14

Notes on the sheet:
4 redundant i2c connections, for talking to arbitrary peripherals
Voltage pins can be used to test for good connectivity brain <-> motor board
- Roboclaw ESTOPs active low (emergency stop when pulled low) - When enabled by SW1, pull an ESTOP_in_ signal low to cause ESTOP - LEDs on when estop’ed (nominal off)
LED R sizing: (V_in - collector emitter saturation voltage - LED forward voltage) / desired current = resistor value
RXD is pulled to 5V based on roboclaw application example, see page 62 of the roboclaw user manual for details: https://downloads.basicmicro.com/ docs/roboclaw_user_manual.pdf
RPi I2C Header
Inter-Board Connection
ESTOP LED logic
pull-ups so LEDs will be off at RPI startup
For mounting brain board to motor board
RPi mounting holes
Note that two adjacent odd numbered pins MUST be connected together, due to the implementation of the switch array
Arduino Communication
Brain LEDs
Serial TXD/RXD LED logic
Note: laid out the pins on this connector so that it wouldn’t be disastrous if the direction was accidentally switched (but please don’t try it)
Raspberry Pi breakout
LED forward voltage = 2 to 2.45 V Choose R to target 15mA current
Roboclaw S4 Breakout
Corner Servo Output Enable Breakout
Test Pin Header
pull-ups
LED R sizing: (V_in - LED forward voltage) / desired current = resistor value
LED lights up when TXD / RXD low (low when sending bits)
Roboclaw S5 Breakout
For GPIO avilability, see worksheet here: https://www.notion.so/GPIO-Pins-Worksheet-9ebb23e9beee4172a7b114ba388c0c59
Secondary ESTOP header
Either J22 or J23 is equally valid for connecting rpi. The unconnected header can be used for signal monitoring if needed
