NickelsLab/open-source-rover/electrical/pcb/control_board/Control_Boards.kicad_pcb

## KiCad design electrical/pcb/control_board/Control_Boards.kicad_pcb (continued)

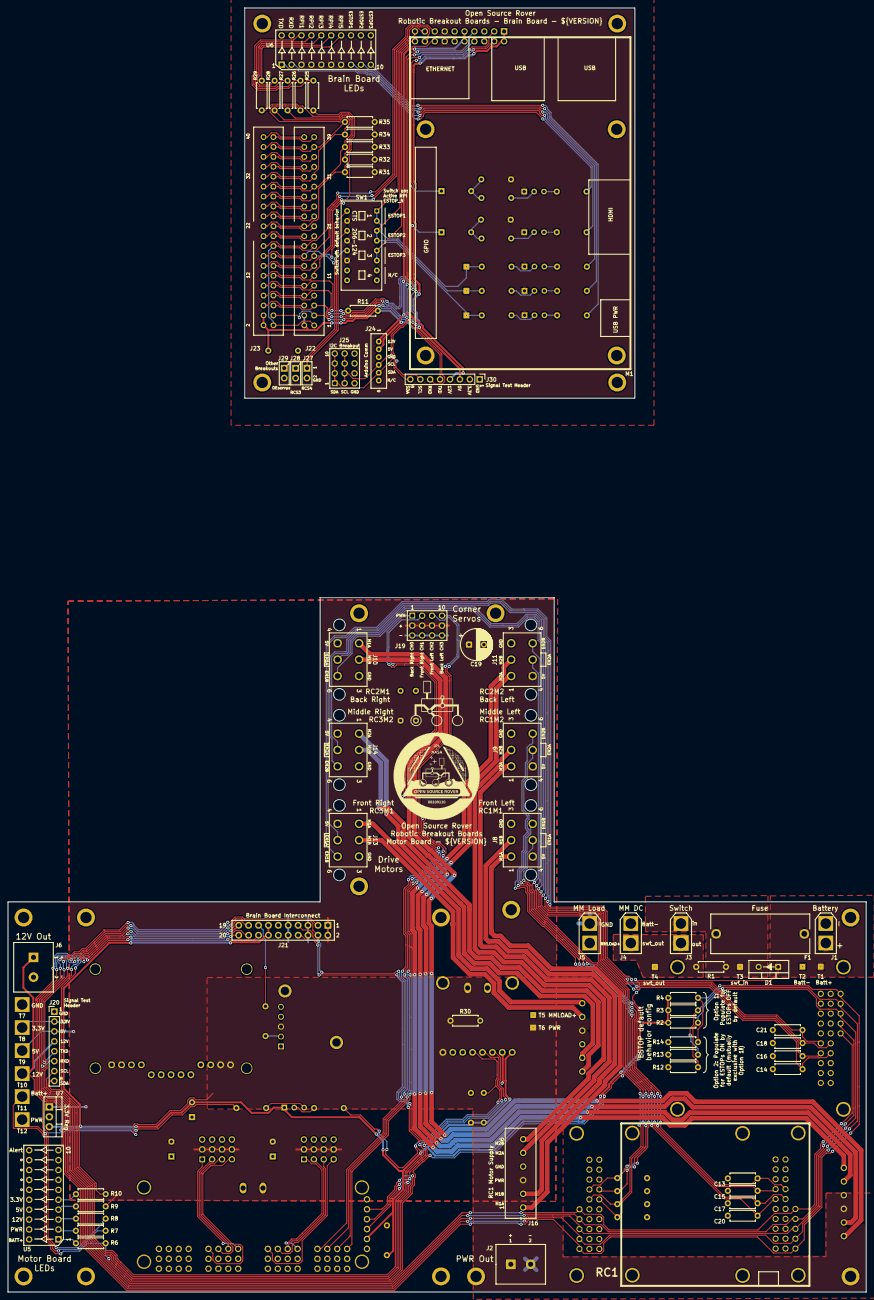
[picture p86: board Control_Boards.kicad_pcb from above]

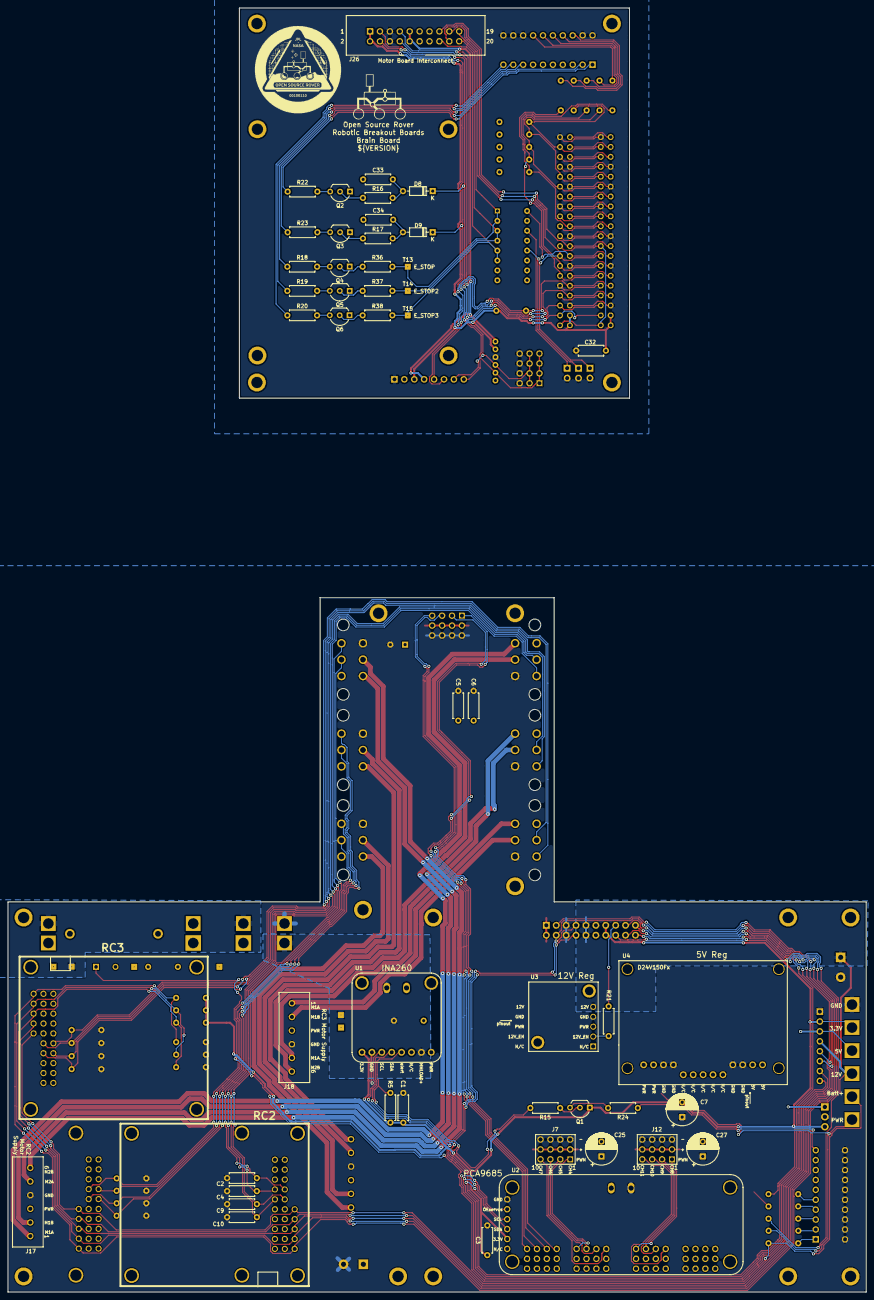
[picture p87: board Control_Boards.kicad_pcb from below]

Board: 2 copper layers, 220.0 x 329.2 mm, 148 parts (51 on the bottom side), 125 nets.
