NickelsLab/open-source-rover/(commit log)

2026-08-26 update to kicad10, bump rev on back of motor board to v2.0.3
    [Control_Boards.kicad_pcb]
2026-08-26 generate 3d_images for v2.0.3, and add script to automate that process
    [brain_board.kicad_pcb, motor_board.kicad_pcb, roboclaw_2x7a_headers_standoffs.step]
2026-08-27 update schematics to kicad 10, add titles and versions to title blocks
    [Brain_Board.kicad_sch, Brain_Board.sch, Control_Boards.kicad_sch, Control_Boards.sch, Motor_Board.kicad_sch, Motor_Board.sch]
2026-08-27 updated export_schematic script to expand ${VERSION} properly, plus new schematics and 3d_images
    [Control_Boards.kicad_pcb]
2026-09-02 add gerbers for v2.0.3, and export script
    [brain_board-B_Cu.gbl, brain_board-B_Mask.gbs, brain_board-B_Silkscreen.gbo, brain_board-Edge_Cuts.gm1, brain_board-F_Cu.gtl, brain_board-F_Mask.gts, brain_board-F_Silkscreen.gto, brain_board-job.gbrjob]
2026-09-02 Remove old control board revs. Based on discussion in https://github.com/nasa-jpl/open-source-rover/issues/444, remove documentation of old versions of control boards.
    [Arduino_uno_sheild-B.Cu.gbr, Arduino_uno_sheild-B.Mask.gbr, Arduino_uno_sheild-B.Paste.gbr, Arduino_uno_sheild-B.SilkS.gbr, Arduino_uno_sheild-Edge.Cuts.gbr, Arduino_uno_sheild-F.Cu.gbr, Arduino_uno_sheild-F.Mask.gbr, Arduino_uno_sheild-F.Paste.gbr]
2026-09-02 Remove more old control board revs, reorg images.
2026-09-02 Fix figure cross-references and normalize "Figure" capitalization
    Inserting "Figure 3.17: INA260 bypassed" shifted every later section-3
    caption by one, but the renumbering pass only matched capital-F "Figure".
    The 17 lowercase "figure N.N" prose references were left behind, so nine
    of them pointed one figure short of their subject -- e.g. the 3.3V
    regulator direction cited "U7 footprint" rather than the photo of the
    regulator installed in U7.
    Repoints those nine at the captions they describe, verified by matching
    each reference against the caption text at 83fcd96 (before the shift):
    3.23 -> 3.24 3.3V regulator orientation
    3.24 -> 3.25 C7 polarity
    3.32 -> 3.33 headers in the U2 fo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
2026-09-02 Fixed a couple figure refs, renamed schematic readme to something more obvious
2026-09-02 Clear TODOs from #444 and #451 - specify standoffs (#551)
    * Clear 1/3 TODOs from #444
    * Add standoff specs from Issue #451 to README
2026-09-02 moved documentation, BOM, and gerbers from v2.0.3 folders to unversioned folders up one level.
    [bom_v2.0.3_board_ref_parts.csv, bom_v2.0.3_other_parts.csv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]
