NickelsLab/open-source-rover/electrical/pcb/images/assembly/IMG_0827.jpeg

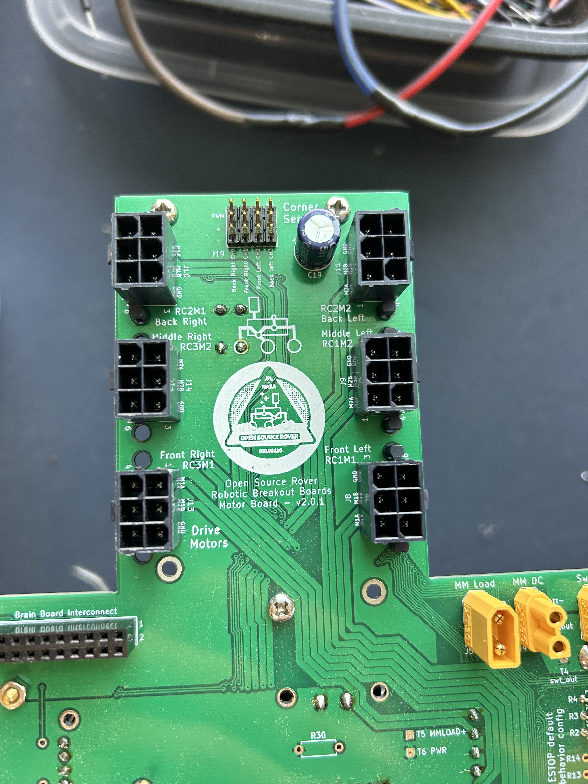
[picture p52: electrical/pcb/images/assembly/IMG_0827.jpeg]
electrical/pcb/images/assembly/IMG_0827.jpeg
