NickelsLab/open-source-rover/electrical/pcb/images/assembly/IMG_1491.jpeg

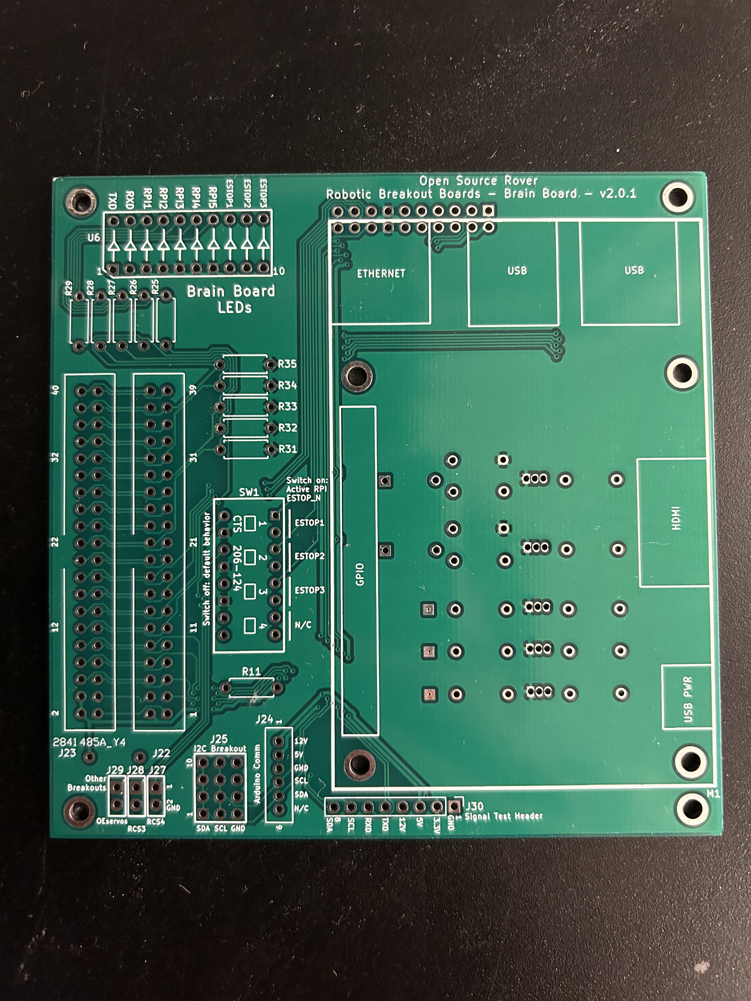
[picture p53: electrical/pcb/images/assembly/IMG_1491.jpeg]
electrical/pcb/images/assembly/IMG_1491.jpeg
