NickelsLab/open-source-rover/electrical/pcb/images/assembly/IMG_1492.jpeg

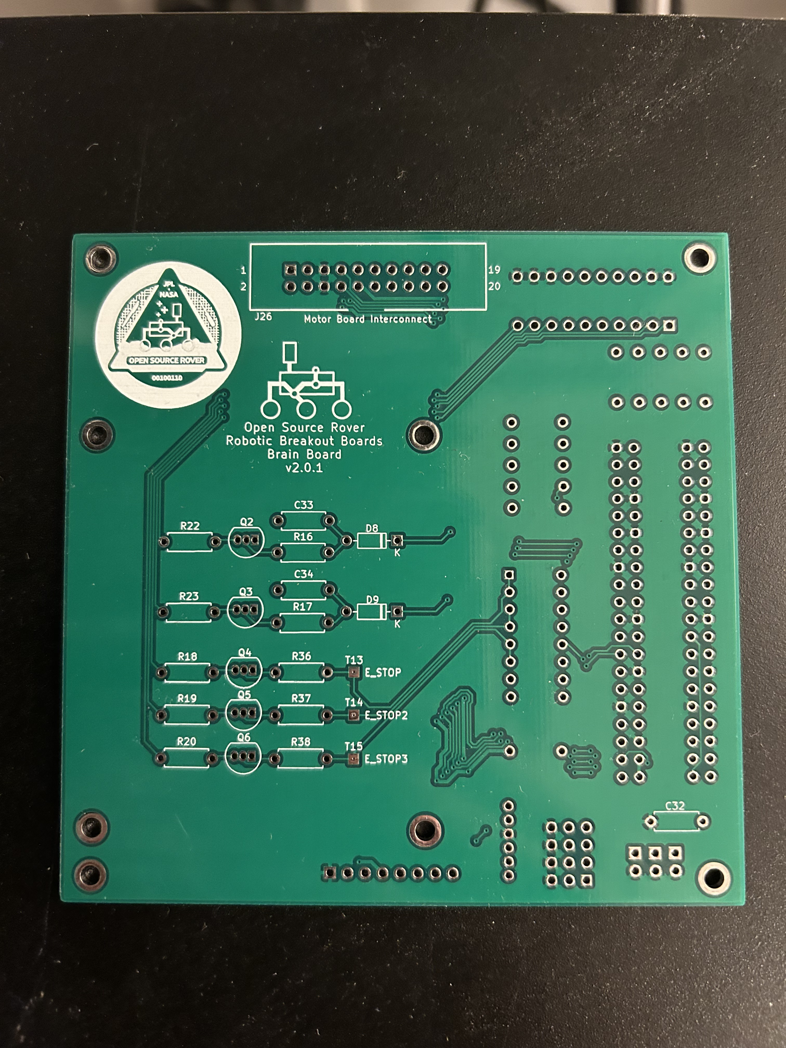
[picture p54: electrical/pcb/images/assembly/IMG_1492.jpeg]
electrical/pcb/images/assembly/IMG_1492.jpeg
