NickelsLab/open-source-rover/electrical/pcb/images/assembly/IMG_0834.jpeg

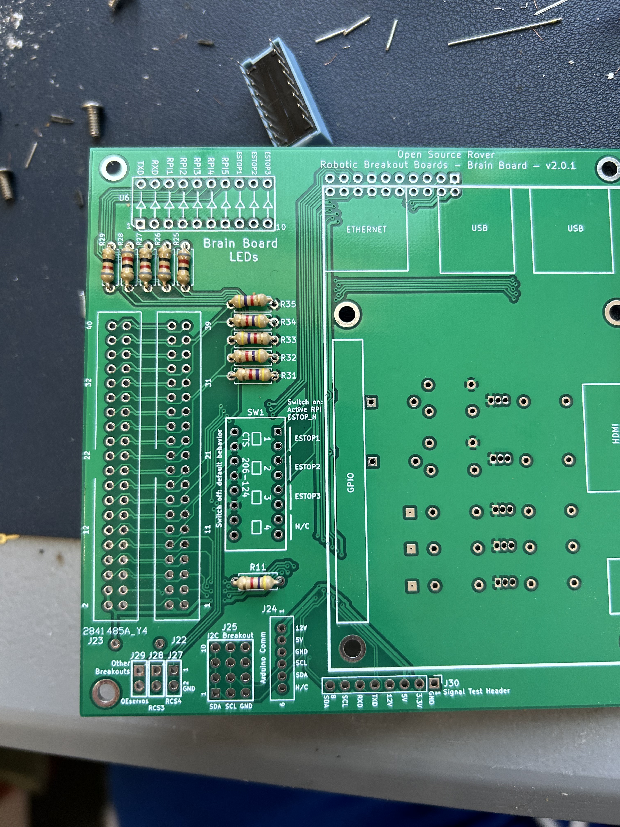
[picture p55: electrical/pcb/images/assembly/IMG_0834.jpeg]
electrical/pcb/images/assembly/IMG_0834.jpeg
