NickelsLab/open-source-rover/electrical/pcb/images/assembly/IMG_0832.jpeg

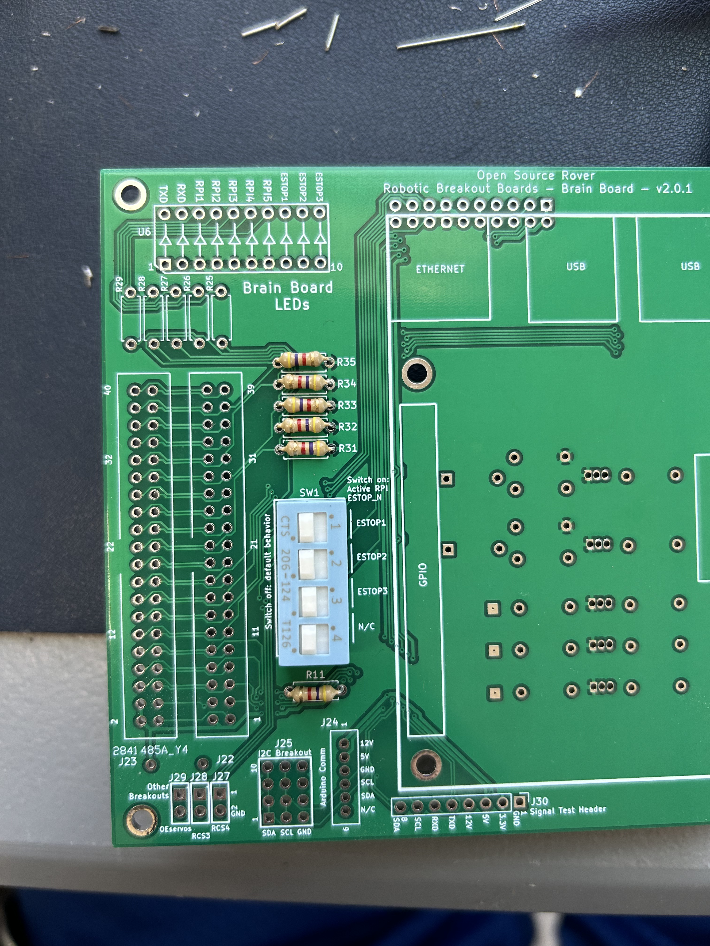
[picture p56: electrical/pcb/images/assembly/IMG_0832.jpeg]
electrical/pcb/images/assembly/IMG_0832.jpeg
