NickelsLab/open-source-rover/electrical/pcb/images/assembly/IMG_0841.jpeg

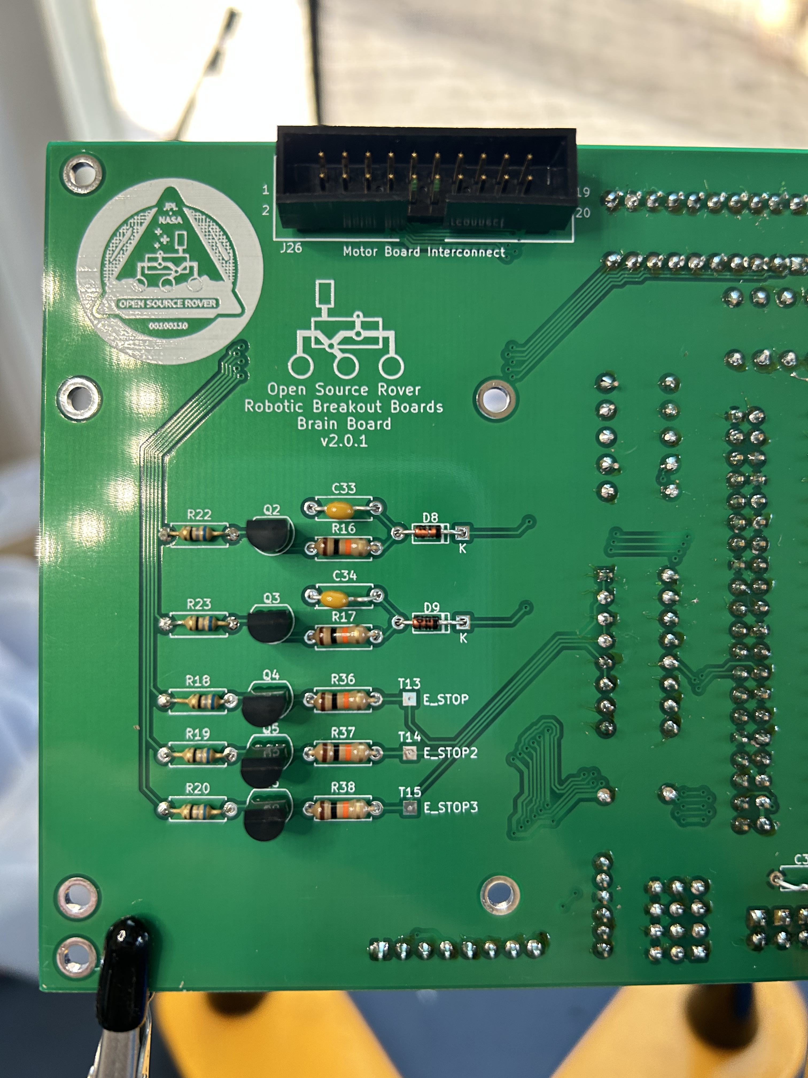
[picture p59: electrical/pcb/images/assembly/IMG_0841.jpeg]
electrical/pcb/images/assembly/IMG_0841.jpeg
