NickelsLab/open-source-rover/electrical/pcb/images/assembly/IMG_0844.jpeg

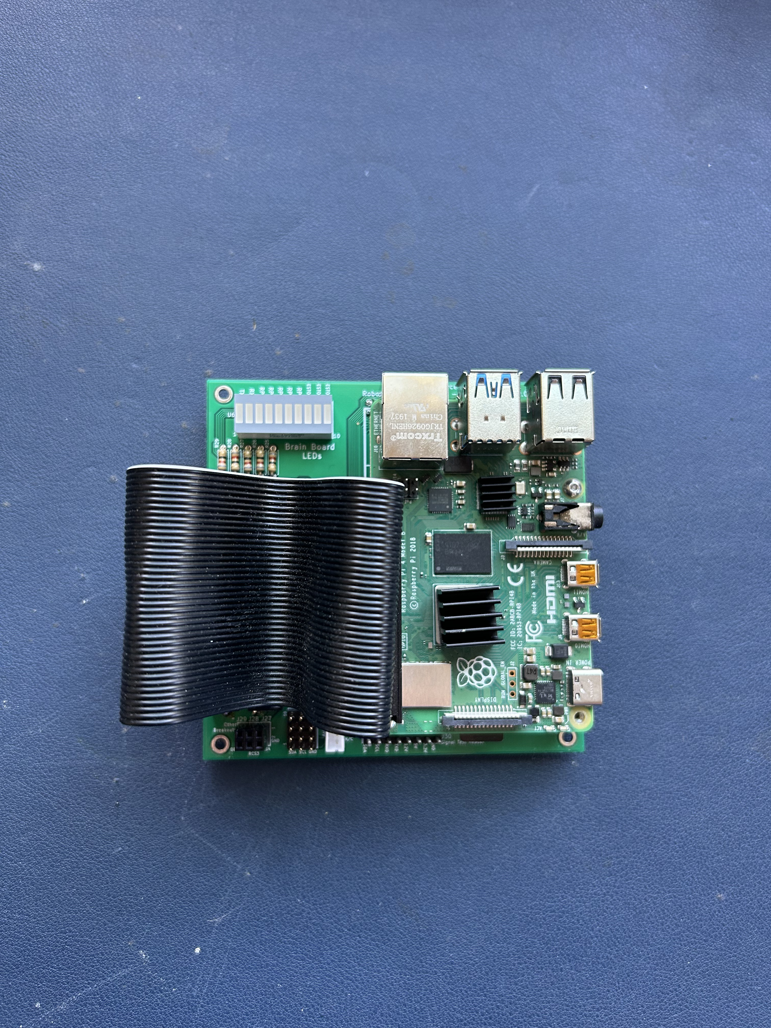
[picture p60: electrical/pcb/images/assembly/IMG_0844.jpeg]
electrical/pcb/images/assembly/IMG_0844.jpeg
