NickelsLab/open-source-rover/electrical/pcb/images/assembly/IMG_0845.jpeg

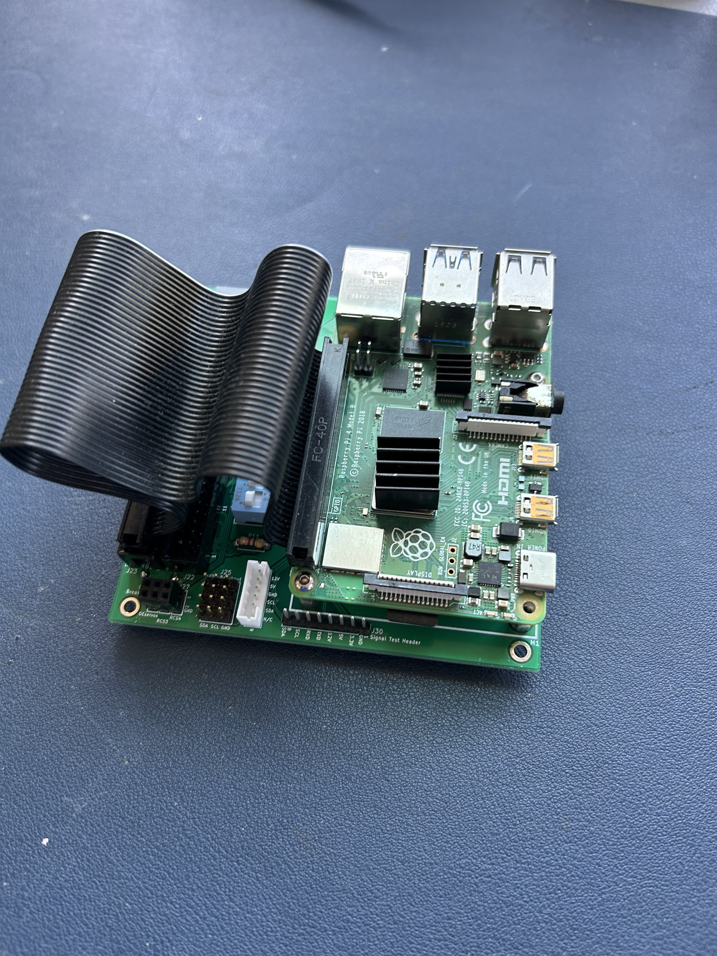
[picture p61: electrical/pcb/images/assembly/IMG_0845.jpeg]
electrical/pcb/images/assembly/IMG_0845.jpeg
